lcw578/STM32-project/README.md

# STM32 Boost 恒压恒流电源（课程设计）

> **一句话**：STM32F103 数字控制的 Boost 升压电源——5V 输入、12V/0.5A 输出、100kHz 开关、PI 闭环，带过压/过流/断线三重保护。
>
> 工程名 `boost-cccv-psu`（嘉立创 EDA 专业版）｜ 当前版本 **v3 重建版（2026-11-05 发板）** ｜ 状态：**已提交嘉立创加工，待收板**

| 关键指标 | 要求 | v3 重建版仿真结果 |
|---|---|---|
| 输出电压 | 12V ±5% | **+0.075%** |
| 输出纹波 | ≤5% | **1.81%** |
| 恒流精度 | 0.5A ±5% | **−0.18%** |
| 软启动过冲 | 无过冲/不触 OVP | **49mV** |
| 保护 | OVP / OCP | OVP 13.2V 锁存 / OCP **0.6A**·5ms 锁存 |
| 输入跌落 | 5V±5% | 输出偏移 **20mV** |
| 效率 | 实测 ≥75% | 预算 ~87%，**待上板实测** |

---

## 一、目录导览（组员按这个顺序读）

| 顺序 | 文件/目录 | 是什么 |
|---|---|---|
| 0 | **本 README** | 项目全貌与协作方式 |
| 1 | `01_系统设计方案.md` | 指标、方案、选型、引脚分配（**v2 已修订对齐实装**） |
| 2 | `02_仿真验证计划.md` | 仿真的科目表（S1~S10）怎么设计的 |
| 3 | `03_仿真验证报告.md` | 全部仿真证据；**§11 是 v2 终版指标对齐表**（§5/§7 为 v1 历史） |
| 4 | `04_设计审计与整改清单.md` | 第二版之前发现的所有问题及处置（含闭环标注） |
| 5 | `05_第二版改版说明.md` | v2 改了什么、验证结果、遗留项 |
| 6 | `06_固件v2说明.md` | 固件架构、复跑数据、上板调试验证清单（v2.1 常数变更见其末节） |
| 7 | `07_3D干涉检查.md` | 3D 模型与装配约束 |
| 8 | **`08_第三版重建与发板说明.md`** | **v3 重建版：器件平替全表、位号对照、固件常数变更、仿真定稿** |
| — | `sim/` | Python 开关级仿真（ctrl/）+ ngspice 网表（ltspice/） |
| — | `firmware/` | STM32 固件源码（CubeIDE 工程的 Core 部分） |
| — | `sch_work/` | 全过程证据：网表快照、DRC 报告、BOM、3D 导出、布局图 |
| — | `嘉立创打样文件_v2.2.zip` | **发板用的 Gerber（v2.2，含泪滴+SW1修正）** |
| — | `easyeda-agent-connector-1.16.0.eext` | EasyEDA AI 协作连接器（组员装同款） |

`tools/`（ngspice 免装版二进制）与 `sim/ltspice/*.raw`（波形原始数据，可由 `.cir` 重跑再生）未入库。

---

## 二、组员如何用 AI 接手进度（核心）

> **工程链接**：[开源主页（oshwhub）](https://oshwhub.com/licw0615/project_fbaspzcp) · [编辑器直开](https://pro.lceda.cn/editor#id=35d238ebf1a643c5b3bafc39cbf5699f)

### 调试接口线序（J3/J4，接线必读）

| 口 | 用途 | pin1 | pin2 | pin3 | pin4 | 对接规则 |
|---|---|---|---|---|---|---|
| **J3** | SWD 烧录（ST-Link） | 3V3 | SWDIO | SWCLK | GND | 同名直连；杜邦线一根根接 |
| **J4** | 串口台（USB-TTL） | UART_TX | UART_RX | 3V3 | GND | **TX/RX 交叉**：板 TX → TTL 的 RX，板 RX → TTL 的 TX |

- 两个口的 GND 都在 pin4；J4 的 3V3 在 pin3（与 J3 不同），插错位置串口会不通，照上表接线即可。
- 板未上电时先接 J3 烧录，再上电；串口台随时可接。
- v3 的 J3/J4 为 2.54mm 排针**母座**（C54973823），杜邦公头直插。

### 1. 环境准备（每人）

1. **嘉立创 EDA 专业版**：官网下载；工程主人（lcw578）在 EDA 内把项目分享给你（见下方"工程分享"）。
2. **AI 连接器**：安装本仓库根目录的 `easyeda-agent-connector-1.16.0.eext`（EDA 内扩展 → 本地安装），或在你的 AI 助手里装同款 EasyEDA Agent skill。装好后 AI 能直接读写你打开的原理图/PCB。
3. **Python 3.11 + numpy + matplotlib**：跑仿真用。
4. **STM32CubeIDE**：编译固件用。

**工程分享（工程主人操作一次即可）**：

- **方式 A（推荐，实时协作）**：嘉立创 EDA Pro → 左侧「工程」面板 → 右键 `boost-cccv-psu` → **分享/协作** → 输入组员的立创账号（手机号/邮箱）→ 权限选"可编辑"。组员在自己 EDA 的"与我共享"里打开，AI 连接器即可直接操作。
- **方式 B（快照分发）**：`文件 → 导出` 嘉立创 EDA 专业版工程文件发给组员导入。缺点：之后两份副本各自演化、不能实时协作，合并要靠网表对账。
- 注意：GitHub 仓库里**只有 Gerber 和证据文件，没有可编辑的工程**——工程本体在嘉立创云端，必须走上面的分享。组员需注册立创账号（与邀请邮箱/手机号一致）。

### 2. 让 AI 对齐进度（把这段话发给你的 AI 即可）

```
请阅读仓库根目录的 README.md，然后按顺序读 01、04、05、06 四份文档，
重点看 05 的"验证结果"表和 06 的"上板验证清单"。
读完总结：当前设计状态、你负责的部分、以及接下来要做什么。
```

AI 读完后应能回答：当前版本号、关键指标、哪些已验证、遗留项在哪一节。

### 3. 协作铁律（谁改谁验证，改完必提交）

- **改文档**：改完随手 `git commit`，消息写清楚改了哪一节。
- **改原理图/PCB**：改完必须重跑对账——`sch read` 网表 29/29 一致、PCB DRC 0 违规，再把证据 JSON 存进 `sch_work/`。
- **改固件**：改完重跑 `sim/ctrl` 的对应场景（见下），数字变了必须同步更新 03 §11 / 05 / 06。
- **不要**在没有验证证据的情况下修改 03/05/06 里的任何数字。

---

## 三、仿真复跑（5 分钟上手）

```bash
cd sim/ctrl
python - <<'EOF'
import sys; sys.path.insert(0,'.')
import plant_boost; plant_boost.RC_TAU = 8.83e3*10e-9   # v2 实装采样常数
import scenarios; scenarios.P.dcr = 0.17                # v2 电感 DCR
s={}
scenarios.S4_load_step(s, kp_v=0.06, ki_v=50.0, tag='demo', plot=True)
print(s['S4_demo'])
EOF
```

- 全部场景见 `scenarios.py`（S1~S10）与 `s8_sweep.py`（稳定域网格）。
- 控制律在 `ctrl.py`，与固件 `firmware/Core/Src/control.c` **逐行对齐**——改固件先改这里验证。
- 存档约定：结果 JSON 存 `sim/ctrl/results/`，文件名带条件（如 `summary_v2_tau88.json` = τ=88.3µs 版）。

---

## 四、固件构建

1. CubeIDE 新建 STM32F103C8T6 工程（或直接导入 `firmware/` 内的 `.ioc`）；
2. 用仓库 `firmware/Core/Src|Inc` 的 5 个文件覆盖生成的同名文件（control.c/h、bsp_power.c、main.c、cli.c）；
3. **Project → Properties → C/C++ Build → Settings → MCU Settings** 勾选 *Use float with printf from newlib-nano*（否则串口打不出电压电流）；
4. 编译烧录；串口 115200，命令 `h` 看帮助。

---

## 五、发板三件套（v3 已下单）

| 用途 | 文件 |
|---|---|
| PCB 打样 | **已于 2026-11-05 深夜提交嘉立创**（v3 重建版，2 层板；Gerber 来源核验项见 08 §5） |
| SMT 贴片 | `sch_work/BOM_v3.csv`（29 行/46 器件，全部带立创 C 号，v3 位号） |
| 结构件 | 可选：板角已留 4×2mm 安装孔（非 M3），桌面演示可不固定 |

---

## 六、还需要做的事（按顺序）

| ⬜ | 事项 | 说明 |
|---|---|---|
| ⬜ | **收板验板** | 先目检走线完整性（重点：3V3 网络、MCU 信号网是否连通——发板 Gerber 来源核验项见 08 §5） |
| ⬜ | **建立 CubeIDE 工程** | 按 §四 导入 `firmware/`（v2.1 常数已并入）并编译通过 |
| ⬜ | **复核 L1 数据手册** | 打开立创 C41384377 详情页，对照 FSA1365 手册确认 **Isat 4A / DCR 170mΩ** |
| ⬜ | **首板联调** | 严格按 `06_固件v2说明.md` §5 顺序：不焊 Q1 → 3.3V → 栅极波形 → 功率级 → 保护；OCP 验证按 **0.6A**（08 §6） |
| ⬜ | **效率实测** | 额定点 12V/0.5A，电子负载 + 功率表；课程指标 ≥75%，预算 ~87% |
| ⬜ | **课程报告** | 素材：01~08 + `sch_work/` 证据 + 仿真 JSON |

---

## 七、风险与已知取舍（报告里要写的）

1. **L1 DCR 170mΩ > 原规格 ≤80mΩ**：换 SMD 电感消除 3D 干涉的主动取舍，效率预算 89%→87%。
2. **重载瞬态跌落 1090mV**（0→0.5A 硬阶跃、6.4ms 恢复）：课程只约束稳态 ±5%，瞬态无指标。
3. **OCP 整定 0.6A**（v2 为 0.8A）：Rs1 改 0.1Ω 后 INA 输出 5V/A，0.8A 超出 3.3V ADC 量程，0.6A=1.2 倍额定，保护功能不变。
4. **U2 换 XC6206**（200mA、最大输入 6V）：负载 <60mA 裕度充足，但 **3V3 只能由 5V 口馈电**，勿接其他电源。
5. **Y1 贴片晶振负载电容 22pF（等效≈14pF < 标称 20pF）**：晶振频率略偏高几十 ppm，UART 无影响；后续若用 USB/RTC 需改 ~33pF。
6. **LED 位号为 POWER/CV/CC**（非 LED1~3）：BOM 里以 C2286 归并，位号功能对照见 08 §2.4。
7. 原理图遗留视觉项（不影响电气）：24 根零长度导线、27 个未挂 NC 的悬空脚、9 个 `$1N*` 未命名网——下一版清理。
