lcw578/STM32-project/03_仿真验证报告.md

# 03_仿真验证报告 —— Boost 恒流恒压电源（固件控制环 + 功率级）

> 仿真验证智能体　|　版本 v1.0（2026-11-03）　|　输入：《01_系统设计方案.md》《02_仿真验证计划.md》、firmware/ 固件源码
> 原则：**不修改原理图、不修改固件**——所有"修复"均为仿真侧对照实现，对固件的修改以"建议清单"（§8）交付
> 结论速览：**发现固件级缺陷 4 项（含 2 项"上电即失败"级）、硬件安全隐患 1 项；全部有仿真证据与已验证的修复方案**

---

## 1. 工具链与产物位置

| 项 | 实际配置 | 说明 |
|---|---|---|
| 控制环仿真 | Python 3.11 + numpy/matplotlib（`sim/ctrl/`） | control.c 逐行移植 + 双档被控对象模型 |
| 功率级仿真 | **ngspice-44 免装版，`D:\Spice64\bin\ngspice_con.exe`**（批处理） | 网表 LTspice 兼容语法（`sim/ltspice/*.cir`），日后可直接用 LTspice GUI 打开 |
| 计划偏差 | 计划用 LTspice，实际用 ngspice | LTspice 64 位 MSI 在本机静默安装 4 次全部挂起（Windows Installer 卡死）；ngspice 引擎同为 SPICE 3F5 系，验证内容不变 |
| 运行器 | `sim/ctrl/run_all.sh` 见 §7；单项脚本均可独立重跑 | 结果 CSV/JSON/PNG 归档在 `sim/ctrl/results/`、`sim/ltspice/` |

## 2. 仿真模型可信度（先证模型，再谈结论）

### 2.1 Python 开关模型 ↔ SPICE 交叉验证（判据：偏差 <10%）

同一工况（D=0.6194 / 446 counts、Vin=5V、24Ω 满载、稳态窗口）对比：

| 指标 | ngspice (T1) | Python 开关模型 | 偏差 | 判定 |
|---|---|---|---|---|
| Vout 平均 | 12.582 V | 12.318 V | 2.1% | ✓（偏差来自二极管常数：ngspice B340A 模型 Vf≈0.38V，Python 用手册固定值 0.45V） |
| 输出纹波 pp | 108.6 mV | 105.9 mV | 2.5% | ✓ |
| 电感电流峰值 | 1.544 A | 1.497 A | 3.0% | ✓ |
| 电感纹波 ΔIL | 0.306 A | 0.29~0.31 A | ~2% | ✓ |

逐周期波形叠加图见 `sim/ctrl/results/T_cross_validation.png`——**IL 波形两条几乎完全重合**。模型可信，闭环结论有资格外推到实物。

### 2.2 开环工作点 vs 解析解（S1）

| 占空比 | 仿真 Vout | 计损耗解析解 | 偏差 | 理想 5/(1−D) |
|---|---|---|---|---|
| 0.583 (420) | 11.435 V | 11.411 V | **0.22%** | 12.0 V |
| 0.619 (446) | 12.318 V | 12.512 V | 1.55% | 13.14 V |

### 2.3 T2 占空比扫描：Vout(D) 曲线（ngspice）

| D | 0.40 | 0.45 | 0.50 | 0.55 | 0.583 | 0.619 | 0.65 |
|---|---|---|---|---|---|---|---|
| Vout (V) | 7.91 | 8.65 | 9.55 | 10.62 | 11.47 | 12.58 | （泵升区） |
| 与解析解偏差 | <1% | <1% | <1% | <1% | 0.5% | 0.55% | — |

Boost 关系曲线形状与损耗修正全部符合预期。

---

## 3. 发现的固件缺陷（仿真证据链）

> 以下缺陷均由"固件原样移植 + 真实功率级模型"复现，不是推测。

### F1【致命】软启动方式错误：每次上电必然触发 OVP 锁存，无法启动

- **证据 S2_firmware_asis**：固件原样（duty_ramp + track），24Ω 满载，**38.2ms 处 Vout 越过 13.2V → OVP 立即锁存**，占空比归零，启动失败。图：`S2_firmware_asis.png`
- **机理**：软启动只对占空比做 0→612 斜坡限幅，PI 积分器不受约束——误差约 2000 counts 时积分器以 30 counts/拍增长，**1.7ms 内饱和到 612**；此后 PI 输出恒大于斜坡限幅，占空比被斜坡推着走，Vout 跟随 D 上升，在 D≈0.63（对应 13.2V）处必然越线。数值完全对上（理论预测 37.6ms，仿真 38.2ms）。
- **交叉证据 T3（ngspice 开环）**：纯占空比斜坡 0→0.85/50ms，若无 OVP 拦截，Vout 泵升至 **30.96V**、电感 **13.9A**——越过所有器件规格。斜坡限幅软启动对本拓扑（Boost + 13.2V OVP）在原理上不可用。

### F2【严重】"双环取小 + 反算跟踪"结构在 CC/CV 临界点形成 2 拍极限环，占空比被钉死

- **证据 S3_firmware_track_knee**：24Ω = 12V/0.5A 恰为临界负载。稳态电压 **11.716V（误差 −2.318%）**，两个环误差恒为 +77/+37 counts 不收敛。
- **微观 trace（2 拍周期，无限重复）**：

  | 拍 | duty_v | duty_i | 输出 duty | 状态 | 结果 |
  |---|---|---|---|---|---|
  | A | 433.0 | 431.9 | 431 | CC | pi_v 被反算跟踪重写（本拍积分丢失）|
  | B | 431.9 | 432.2 | 431 | CV | pi_i 被反算跟踪重写（本拍积分丢失）|

  每个环的积分增长都在下一拍被 track 重写丢弃，占空比永远钉死在 431（低于两个目标）。机理与负载恰落在量化死区有关，但结构性的——任何"取小+反算"实现都有此模式。
- **伴生现象（S5_firmware_asis_deficit）**：欠额工况（CC 负载 0.55A > 0.5A 限流）下，输出塌落到二极管直通平台 ≈4.5V 且无法恢复，限流在 D≈0 时不可执行。

### F3【严重】默认 PI 参数下，负载卸载（0.5A→0）必然触发 OVP 锁存

- **证据 S4_default（修复架构 + 固件默认参数 kp_v=0.05/ki_v=150）**：卸载过冲 >1.2V → OVP 锁存。
- **根因不是增益，是能量+时延**：卸载瞬间电感仍持有 ~1.25A、占空比停在 ~430，原流向负载的功率全部转为对输出电容充电（~2V/ms），而 10kHz 控制环最早 2~3 拍后才能响应——6 拍内即越 OVP 线。
- **排除实验**：kp_v 从 0.06 加到 0.5（5 组），全部 >1.2V 触发；且 kp≥0.3 后 CV 稳态纹波恶化到 820~900mV（10kHz 采样下高 kp 极限环）。
- **已验证修复**：见 §5"卸载快斩"——过冲降到 **233mV**，无故障。

### F4【硬件安全隐患·最高优先级】硬短路时 OCP 关断 PWM 无法切断故障电流

- **证据 S6**：输出突接 0.05Ω 短路。OCP 在 **恰好 5.0ms** 时正确锁存（该部分保护逻辑工作正常），但锁存后占空比=0 **并不能切断电流**：Boost 的 L→D1 二极管路径始终把输入直通到输出，仿真显示 **短路电流 ~35A 永续存在**（解析下限 (5−0.45)/(DCR+Rs+R短) = 25.3A）。
- **后果**：电感 Isat 仅 2.7A（磁饱和后电流只受 DCR 限制）、50mΩ 采样电阻 1W 额定对应持续 4.5A——**硬短路 1 秒内即烧件**。
- **对策**：见 §8 建议 R1（保险丝从"可选"改"必装"并按 ≥30A 分断能力校核）。

### F5【文档】设计文档与固件的 4 处不一致（仿真按固件为准）

| 项 | 文档 §5.7/5.8 | 固件实际 | 仿真取值 |
|---|---|---|---|
| 控制环更新率 | 每开关周期采样（100kHz） | 10kHz（TIM2 节拍） | 10kHz |
| 硬 OCP 判决时间 | 10ms | 5ms（50 拍） | 5ms |
| 软过流阈值 | 0.6A | 0.7A 定义但未引用 | — |
| ADC 采样方式 | TIM1 触发、与开关同步 | 连续扫描+DMA，与开关相位异步 | 异步（S9 量化其影响） |

---

## 4. 修复方案（仿真侧对照实现，固件未动）

### 4.1 控制架构：CV 调节器 + 电流限幅器（limiter，替代"双 PI 取小"）

```
duty = min( CV 环 PI 输出 , 电流限幅器输出 )
  电流限幅器：纯积分器；iout > i_set 时全速下压，欠流时按 0.2×ki_i 慢速放松
  CV 环被限幅期间反算跟踪（防饱和、切换无扰）
```

单调节器结构机理上不存在双环互钳死锁（F2 消失）；CC 段为纯积分限流，无静差（S5 实测 −0.41%）。
非对称放松速率用于抑制临界点抖振（对称版在临界点纹波 1052mV，非对称后 244mV）。

### 4.2 软启动：斜坡电压基准（ref_ramp，替代斜坡占空比限幅）

v_ref = 12V × ss_cnt/500，PI 调节跟踪给定。斜坡限幅仅作后备。F1 消失（S2 过冲 67mV）。

### 4.3 卸载快斩（新增保护逻辑，1 拍级）

电流单拍突降 >400 counts（电子负载硬阶跃特征）→ 开启 10 拍授权窗口；窗口内一旦 Vout 越过目标（err_v<0），积分器逐拍 ×0.45 塌向 DCM。撤销泵入源后峰值仅 +233mV。F3 消失。
（附注：另实现了过压快泄 err_v<−0.2V 时 25 倍速退火；实现时注意符号——积分器应随负误差加速下降。）

### 4.4 PI 参数：S8 稳定域扫描（平均模型，卸载+恢复+稳态精度判据）

稳定域：**kp_v ≤ 0.08 且 ki_v ≤ 65**（kp_v=0.12 起出现持续振荡，kp_v=0.5 在 10kHz 采样下 ±0.45V 极限环）；推荐 **kp_v=0.06 / ki_v=50**（区域中心，四面有裕度；网格点实测：稳态误差 30mV、建立 4.7ms、±5% 带恢复 11.6ms）。kp_v=0.04~0.08 × ki_v=30~65 全部可用。ki_i（限流环）在 CV 场景不参与，CC 场景纯积分器稳态与增益无关，保持 80 即可。
热力图：`results/S8_sweep.png`。

---

## 5. 修复对照架构的完整验证结果（S1~S10，判据对照课程指标）

> ⚠ 本节为 **v1 版本**结果（原电感、v1 控制律、采样 τ=883µs）。v2 终版复跑与指标对齐见 **§11**。

| 场景 | 内容 | 关键结果 | 判定 |
|---|---|---|---|
| S1 | 开环工作点 | 与解析解偏差 0.22%/1.55% | ✓ 模型自检 |
| S2 | 软启动（24Ω 满载） | 过冲 **67mV**，浪涌 **1.69A** < Isat，无 OVP，建立 54.8ms | ✓ |
| S3 | CV 稳态（临界点 24Ω） | **12.0031V（+0.075%）**，纹波 **244mV=2.04%**（指标 ≤5%，目标 ≤3%），IL_pk 1.53A | ✓ |
| S4_tuned | 负载阶跃 0.5A→0→0.5A | 卸载过冲 **233mV 无故障**；重载跌落 5.9V（硬阶跃+10kHz 环路物理极限），±5% 带恢复 **19.4ms** | ✓（跌落幅度记录在案） |
| S5 | CC/CV 切换（30Ω→20Ω→30Ω） | CC 段 **0.4979A（−0.41%）**，V=9.958V（理论 10.0V），恢复 18.7ms | ✓ |
| S6 | 输出硬短路 | OCP **5.0ms 准点锁存**；锁存后持续电流 ~35A（→F4，保护缺口在硬件层） | ✓逻辑 / ⚠硬件 |
| S7 | OVP 注入（3600 counts×2 拍） | **2 拍内锁存**，锁存保持，占空比归零 | ✓ |
| S9 | 采样链混叠/量化 | 基线读数偏差 **−8mV / 0.01mA**；最坏瞬时相位 −52mV / 2.4mA（<0.5%）——20µs S/H 孔径+电压路 RC 足以抑制开关纹波混叠，无需改动采样链 | ✓ |
| S10 | 输入 5.0→4.75V | 最大偏差 **28.8mV**，占空比 0.613 < 0.85 限幅 | ✓ |

> 状态标志说明：临界点附近 CV/CC 状态标志存在 ~kHz 级抖动（LED 观感），占空比与输出电平平滑无影响，属显示层瑕疵（建议加 2 拍锁存去抖，见 §8 R6）。

## 6. 功率级 SPICE 验证（T 系列，ngspice）

| 运行 | 内容 | 结果 | 对照 |
|---|---|---|---|
| T1 | D=0.6194 稳态 | Vout 12.58V、纹波 108.6mV、IL_pk 1.54A、ΔIL 0.306A | 手算纹波 0.14V 量级 ✓、ΔIL 0.29A ✓ |
| T2 | D=0.40~0.65 扫描 | Vout(D) 与损耗解析解偏差 ≤1% | §2.3 表 |
| T3 | 开环占空比斜坡软启动 | D=0.85 终点 Vout 泵至 **30.96V**、IL **13.9A**；冷启动浪涌 **8.7A**（t=0 电容经 L-D 充电，首个上电周期，Isat 的 3.2 倍） | 证实 F1 机理；冷启动浪涌见 §8 R3 |
| T4 | 器件应力（T1 数据） | MOS Vds 峰值 **13.13V**（规格 30V，裕度 2.3 倍）；D1 反压 ≈Vout 12.6V（规格 40V）；D1 平均电流 0.5A（规格 3A） | ✓ 全部裕度充足 |

T5（RC 吸收）未做：T1 的 SW 节点无有害振铃（Vds 峰值即 Vout+0.5V），方案中"预留焊位不贴片"的决策得到支持。

---

## 7. 判据对照总表（课程指标 → 仿真验证状态）

> ⚠ 本节为 **v1 版本**（原直插电感 DCR≈80mΩ、v1 控制律）的对照。最终版对齐表见 **§11**（新电感 DCR=0.17Ω + v2 固件控制律复跑）。

| 课程指标 | 仿真结果 | 状态 |
|---|---|---|
| 输出 12V，稳态误差 ≤±5% | +0.075%（S3，修复架构） | ✓（固件原样在临界点 −2.3%，仍达标但劣化，见 F2） |
| 恒流 0.5A，误差 ≤±5% | −0.41%（S5） | ✓ |
| 纹波 ≤5%（目标 ≤3%） | 2.04%（S3） | ✓ |
| 软启动无过冲 | 过冲 67mV（S2） | ✓（须按 §8 R2 修改软启动方式） |
| 保护：OVP/OCP/D 限幅 | OVP 2 拍锁存、OCP 5ms 锁存、D≤0.85 | ✓ 逻辑层；硬短路缺口见 F4 |
| CC/CV 无扰切换 | 切换恢复 18.7ms，无输出振荡 | ✓（限流器架构） |
| 开关频率 100kHz | T1/T2 网表即 100kHz | ✓ |
| 效率 | 未仿真（需实测损耗模型），预算 82~86% 不变 | 待实测 |

## 8. 修改建议清单（v1 时点：供决策；**已于 v2 全部执行**——固件 R2~R5/F6~F8 见 06，硬件 R1 见 05，文档 R8/F5 见 01 v2 修订）

**固件（firmware/Core/Src/control.c）**
- R2 软启动改为斜坡电压基准（§4.2，1 行语义替换）——**不修则每次上电 OVP 锁存**
- R3 主循环结构改为"CV 调节器 + 电流限幅器"取小（§4.1，替换 pi_track 段）——消除临界点钉死与欠额塌落
- R4 新增卸载快斩（§4.3，约 5 行）——消除卸载 OVP 锁存
- R5 PI 参数 kp_v=0.06、ki_v=50（S8 稳定域中心；kp_v=0.05 可保留，ki_v 必须从 150 降档）
- R6 CV/CC 状态标志加 2 拍去抖（显示层）

**原理图/硬件（嘉立创EDA，本次未动图）**
- R1 **输入自恢复保险 F1 从"可选"改为"必装"**，并按硬短路直通电流 ≥30A 校核分断能力（F4 的唯一硬件屏障）；评估 D1 换同步 NMOS 的可行性（关断可控，根治直通路径）
- R7 冷启动浪涌（首上电 8.7A > Isat）：可接受（单次 ~0.3ms），或在 5V 输入端加 NTC/软启动电路；答辩可作讨论点

**文档（01_系统设计方案.md）**
- R8 修订 §5.7/5.8 与固件的 4 处不一致（F5 表）

## 9. 局限性声明

1. 仿真为"参数方向性验证 + 逻辑验证"，不承诺复现实物波形（布局寄生、VDDA 偏差、ADC 噪声未建模）；
2. MOS/二极管为手册参数等效模型（AO3400A：Vto=1.0V/Rd=15mΩ 级；B340A：IS=1e-7/N=1.05/RS=28mΩ），非厂商官方 SPICE 模型，绝对数值有 ±5% 级不确定度，趋势与裕度结论可靠；
3. 电感按线性 100µH+DCR 建模（Isat 2.7A > 工作峰值 1.53A，线性假设成立；硬短路工况下饱和后的真实电流需实测）；
4. 效率、EMI、热未在本次范围（对照 §7）。

## 10. 产物清单

```
sim/ctrl/            plant_boost.py  ctrl.py  scenarios.py  s8_sweep.py  s9_aliasing.py
sim/ctrl/results/    summary_main.json  summary_s8.json  summary_s9.json  summary_s4_tuned.json
                     S2_firmware_asis.png  S2_S3_fixed.png  S3_track_knee.png  S4_default/tuned.png
                     S5_fixed.png  S5_asis_deficit.png  S6_short.png  S7_ovp.png
                     S8_sweep.png  S10_vin_sag.png  T_cross_validation.png
sim/ltspice/         T1_boost_steady.cir  T1b_fine_window.cir(+T1b_wave.csv)  T2_duty_sweep.cir
                     T3_softstart.cir   （LTspice 兼容语法，可用 LTspice GUI 打开复跑）
D:\Spice64\          ngspice-44 免装版（批处理：bin\ngspice_con.exe -b xxx.cir）
```

---

## 11. v2 终版复跑：课程指标对齐表（2026-11-03）

> 条件：电感 **FSA1365-101MT（DCR=0.17Ω）** 替代原 80mΩ 规格、真实采样 τ=**88.3µs**（分压阻抗 8.83kΩ × C10 10nF，v2 实装值）、
> **v2 固件控制律**（斜坡电压基准 + CV 调节器/电流限幅器 + 卸载快斩 + 负载跃升前馈 0.26，kp_v=0.06 / ki_v=50）。
> 全部场景为开关模型，逐场景复跑，与 §7 的 v1 结果不混用。

| 课程指标 | 要求 | 仿真结果（场景） | 状态 |
|---|---|---|---|
| 输入电压 | 5V ±5%（4.75~5.25V） | 4.75V 跌落工况：输出偏移 **18.8mV**，占空比 0.622 未触 0.85 限（S10） | ✓ |
| 输出电压 | 12V，稳态误差 ≤±5% | **12.0031V（+0.074%）**（S3） | ✓ |
| 恒流值 | 0.5A，稳态误差 ≤±5% | **0.4983A（−0.33%）**，V=9.966V（S5） | ✓ |
| 输出纹波 | ≤5%（≤0.6V） | **156mV（1.3%）**（S3） | ✓ |
| 软启动 | 无过冲、不误触 OVP | 过冲 **38mV**、浪涌 1.692A、无 OVP（S2） | ✓ |
| CC/CV 切换 | 无振荡、无静差 | 恒流段标志 **0 抖动**，回到 ±1% 用 159ms（S5） | ✓ |
| 保护：OVP | >13.2V 锁存 | 注入后 **0.2ms 锁存**、保持、占空比归零（S7） | ✓ |
| 保护：OCP/硬短路 | 0.8A 延时锁存 | 电容 dump 峰值 27.7A，**5.0ms 锁存 FAULT_OCP**（S6）——固件层缓解；硬短路根治仍靠 F1 保险（§8 R1） | ✓* |
| 负载阶跃（瞬态，课程无指标） | — | 卸载 0.5A→0 过冲 306mV；重载 0→0.5A 跌落 **1187mV**、6.5ms 恢复（S4，v1 为 5907mV） | 备注① |
| 开关频率 | 100kHz | TIM1 72M/720，占空比分辨率 1/720 | ✓ |
| 稳定裕度 | 数字 PI 全工况稳定 | S8 网格：**kp≤0.08 且 ki≤65 全通过**（含推荐组合 0.06/50，膝点误差 27mV）；ki=80 失稳（固件用 50，不受影响） | ✓ |
| 效率 | **实测**，额定点 ≥75% | 不在仿真范围；预算 **~87%**（较原 80mΩ 规格降约 2%，仍 ≥75%） | **待实测** |

**备注①**：S4 的内部判据“卸载后 50ms 回到 ±1%”未达（实测 157ms）——空载时输出仅经 46k 分压 + 10k 泄放放电，
回到 ±1% 自然就慢；最大偏差 306mV（2.5%）仍小于 ±5% 指标。重载跌落 1969mV 为 0→0.5A 硬阶跃瞬态，
课程无瞬态指标，稳态恢复后达标。

**对 01 设计书的偏离（须在报告中声明）**：电感 DCR 170mΩ > 规格书 ≤80mΩ——为消除 L1/C5 高度冲突
换 SMD 一体成型电感，代价约 2% 效率（89%→87%），收益是 13.5×12.6mm 全屏蔽、可自动化贴装、无 3D 干涉。

**复跑存档**：`results/summary_v2_tau88.json`（**S1–S7、S10 全场景**，τ=88.3µs）+ `summary_s8_tau88.json`（S8）。
**固件对应实现**：`firmware/Core/Src/control.c`（v2），逐行与 `sim/ctrl/ctrl.py` 对齐。

---

## 12. v3 重建版复跑（2026-11-05，当前原理图定稿口径）

> 原理图全板重建 + 器件平替后，按**实装值**复跑全场景（Rs1=0.1Ω 固件已配套、
> Cout=C10 220µF/50V 电解(ESR 0.3Ω 代表值，0.15/0.5 边界) + 2×22µF 陶瓷(偏压后≈22µF)、
> 分压 3k+33k/10k=10/46、τ=88.3µs、INA 增益 5V/A）。位号重排不影响拓扑（逐网 diff 无损）。

| 场景 | 结果 | 指标 | 判定 |
|---|---|---|---|
| S2 软启动 | 过冲 49mV，浪涌 1.6A，无 OVP | 无过冲 | ✅ |
| S3 稳态 24Ω | 12.0032V（+0.075%），纹波 218mV（1.81%） | ±5% / ≤5% | ✅ |
| S4 负载阶跃 | 卸载过冲 296mV（无故障）；加载跌落 1090mV / 6.4ms | 稳态 ±5%（瞬态无指标） | ✅ |
| S5 恒流 | −0.18%，无振荡 | ±5% | ✅ |
| S6 短路 | OCP 5ms 锁存（0.6A 整定） | 有保护 | ✅ |
| S7 OVP | 立即锁存保持 | 有保护 | ✅ |
| S10 输入 4.75V | 偏差 20mV | ±1% | ✅ |
| S8 网格（重建参数） | kp_v≤0.08 / ki_v≤65 稳定，推荐点 kp_v=0.06 / ki_v=50 四周有裕度 | — | ✅ |

**与 v2 数字差异说明**：纹波 1.3%→1.81%（输出陶瓷 10µF→22µF 偏压后、电解 ESR 口径不同）、
恒流 −0.33%→−0.18%（Rs1 0.1Ω 信噪比更好）、软启动 38mV→49mV——均在指标内且同数量级。
LOAD_FF 0.26→0.13 为 counts 口径换算（物理前馈等价），0.26 在新口径下会把环路打进限幅（8V 跌落），已修正。

**复跑存档**：`results/summary_rebuild_current_sch.json`（S1–S10 + ESR 边界）+ `summary_ff_rescale.json`（LOAD_FF 口径验证）
+ `summary_c250_cap.json`（电容方案边界）。**模型镜像**：`sim/ctrl/plant_boost.py`/`ctrl.py`/`scenarios.py` 默认值已同步重建版口径。
