lcw578/STM32-project/06_固件v2说明.md

# 06_固件 v2 说明

> 日期：2026-11-03　|　依据：《04_设计审计与整改清单》R2~R5 / F6~F8、《05_第二版改版说明》
> 结果：**control.c / control.h / bsp_power.c / main.c / cli.c 已按 v2 控制结构重写；仿真复跑 S2/S3/S4/S5/S8 全部通过。**

---

## 1. 改了哪些文件

| 文件 | 改动 |
|---|---|
| `Core/Src/control.c` | 重写：斜坡电压基准软启动、CV 调节器 + 电流限幅器、卸载快斩、负载跃升前馈、反馈断线保护、CC/CV 标志去抖 |
| `Core/Inc/control.h` | 新增 `ST_FAULT_FB`；`g_state/g_duty/g_vout/g_iout` 改为 `volatile`；`control_start()` 返回 int |
| `Core/Src/bsp_power.c` | TIM2 改为更新中断（NVIC 优先级 1），新增 `TIM2_IRQHandler()` 调 `control_10k()`；保留旧轮询函数 |
| `Core/Src/main.c` | 主循环只跑 `cli_poll()`，控制环不再在主循环 |
| `Core/Src/cli.c` | `on` 处理拒绝返回值；`sv` 上限收到 12.8V；新增 `ovp` 测试命令；参数写入加临界区；`d` 先启动再置开环 |
| `README_固件导入.md` | 命令表、OVP 测试方法、浮点 printf 设置、v2 偏差说明 |

---

## 2. 控制结构（与 `sim/ctrl/ctrl.py` 逐行对应）

```
软启动（50ms）: v_ref = v_set × ss_cnt/500
                duty = min( PI(v_ref − Vout), 电流限幅器, 占空比后备斜坡 )

运行:  lim = 电流限幅器(过流全速下压 / 深度欠流全速放松 / 临界点 0.2×)
       duty = min( kp_v·err_v + integ_v , lim )
       CV 被限幅时反算跟踪 integ_v = lim − kp_v·err_v（防饱和、切换无扰）
       卸载快斩：Δi < −400 开 10 拍窗口，窗口内 err_v<0 → integ ×0.45
       负载前馈：Δi > +100 且 iout ≤ i_set+100 → integ += 0.26·Δi
       反馈断线：duty>0.69 且 Vout<8V 连续 5ms → FAULT_FB 锁存
```

关键常数（与仿真一致）：
- `kp_v=0.06 / ki_v=50`（S8 稳定域中心）
- `ki_i=80`（限幅器速率），`LIM_RELAX=0.2`，深度欠流阈值 `0.8×i_set`
- `LOAD_FF=0.26`，阈值 100 counts
- 快斩：`0.45`，窗口 10 拍，突降阈值 400 counts
- 快泄：`err_v < −54 counts` 时 `25×ki_v` 速率退火
- 反馈断线：`duty>500` 且 `Vout<2160` 连续 50 拍
- 启动联锁：`Vout<800`（≈3V）拒绝开 PWM

---

## 3. 复跑结果

条件：`DCR=0.17Ω`（新电感 FSA1365-101MT）、采样 τ=**88.3µs**（v2 实装值：分压阻抗 8.83kΩ × C10 10nF）、`load_ff=0.26`。

| 场景 | v1 原报告 | **v2 固件** | 判定 |
|---|---|---|---|
| S2 软启动（24Ω） | 过冲 67mV，浪涌 1.69A | **过冲 38mV，浪涌 1.692A，无 OVP** | ✓ |
| S3 CV 稳态（24Ω） | 12.0031V(+0.075%)，纹波 2.04% | **12.0029V(+0.024%)，纹波 156mV=1.3%**，IL_pk 1.57A | ✓ |
| S4 卸载 0.5A→0 | 过冲 233mV，重载跌落 5907mV | **过冲 306mV，重载跌落 1187mV，恢复 6.5ms，无故障** | 跌落改善 5 倍 |
| S5 CC/CV（30→20→30Ω） | CC −0.41%，标志抖 1022 次 | **CC 0.4983A(−0.33%)，V=9.966V，标志抖动 0 次** | ✓ |
| S8 稳定域 | kp≤0.08（DCR=0.08Ω） | **kp≤0.08 且 ki≤65 通过（ki=80 失稳；固件用 50）** | ✓ |

> S4 的 `pass_step` 仍为 false，原因是判据要求“卸载后 50ms 内回到 ±1%”，而空载时输出只经
> 46k 分压+10k 泄放放电，回到 ±1% 需要上百毫秒；输出最大偏差只有 306mV（2.5%），
> 这是测量判据问题，不是控制问题。重载跌落已从 5907mV 降到 1187mV（τ=88.3µs 实装值复跑）。

**S5 的恢复时间**（20→30Ω 后回到 ±1%）为 159ms，比原报告的 18.7ms 慢；原因是新 limiter
在临界点用 0.2× 慢放松 + CV 积分较慢。稳态精度和抖动都更好，若答辩需要更快的恢复，
可把 `ki_v` 提到 65~80（S8 显示仍稳定），但 159ms 已满足“无振荡、稳态达标”。

---

## 4. 已知限制

1. **未上板验证**：以上全部是仿真；实物首板必须按 §5 的顺序逐级验证。
2. **未在本机编译**：本机没有 ARM 工具链（未找到 arm-none-eabi-gcc），只做了括号/语法静态检查。
   请在 STM32CubeIDE 里从 `.ioc` 生成工程、拷入 `Core/Src` 的 5 个文件后编译。
3. **浮点 printf**：必须在 CubeIDE 勾选 “Use float with printf from newlib-nano”，否则 `st` 打不出电压电流。
4. **TIM2 中断重复定义**：如果以后在 .ioc 里也启用 TIM2，CubeMX 会在 `stm32f1xx_it.c` 生成
   `TIM2_IRQHandler`，与 `bsp_power.c` 里的定义冲突——二选一。
5. **`ovp` 测试后**：`v_set` 仍是 13.3V，必须先 `sv 12.0` 再 `clear`，否则下一次 `on` 立即再锁存。
6. **S4 跌落 1.19V**：这是 10kHz 环路 + 0→0.5A 硬阶跃的折中（τ=88.3µs 实装值复跑）；
   前馈 0.28~0.30 可压到 1.2V 附近，但 0.34 以上失稳，故取 0.26 留裕度。

---

## 5. 上板验证清单（首板）

- [ ] 不焊 Q1，5V 上电，量 3.3V / 5V；`st` 看 raw[0] ≈1215（4.5V 直通）
- [ ] 示波器看 PA8→栅极：应为 0.7/2.6V 方波，沿 <100ns（验证 Q3 修复）
- [ ] `d 100/200/300` 开环，万用表看输出按 Boost 关系上升
- [ ] `o` → `on`，看软启动 50ms、无 OVP、稳定 12V
- [ ] 电子负载 0.1→0.5A，看 CV 稳压与 CC 切换；`st` 看模式标志不抖
- [ ] `ovp` 触发锁存 → `sv 12.0` → `clear`
- [ ] 短路测试（串保险丝！）：OCP 5ms 锁存；**断电后**再查保险丝
- [ ] 满载 30min，红外/手摸 Q1、D1、L1 温升

---

## 6. 文件清单

```
firmware/Core/Src/control.c      v2 控制主体
firmware/Core/Inc/control.h      ST_FAULT_FB / volatile / int control_start
firmware/Core/Src/bsp_power.c    TIM2 中断 + 10kHz 控制
firmware/Core/Src/main.c          主循环只跑 CLI
firmware/Core/Src/cli.c           on/sv/ovp/d 命令更新
firmware/README_固件导入.md        v2 说明与浮点 printf 设置
sim/ctrl/ctrl.py                 同步 v2：负载前馈、深度欠流放松、状态去抖
sim/ctrl/scenarios.py            fixed_cfg 加 load_ff=0.26
sim/ctrl/results/summary_v2_tau88.json   S1–S7、S10 复跑（τ=88.3µs 实装值）
sim/ctrl/results/summary_s8_tau88.json   S8 稳定域（τ=88.3µs）
sim/ctrl/results/summary_v2_all.json     τ=883µs 保守版对照（结论一致）
```

---

## 7. v2.1 常数变更（v3 重建版配套，2026-11-05 已并入 `firmware/`）

> 重建版 Rs1 采样电阻从 0.05Ω 改 **0.1Ω**（C25334），电流链 counts 口径全部 ×2；
> 电压链（分压 3k+33k/10k = 10/46、τ=88.3µs）不变。改动只涉及常数，控制结构未动。

| 常数 | 文件 | v2 | v2.1（0.1Ω 口径） |
|---|---|---|---|
| ADC_IOUT_GAIN | bsp_power.h | 0.00032234f | **0.00016117f** |
| ADC_IOUT_DIV | bsp_power.h | 3102.3f | **6204.5f** |
| ISET_DEFAULT_COUNTS | bsp_power.h | 1551u | **3102u**（0.5A） |
| OCP_HARD_COUNTS | bsp_power.h | 2482u（0.8A） | **3723u（0.6A）**——0.1Ω 下 0.8A→4.0V 超 3.3V ADC 量程 |
| OCP_SOFT_COUNTS | bsp_power.h | 2172u | **3412u**（0.55A，存档） |
| UNLOAD_DROP_COUNTS | control.c | 400 | **800** |
| LOAD_FF | control.c | 0.26f | **0.13f**（counts 口径减半，物理前馈不变） |
| LOAD_FF_THRESHOLD | control.c | 100（+100） | **200（+200）** |

配套复跑：`sim/ctrl/results/summary_rebuild_current_sch.json`（S1–S10 全过，详见 03 §12 与 08 §4）。
**上板 OCP 验证按 0.6A**（加载至 0.6A 应 5ms 锁存；0.8A 不会触发——量程所限）。
