lcw578/STM32-project/08_第三版重建与发板说明.md

# 08_第三版重建与发板说明（v3）

> 日期：2026-11-05 ｜ 性质：**原理图全板重建 + 器件平替 + 固件配套修订 + 仿真复跑定稿**
> 基线：v2（05 号文档）｜ 校验工具：easyeda-agent v1.16.0 现场只读对账 + `sim/ctrl` 全场景复跑
> 结论：**原理图电气拓扑与 v2 完全一致（29 网逐网 diff 无损），器件平替后全指标仿真达标，固件常数已配套修订。**

---

## 1. 为什么要重建

- v2 原理图经过多轮补丁，旗子堆叠、视觉状态差；组员在嘉立创 EDA 里**重新绘制**了整张原理图（分区更清晰、带中文注释、无旗子堆叠）。
- v2 部分 BOM 用了**SMT 扩展库料**（较贵），本次换为基础库/低价平替。
- 换型过程中发现并修复了两处 **v2 遗留硬伤**：Rs1 采样电阻标定不一致、输出电容方案与仿真口径脱节（详见 §3/§4）。

## 2. 器件变更总表（v2 → v3，全部经现场回读核对）

### 2.1 主控与外围（不变）

| 位号(v3) | 型号 | C 号 | 说明 |
|---|---|---|---|
| U1 | STM32F103C8T6 | C8734 | 不变 |
| U3 | INA180A2IDBVR（G=50） | C192764 | 不变 |
| L1 | FSA1365-101MT 100µH/4A 饱和/DCR 170mΩ | C41384377 | 不变 |
| D1 | SS34（SMA） | C8678 | 与 v2 B340A 同级 |
| J1/J2 | KF301-5.0-2P 端子 | C474881 | 不变 |

### 2.2 平替换型（v2 料 → v3 料）

| 位号(v3) | v3 型号/C号 | v2 原料 | 换型理由/影响 |
|---|---|---|---|
| Q1 | AO3400A / C20917 | C700953 | **恢复仿真/固件假设的管子**（30V/5.7A/48mΩ@2.5V），栅极驱动 0~4.3V 兼容 |
| Q2/Q3 | SS8050 / C2150，SS8550 / C8542 | C2931719/C2931720 | 同族替代，图腾柱功能不变 |
| U2 | **XC6206P332MR-G / C5446**（3.3V 200mA，SOT-23-3） | AMS1117 族 5 脚 | ⚠️ 最大输入 6V——本板 3V3 只准由 5V 口馈电（5.25V 最大 < 6V ✓）；负载 <60mA << 200mA ✓ |
| Y1 | X50328MSB2GI 8MHz 贴片（CL=20pF）/ C115962 | C271661 直插 | 改贴片；C11/C12=22pF → 等效 CL≈14pF，晶振跑快几十 ppm，UART 无影响（不用 USB/RTC） |
| SW1 | TS-1187A-B-A-B / C318884 | C9900004221 | 立贴 5.1×5.1，功能等价 |
| J3/J4 | **LAIL-PM2.54-4P-L 2.54mm 4P 母座 / C54973823** | C54620387 | 线序不变（J3=3V3/SWDIO/SWCLK/GND，J4=TX/RX/3V3/GND），额定 3A |
| 全部 R/C | 厚声/风华/三星基础库料 | 各扩展料 | 阻容值逐一核对与 v2 等值（见 §2.4 对照表） |

### 2.3 关键整改件（v2 没做对，v3 修正）

| 项 | v2 状态 | v3 状态 | 说明 |
|---|---|---|---|
| **F1 输入保险丝** | 0Ω 跳线（C17888，无保护作用） | **C41342 = Littelfuse 0468003.NRHF，1206 一次性 3A/32V** | 恢复 04 审计 A5 要求的输入唯一屏障；工作电流 ~1.4A，3A 整定合理。基础库无保险丝（官方类目 59550 件全扩展库），此料 ¥0.56 |
| **Rs1 采样电阻** | 0.05Ω | **0.1Ω（1206W4F100LT5E / C25334）** | ADC 信噪比更好（0.5A→2.5V）；**固件 6 个常数已同步改**（见 §3），OCP 整定 0.8A→0.6A |
| **输出电容** | 220µF 电解 + 10µF 陶瓷（仿真口径） | **C10 = 220µF/50V 直插电解（C49256813，8×12mm）+ C8/C9 = 2×22µF X5R 1206** | 混合方案；按 ESR 0.15~0.5Ω 两档边界仿真全部达标（§4） |
| **输入电容** | 5×22µF 陶瓷 | **C7 = 220µF/50V 电解（C49256813）+ C5/C6 = 2×22µF 陶瓷** | 实验室 5V 电源下充足 |
| 分压链 | R13(3k)+R1(33k)/R2(10k) | **R7(3k)+R6(33k)/R5(10k)**（仅位号变） | 戴维南 8.83kΩ×10nF=τ88.3µs、分压比 10/46，与固件精确一致 |

### 2.4 位号重排对照表（v2 → v3，答辩查数用）

> 全板位号按位置重新标注。**网络拓扑逐网 diff 100% 无损**，只是编号变了。

| v3 位号 | 功能 | v2 位号 | C 号/值 |
|---|---|---|---|
| C1 | 3V3 10µF | C4 | C13585 |
| C2/C3/C4 | 3V3 100nF 去耦 | C7/C8/C9 | C14663 |
| C5 | VIN_5V 22µF 陶瓷 | C5 | C12891 |
| C6 | VIN_5V 22µF 陶瓷 | C14~C17 之一 | C12891 |
| **C7** | **VIN_5V 220µF/50V 电解** | （v2 无） | C49256813 |
| C8/C9 | VOUT 22µF 陶瓷 | C6/C18（C19~C21 删） | C12891 |
| **C10** | **VOUT 220µF/50V 电解** | （v2 无，曾暂放 C22） | C49256813 |
| C11/C12 | 晶振负载 22pF | C12/C13 | C1653 |
| C13 | VSENSE 滤波 10nF | C10 | C57112 |
| C14 | ISENSE 滤波 1nF | C11 | C1588 |
| R1 | PWM 基极电阻 1k | R8 | C21190 |
| R2 | MID 走廊电阻 10Ω | R6 | C22859 |
| R3 | GATE 下拉 100k | R7 | C25803 |
| R4 | VSENSE 串联 1k | R11 | C21190 |
| R5 | 分压下臂 10k | R2 | C25804 |
| R6 | 分压上臂 33k | R1 | C4216 |
| **R7** | **分压上臂 3k（新增）** | （v2 无） | C4211 |
| R8 | VOUT 泄放 10k | R12 | C25804 |
| R9 | POWER 灯限流 1k | R5 | C21190 |
| R10 | NRST 上拉 10k | R9 | C25804 |
| R11/R12 | CV/CC 灯限流 1k | R3/R4 | C21190 |
| R13 | BOOT0 下拉 100k | R10 | C14675 |
| Rs1 | 采样电阻 100mΩ | Rs1 | C25334 |
| POWER/CV/CC | 电源/恒压/恒流指示灯（红 0402） | LED1/LED2/LED3 | C2286 |

网络改名：CV_LED→CV、CC_LED→CC、PWR_LED→POWER；另有 9 个网（GATE/MID/PWM_B/NRST/BOOT0/OSC_IN/OSC_OUT/分压中点/R13-R1 节点）为直连走线未挂命名旗，网名 `$1N*`（不影响电气与 PCB 同步，仅影响文档对账可读性）。

## 3. 固件常数变更（v2.1，已改入 `firmware/`）

电流采样链硬件从 0.05Ω 改 0.1Ω，counts 口径全部 ×2；电压链不变。

| 常数 | 文件 | v2 | v3 | 说明 |
|---|---|---|---|---|
| ADC_IOUT_GAIN | bsp_power.h | 0.00032234f | **0.00016117f** | ÷2 |
| ADC_IOUT_DIV | bsp_power.h | 3102.3f | **6204.5f** | ×2 |
| ISET_DEFAULT_COUNTS | bsp_power.h | 1551u | **3102u** | 0.5A |
| **OCP_HARD_COUNTS** | bsp_power.h | 2482u（0.8A） | **3723u（0.6A）** | ⚠️ 0.1Ω 下 INA 输出 5V/A，0.8A→4.0V 超 3.3V ADC 量程；0.6A=1.2 倍额定 |
| OCP_SOFT_COUNTS | bsp_power.h | 2172u | **3412u**（0.55A，存档未引用） | |
| UNLOAD_DROP_COUNTS | control.c | 400 | **800** | 卸载判定 0.129A/拍 |
| LOAD_FF | control.c | 0.26f | **0.13f** | counts 口径减半，物理前馈不变 |
| LOAD_FF_THRESHOLD | control.c | 100（+100） | **200（+200）** | ≈0.032A 不变 |

**不修固件的后果（仿真实测）**：正常 12V/0.5A 工作点，控制器把 0.1Ω 采样读成 2 倍电流→限幅器压占空比→**输出塌到 4.91V**。

## 4. 仿真复跑（定稿基线：`sim/ctrl/results/summary_rebuild_current_sch.json`）

模型口径 = 当前原理图实装值（L 100µH/DCR 0.17Ω，Q1 rds 30mΩ，D1 Vf 0.45V，Cout=220µF 电解(ESR 0.3Ω 代表值，0.15/0.5 边界)+2×22µF 陶瓷(偏压后≈22µF)，τ=88.3µs，INA 增益 5V/A）。

| 场景 | 结果 | 课程指标 | 判定 |
|---|---|---|---|
| S1 开环工作点 | 模型自检一致（≤3%） | — | ✅ |
| S2 软启动 | 过冲 **49mV**，浪涌 1.6A，无 OVP | 无过冲/不触 OVP | ✅ |
| S3 稳态 24Ω 满载 | **12.0032V（+0.075%）**，纹波 **218mV（1.81%）** | 12V±5%，纹波 ≤5% | ✅ |
| S4 负载阶跃 0.5A→0→0.5A | 卸载过冲 **296mV** 无故障；加载跌落 **1090mV / 6.4ms** | 稳态 ±5%（瞬态无指标） | ✅ |
| S5 恒流 CC | **−0.18%**，CV/CC 无振荡 | 0.5A±5% | ✅ |
| S6 输出短路 | OCP **5ms 锁存**（0.6A 整定） | 有过流保护 | ✅ |
| S7 OVP 注入 | 立即锁存保持 | 有过压保护 | ✅ |
| S10 输入 4.75V | 偏差 **20mV** | 12V±1% | ✅ |
| 电解 ESR 边界 | 0.15Ω / 0.5Ω 两档：纹波 203~214mV、阶跃 1078~1167mV | — | 风险封闭 ✅ |

效率预算不变 ~87%（L1 DCR 0.17Ω），**待上板实测**。

## 5. PCB 状态与发板记录

- 2026-11-05：原理图定稿（v3 口径）→ 团队完成 PCB 器件同步、功率主干走线（VIN_RAW/VIN_5V/SW/VOUT/VLOAD 主干 70/60mil ✓）、底层 GND 铺铜、4 角安装孔（2mm）。
- 2026-11-05 深夜：**已提交嘉立创加工**。
- **归档（2026-11-06）**：`sch_work/archive_v3/` —— 下单时点云端主工程快照（`pcb_dump_archived.json`）、DFM 检查（`check_as_ordered.txt`，77 项 WARN/0 ERROR）、DRC（`drc_as_ordered.json`，0 违规）、原理图定稿网表（`sch_read_final.json`）、器件属性（`sch_list_v3.json`）、`BOM_v3.csv`。
- ⚠️ **布线版工程归档待补（重要）**：经三轮现场对账（2026-11-05 23:10/23:31、2026-11-06 10:05 从云端强制重载、11:41 队友保存后复读），云端主工程 `boost-cccv-psu` 的 PCB1 文档模型**始终为 37 段走线（功率主干）/26 个信号网未连**——布线完成的 PCB（组内截图所示版本）**不在云端主工程里**，只存在于组员端编辑器会话或其个人工程副本中。已发加工的 Gerber 若出自该布线版本则功能完整；**待组员导出两样东西补入本仓库**：① 布线版嘉立创工程文件（文件→导出→工程）；② 下单用 Gerber zip。导出后存入 `sch_work/archive_v3/` 并删除本节警告。
- 遗留视觉项（不影响功能，下一版清理）：24 根零长度导线、27 个未挂 NC 的悬空脚（U1 未用 GPIO + SW1.2/4）、9 个 `$1N*` 未命名网。

## 6. 首板调试顺序（沿用 06 §5，注意 OCP 已改 0.6A）

1. **不焊 Q1**：上电量 3.3V（XC6206）→ 5V 分配 → ISENSE/VSENSE 静态点
2. 量栅极波形：0.7/2.6V 方波，沿 <100ns
3. 焊 Q1，开环 D=0.1 起步 → 闭环（kp_v=0.06 / ki_v=50 / load_ff=0.13）
4. 恒流点验证：CC 给定 0.5A 实测（固件读数应与万用表一致——0.1Ω 口径）
5. OCP 验证：加载至 0.6A 应 5ms 锁存（0.8A 不会触发——量程所限）
6. 效率实测：12V/0.5A 额定点，预算 ~87%，课程 ≥75%

## 7. 文件清单

```
原理图/PCB：嘉立创 EDA 工程 boost-cccv-psu（重建版，位号 C1-C14/R1-R13）
BOM：       sch_work/BOM_v3.csv（29 行/46 器件，全部带立创 C 号）
仿真基线：  sim/ctrl/results/summary_rebuild_current_sch.json（S1-S10 全过）
固件：      firmware/（v2.1 常数已并入 bsp_power.h / control.c）
证据：      sch_work/rebuild_review_20261105/（历次只读对账快照与报告）
```
