lcw578/STM32-project/01_系统设计方案.md

# 系统设计方案 —— MCU 控制的 Boost 恒流恒压电源

> 模块一：系统总体设计智能体　|　权重 30%　|　版本 v1.0（2026-11-02）
> 工程名：boost-cccv-psu　|　控制器：STM32F103C8T6　|　开关频率：100 kHz
>
> **v2 修订（2026-11-03，依据 04 审计 / 05 改版 / 06 固件）**：L1 定 **FSA1365-101MT（C41384377）**；F1 定**必装** 0466003.NR 3A 保险管（C99555）；Cin 对齐 220µF/25V；D1 定 B340A；§5.7 采样架构改 **ADC 连续扫描 + DMA + TIM2 更新中断**；§5.8 新增**反馈断线保护**、OCP 时序 5ms；§5.9 PB5 按键未实现（恢复走串口 clear）。

---

## 1. 智能体工作流定义（输入 → 处理 → 输出）

| 环节 | 内容 |
|---|---|
| **输入** | 课程技术指标表：5V 输入 / 12V 输出 / 恒流 0.5A / 6W / 100kHz / 纹波≤5% / 数字 PI / 保护 / 效率实测 |
| **处理流程** | ① 需求解析 → ② 拓扑选择论证 → ③ 工作模式定义 → ④ 关键参数计算 → ⑤ 器件选型 → ⑥ 系统框图与引脚分配 → ⑦ 控制与保护策略 → ⑧ 效率预算与风险分析 |
| **输出** | 本设计文档 → 作为原理图智能体（模块二）与程序智能体（模块四）的唯一设计输入 |

---

## 2. 需求解析

| 指标 | 要求 | 设计目标（留裕度） |
|---|---|---|
| 输入电压 | 5V 直流，±5% 波动（4.75~5.25V） | 按 4.75V 最恶劣工况校核电感与电流 |
| 输出电压 | 12V，稳态误差 ≤±5% | 闭环整定到 ±1%（±0.12V） |
| 恒流值 | 0.5A，稳态误差 ≤±5% | 采样链精度预算 ±2% |
| 额定功率 | 约 6W（12V×0.5A） | 连续运行，关键器件结温余量 >40℃ |
| 开关频率 | 50~100kHz | **100kHz**（教师建议值，纹波与体积最优） |
| 输出纹波 | ≤5%（≤0.6V） | 按 ≤3%（≤0.36V）设计 |
| 控制方式 | 数字 PI，CC/CV | 双环取小结构，无扰切换 |
| 保护 | 过压、过流、占空比限幅 | +软启动、故障锁存与恢复 |
| 效率 | 实测，额定点尽量 ≥75% | 预算 ≥82% |
| PCB | 两层板 | 功率/控制分区，星形接地 |

---

## 3. 拓扑选择与论证

**选定：Boost 升压变换器（低侧 NMOS + 肖特基整流）+ MCU 数字闭环。**

- 升压场景（5V→12V）唯一经典选择：单管、单电感、成本低、控制简单（一个占空比自由度），教学匹配度最高；
- 整流用肖特基 SS34 而非同步整流：省掉自举驱动与防倒灌复杂度，0.5A 输出下二极管损耗仅 0.23W，效率预算仍轻松超过 75% 指标——复杂度换来的 2~3% 效率对本课题不划算；
- 数字控制（MCU 采样 + PI + PWM）而非 UC3843 类模拟芯片：这是课程核心训练点（ADC/PWM/闭环），且保护逻辑可软件实现；
- 工作模式：电流连续模式（CCM）。额定点电感电流纹波设计为输入平均电流的 ~21%，轻载自然进入 DCM 由同一套 PI 覆盖（闭环对模式切换不敏感）。

## 4. 工作模式定义（CC/CV 状态机）

Boost 固有特性：未开 PWM 时输出电压 ≈ 输入电压（经电感和二极管直通，约 4.5V），无需输出预充电电路。

```
              Vout < 12V 且 Iout < 0.5A
   ┌──────────┐                          ┌──────────┐
   │ 待机/软启动 │ ──软启动斜坡 50ms──▶      │  CV 恒压  │ 12V 稳压，负载电流由负载决定
   └──────────┘                          └────┬─────┘
        ▲                                     │ Iout 达到 0.5A（恒流环电压低于恒压环）
        │ 故障恢复(按键/串口)                    ▼
   ┌────┴─────┐                          ┌──────────┐
   │ 故障锁存  │ ◀──OVP>13.2V / 短路>0.8A──│  CC 恒流  │ 0.5A 稳流，电压随负载回落
   └──────────┘                          └──────────┘
```

双环取小（标准电源架构）：电压环、电流环两个 PI 并联运算，各自输出占空比指令，**取最小者**作用于 PWM。任一时刻只有一个环起作用，切换天然无扰；未选中的环用输出值回写积分器（anti-windup 跟踪），防止积分饱和。

## 5. 关键参数计算书

### 5.1 占空比

理想 Boost 关系 Vout = Vin/(1−D)：

- 额定点：D = 1 − 5/12 = **0.583**
- 最恶劣（Vin=4.75V）：D = 1 − 4.75/12 = **0.604**
- 计及二极管压降与导通损耗，实际工作点约 D≈0.62~0.65，由闭环自动修正
- **占空比限幅 D_max = 0.85**（失控保护裕度），软启动期间从 0 斜坡上升

### 5.2 电感（CCM，纹波电流取 30%）

输入平均电流：Iin = Pout/(η·Vin) = 6/(0.85×5) = **1.41 A**

- 目标纹波 ΔIL = 0.3×1.41 = 0.42A：
  L = Vin·D/(fs·ΔIL) = 5×0.583/(100k×0.42) = **69 µH**
- **取标准值 100 µH**（更深 CCM，纹波降至 0.29A = 21%）：
  ΔIL = 5×0.583/(100k×100µ) = **0.29 A**
- 峰值电流：IL_pk = Iin + ΔIL/2 = 1.41 + 0.15 = **1.56 A**
- 有效值：IL_rms ≈ 1.42 A
- **规格要求：100 µH，饱和电流 ≥ 2.5 A（1.6 倍裕度），DCR ≤ 80 mΩ，屏蔽式功率电感**

### 5.3 电容

**输入电容**（电感在输入侧，电流连续，纹波需求小，主要防源阻抗振荡）：
100 µF/16V 低 ESR 电解 + 10 µF/25V X7R 陶瓷并联

**输出电容**（Boost 输出为脉动电流，纹波 = 电容分量 + ESR 分量）：
- 电容分量：ΔV_cap = Iout·D/(fs·Cout) = 0.5×0.583/(100k×220µ) ≈ **13 mV**
- ESR 分量：ΔV_ESR = IL_pk × ESR ≈ 1.56 × 0.08 ≈ **125 mV**
- 合计 ≈ 0.14V = 1.2% << 3% 目标 ✓
- **规格：220 µF/25V 低 ESR 电解（ESR ≤ 80 mΩ）+ 10 µF/25V X7R 陶瓷**

### 5.4 开关管（低侧 NMOS）

- 电压应力：Vds = Vout + 漏感尖峰 ≈ 12 + 4 ≈ 16V（PCB 布局控制回路面积 + 预留 RC 吸收焊位）→ **30V 规格裕度 1.9 倍**（v2 注：RC 焊位实际未布，EMC 实测后再定）
- 电流：导通期有效值 I_rms = IL_rms·√D = 1.42×0.764 = **1.08 A**，峰值 1.56A
- 导通损耗：P = 1.08² × 0.040 = **0.047 W**（3.3V 驱动时 Rds(on) 按 40 mΩ 计）
- 开关损耗（硬开关）：P ≈ 0.5·Vds·Iin·(tr+tf)·fs ≈ 0.5×12×1.41×200n×100k = **0.17 W**
- **选型：AO3400A（30V/5.7A，SOT-23）或 IRLML6344（30V，逻辑电平更优）**
- **栅极驱动：S8050+S8550 图腾柱**（满足课程"驱动电路"要求，开关沿 <50ns），栅极串 10Ω，栅源下拉 100k（防上电漂浮误导通）

### 5.5 整流二极管

- 平均电流 = Iout = 0.5A；反向应力 = Vout = 12V
- **选型：SS34（40V/3A 肖特基，SMA），Vf≈0.45V@0.5A → 导通损耗 0.23W**（全板最大单点损耗，加宽铜箔散热）

### 5.6 采样电路

**输出电压采样**（36k/10k 精密分压，1%）：
- 12V → 12×10/46 = **2.609 V**（4095 码中占 3239，分辨率 3.7mV/LSB）
- 满量程对应 15.2V，OVP 阈值 13.2V → 2.87V，不触顶 ✓
- 后级 RC 滤波（1kΩ + 100nF，fc=1.6kHz）进 ADC

**输出电流采样**（高端检测，不影响负载地）：
- Rs = **50 mΩ / 1% / 1206**（0.5A 时压降 25mV，损耗 12.5mW）
- **INA180A2**（增益 50V/V，共模 −0.2~26V）：0.5A → 25mV×50 = **1.25 V**（1548 码，分辨率 0.32mA/LSB）
- 精度预算：Rs ±1% + 增益 ±1% + 失调（150µV×50=7.5mV→0.3%）+ ADC → **合计 <±2%** ✓（指标 ±5%）
- 0.8A 短路阈值 → 2.0V，量程内 ✓

### 5.7 PWM 与 ADC 时序（STM32F103C8T6 @72MHz）

- TIM1：PSC=0，ARR=719 → **PWM = 72M/720 = 100 kHz，占空比分辨率 1/720 = 0.139%**（够细：闭环稳态抖动 ±1 LSB = ±12mV 输出）
- ADC1 **连续扫描双通道（Vout、Isense）+ DMA 循环**，控制律在 **TIM2 更新中断（10kHz）** 内执行（v2：原"注入组+JEOC"方案未采用，串口打印不阻塞控制拍）
- 控制律每周期执行（10kHz 更新率），PI 输出限幅 [0, 612]（=0.85×720）

### 5.8 保护阈值汇总

| 保护 | 阈值 | 动作 | 恢复 |
|---|---|---|---|
| OVP 过压 | Vout > 13.2V（+10%） | PWM 立即刹车（MOE=0），锁存 | 串口命令/重新上电 |
| 软过流 | Iout > 0.6A | CC 环自然限流（正常工作形态） | 自动 |
| 硬 OCP 短路 | Iout > 0.8A 持续 **5ms（50 拍）** | 关断锁存 | 串口命令/重新上电 |
| 占空比限幅 | D ≤ 0.85 | PI 输出钳位 | — |
| 软启动 | 50ms **斜坡电压基准**（v2，非占空比斜坡） | — | — |
| **反馈断线（v2 新增）** | duty > 0.69 且 Vout < 8V 持续 5ms | 关断锁存 FAULT_FB | 串口命令 |
| 输入欠压（扩展） | 采样 Vin < 4.4V 时告警降额 | 降额运行 | 自动 |

### 5.9 STM32 引脚分配

| 引脚 | 功能 | 说明 |
|---|---|---|
| PA8 | TIM1_CH1 → PWM | 栅极驱动输入（图腾柱） |
| PA5 | ADC1_IN5 | **电压采样 VSENSE**（36k/10k 分压 + R11 1k + C10 10nF，v2 核对） |
| PA6 | ADC1_IN6 | **电流采样 ISENSE**（INA180A2 输出 + C11 1nF，v2 核对） |
| PA9/PA10 | USART1 TX/RX | 调试串口（115200） |
| PA13/PA14 | SWDIO/SWCLK | 下载调试口 |
| PB0 | GPIO 输出 | CV 指示 LED |
| PB1 | GPIO 输出 | CC 指示 LED |
| PC13 | GPIO 输出 | 电源/故障 LED（闪烁编码） |
| PB5 | — | **未使用**（v2：故障恢复走串口 `clear` 命令，板上无按键） |
| BOOT0 | 跳线 | GND=正常启动 |

辅助电源：5V → ME6211C33（3.3V/500mA LDO）→ MCU + INA180。上电即工作，PWM 复位默认安全态（无输出），满足"控制先于功率"上电顺序。

---

## 6. 系统框图

```
                         ┌────────────────────────────────────────────┐
                         │                STM32F103C8T6               │
 5V INPUT ──┬──[保险丝]──┤  PA4◄── Vout分压36k/10k ──┐   PA8 ──PWM──┐ │
 +          │            │                           │             ▼ │
        [100µF+10µF]     │  PA5◄── INA180A2(G=50) ──┐│      [图腾柱驱动]
            │            │         ▲                ││             │ │
            ▼            │         │                ││        [10Ω+100k]
      ┌───┴────┐        │         │                ││             ▼ │
      │ 100µH  │        │  ADC1注入│  PI(电压环) ──┐││        ┌────┴───┐
      │  L1    │        │  TIM1触发│  PI(电流环) ──┤┤┤取小──▶│ NMOS   │
      └───┬────┘        │         │      ▲        │││       │ Q1     │
          ├─────────────┼─────────┘      └────────┤││       └────┬───┘
          ▼             │                         └┘│            ▼
      [SS34 D1]─────────┤                 USART1调试 │        [GND功率区]
          │             │                            │            │
      [220µF+10µF]      └────────────────────────────┘            │
          │                                                       │
  12V OUTPUT ──[50mΩ Rs]──▶ INA180A2 ──▶ PA5                    GND ▼
```

功率路径：**5V → Cin → L1 → 节点(SW) → D1 → Cout → 12V 输出**；Q1 将 SW 节点斩波到地。
PCB 分区：左＝功率区（Cin/L/Q1/D1/Cout/Rs/INA180 短粗回路），右＝控制区（LDO/MCU/接口），中间隔离，星形单点接地。

## 7. 器件选型表

> C 号（立创商城编码）在阶段二绘制原理图时从嘉立创EDA元件库直接选取（带封装与 3D），表内为规格约束。每个器件要求阶段二匹配 1 个首选 + 1 个替代。

| 序号 | 器件 | 关键规格 | 封装 | 数量 | 用途 |
|---|---|---|---|---|---|
| U1 | STM32F103C8T6 | 72MHz/64KB Flash/12bit-ADC | LQFP-48 | 1 | 主控 |
| U2 | ME6211C33 | LDO 3.3V/500mA，低噪声 | SOT-23-5 | 1 | 数字电源 |
| U3 | INA180A2 | 增益50，共模26V，带宽350kHz | SOT-23-5 | 1 | 电流检测放大 |
| Q1 | AO3400A（备选IRLML6344） | 30V，Vgs(th)≈1V，逻辑电平 | SOT-23 | 1 | 开关管 |
| D1 | B340A（C64982） | 40V/3A 肖特基 | SMA | 1 | 整流 |
| L1 | **FSA1365-101MT（C41384377）** 100µH | 3.5A/Isat 4A，DCR 170mΩ，屏蔽 SMD | 13.5×12.6 | 1 | 储能（v2） |

> **选型定稿说明（2026-11-02）**：屏蔽式 SMD 电感在立创库内无 Isat≥2.5A 现货，L1 定为 **IHA203BA（C1335911）直插工字电感：100µH ±10%，额定电流 2.7A**（峰值 1.56A，裕量 73%）。非屏蔽但频率仅 100kHz，PCB 布局时开关节点远离采样线即可；直插封装便于学生焊接。全部 24 种器件（42 个位号）的库身份已解析并存档于 `sch_work/devices_selected.json`。
>
> **v2 再定稿（2026-11-03）**：直插工字电感与 C5 在 PCB 上高度冲突（3D 干涉，见 07），L1 改 **FSA1365-101MT（C41384377）SMD 一体成型屏蔽**：100µH ±20%、3.5A/Isat 4A、DCR 170mΩ、13.5×12.6×6mm。代价：DCR 超出原 ≤80mΩ 规格，效率预算 89%→87%（仍 ≥75%）；收益：消除干涉、可贴装、屏蔽更好。效率为实测项，首板需验证。
| Rs | 50mΩ ±1% | 1% 合金采样 | 1206 | 1 | 电流采样 |
| Q2/Q3 | S8050/S8550 | 图腾柱对管 | SOT-23 | 1+1 | 栅极驱动 |
| Cin | **220µF/25V 低ESR（C5，底面）** + 10µF/25V X7R（C1） | ESR≤80mΩ | 电解+1206 | 各1 | 输入滤波（v2 对齐） |
| Cout | 220µF/25V 低ESR + 10µF/25V X7R | ESR≤80mΩ | 电解+0805 | 各1 | 输出滤波 |
| C组 | 0.1µF×6、22µF/10V×1、100nF×2 | 去耦/滤波 | 0603/0805 | — | 去耦 |
| R组 | 36k/10k/1k(1%)、10Ω、100k、1k LED | 精密分压用1% | 0603 | — | — |
| X1 | 8MHz 无源晶振 + 22pF×2 | ±20ppm | HC-49S/3225 | 1 | MCU 时钟 |
| J1/J2 | 5.08mm 2P 端子 | 6A | KB301 | 2 | 输入/输出 |
| J3 | SWD 4P 排针 2.54mm | — | — | 1 | 下载 |
| J4 | 串口 4P 排针 | TX/RX/3V3/GND | — | 1 | 调试 |
| F1 | **保险丝 3A/32V 1206**（原选 C99555 0466003.NR 仅国际站在售；**v2.1 改选国内现货同规格 C41342 = Littelfuse 0468003.NRHF**，快断，2.4 万库存） | 一次性，贴装 1206 | 1206 | 1 | 输入保护（**v2 必装**，串在 VIN_RAW/VIN_5V 之间；**调试会炸，多备 5~10 颗**） |
| LED | ×3 + 限流电阻 | 红/绿/黄 | 0603 | 3 | 电源/CV/CC 指示 |
| SW1 | 轻触按键 | 复位 | — | 1 | MCU 复位 |

## 8. 效率预算

| 损耗项 | 估算 |
|---|---|
| D1 导通 | 0.23 W |
| Q1 导通+开关 | 0.05 + 0.17 = 0.22 W |
| L1 铜损（DCR 80mΩ） | 1.42²×0.08 = 0.16 W |
| L1 磁芯损耗 | ~0.05 W |
| Rs + Cout ESR | ~0.03 W |
| LDO/控制/采样 | ~0.05 W |
| **合计** | **≈ 0.74 W → η = 6/(6+0.74) ≈ 89%** |

保守计入杂散与计算偏差，**预算 82~86%，远超 75% 指标**。实测时按输入/输出端子电压电流计算。

## 9. 风险与对策

| 风险 | 影响 | 对策 |
|---|---|---|
| 数字 PI 参数不当 → 输出振荡 | 联调受阻 | 保守初值（Kp 小 Ki 慢）+ 串口在线整定；最差降 50kHz 重整定 |
| 开关节点振铃 → EMI/误解调 | 纹波超标 | 布局最小回路 + 预留 RC 吸收焊位（R=10Ω/C=1nF 先不贴） |
| INA180 距离 Rs 远拾取噪声 | 电流读数抖 | Rs/INA180 紧贴布局，差分走线，软件滑动平均 |
| 3.3V 直驱栅压不足 → Rds 偏大 | 效率降 | 图腾柱把 5V 完整摆到栅极（Vgs≈5V，Rds≈28mΩ）|
| 电感采购饱和电流虚标 | 磁饱和失控 | 选 Isat≥2.5A 且留 60% 裕度；OCP 保护兜底 |

## 10. 输出物与下游接口

- **本文档** → 模块二（原理图）：第 5/6/7 节 = 绘图输入
- **第 5.7/5.9 节** → 模块四（程序）：CubeMX 配置依据
- **第 7 节** → 采购 BOM 基线
- **第 8/9 节** → 中期报告素材
