lcw578/STM32-project/02_仿真验证计划.md

# 仿真验证计划 —— LTspice（功率级）+ Python（数字控制环）

> 仿真验证智能体　|　版本 v1.0（2026-11-03）　|　依据《01_系统设计方案.md》《嵌入式系统实践课程设计要求.docx》制定
> 定位：**不改原理图、不改固件**，在实物打样前对"已定参数"做行为级验证；产物直接服务期中报告"结果验证"与答辩。

---

## 0. 结论速览

| 问题 | 结论 |
|---|---|
| 是否必须做 | 课程要求"仿真**或**实物测试"二选一，不强制；但当前有 4 项纸面参数从未验证（见 §1），且期中汇报（第 13 周）前实物未必到手 |
| 会不会动原理图 | **不会**。两个仿真都从设计参数另建模型；唯一与原理图的交互是只读导出网表做拓扑对账 |
| 工具 | Python 3（已装，补 numpy/matplotlib）+ LTspice（免费，需安装） |
| 工作量 | 约 1.5~2 个工作日（Python 1 天 + LTspice 0.5 天 + 报告整理 0.5 天） |
| 先做哪个 | **先 Python 控制环**（验证价值最高：PI 参数/CC-CV 切换/保护阈值全在里面），后 LTspice 功率级 |

---

## 1. 为什么要仿真：当前未验证清单（按风险排序）

| # | 未验证项 | 现状 | 风险 |
|---|---|---|---|
| 1 | **数字 PI 参数** kp_v=0.05 / ki_v=150 / kp_i=0.02 / ki_i=80 | 固件写死，保守拍定 | Boost 带右半平面零点，相位裕度天然紧张；振荡只能等板子到手才知道 |
| 2 | CC/CV 双环取小切换 + `pi_track` 反算跟踪 | 代码已实现，未运行过 | 切换瞬间振荡或积分器跳变 |
| 3 | 保护阈值换算（OVP 3562 counts、OCP 2482 counts） | 纸面换算 | 换算错→保护失效或误动作 |
| 4 | 功率级纹波/峰值电流（ΔIL=0.29A、纹波≈0.14V、IL_pk=1.56A） | 手算（方案 §5.2/5.3） | 无波形证据；软启动浪涌未估 |

### 1.1 顺带发现的"文档↔固件"不一致（仿真按固件为准，结果出来后统一修订文档）

| 项 | 设计文档 §5.7/5.8 | 固件实际（代码为准） | 仿真取值 |
|---|---|---|---|
| 控制环更新率 | 每开关周期采样（100kHz），TIM1 触发注入组 | **10kHz**（TIM2 节拍轮询，main.c:69-70） | 10kHz，Ts=100µs |
| 硬 OCP 判决时间 | 0.8A 持续 10ms | **5ms**（oc_cnt≥50，control.c:106） | 5ms |
| 软过流阈值 | 0.6A（CC 环自然限流） | 定义了 OCP_SOFT_COUNTS=0.7A 但**未被引用** | 0.6A（CC 环限流行为本身会覆盖） |
| ADC 采样方式 | TIM1 触发、与开关周期同步 | **连续扫描 + DMA 循环**，控制环取最新值，与开关相位完全异步 | 异步采样（含混叠压力场景 S9） |

---

## 2. 权威常数表（仿真输入，全部有出处）

### 2.1 控制侧（出处：firmware/Core/Inc/bsp_power.h、control.c）

| 常数 | 值 | 说明 |
|---|---|---|
| 开关频率 fs | 100 kHz | TIM1，ARR=719 |
| 占空比分辨率 | 1/720 | duty 输出取整到 CCR 计数（uint16 截断） |
| 占空比限幅 | 0.85（612 counts） | PWM_DUTY_MAX |
| 控制周期 Ts | 100 µs（10 kHz） | CTRL_TS |
| Vout 换算 | 0.0037042 V/count | 12bit ADC，36k/10k 分压 |
| Iout 换算 | 0.00032234 A/count | 50mΩ × INA180A2(×50) |
| v_set | 3238 counts（12.0V） | ISET/VSET 默认 |
| i_set | 1551 counts（0.5A） | |
| OVP | 3562 counts（13.2V），立即锁存 | |
| OCP 硬 | 2482 counts（0.8A）持续 50 拍（5ms）锁存 | |
| 软启动 | 占空比限幅 0→612 线性斜坡 500 拍（50ms） | SS_STEPS=500 |

### 2.2 功率侧（出处：01_系统设计方案.md §5、sch_work/devices_selected.json 实际选型）

| 器件 | 参数 | LTspice 建模方式 |
|---|---|---|
| Vin | 5V ±5%（4.75~5.25V） | 理想源 + 可选源阻抗 |
| L1 | **IHA203BA** 100µH ±10%，额定 2.7A，DCR 用数据手册值 | L + 串联 DCR（Isat 2.7A > 峰值 1.56A，线性模型够用；饱和做敏感性附加项） |
| Q1 | **AO3400A**（30V N-MOS） | AOS 官网 SPICE 模型（备选：LTspice 内置逻辑电平 NMOS 调参） |
| D1 | **B340A**（40V/3A 肖特基；⚠️ 实际选型已从 SS34 改为 B340A） | Diodes Inc 官网 SPICE 模型（备选：内置肖特基改参数） |
| Cin | 100µF/16V 电解（ESR 按 100mΩ）+ 10µF/25V X7R | C+ESR；陶瓷做直流偏压降容敏感性 |
| Cout | 220µF/25V 电解（ESR ≤80mΩ，按手册值）+ 10µF X7R | C+ESR |
| Rs | 50mΩ/1%（采样） | 电阻 |
| 负载 | 电子负载 CC/CR 等效 | 恒流源 / 电阻 / 阶跃源 |
| 栅驱 | 图腾柱（5V 摆幅，<50ns） | 理想 0→5V PWM 源 + 10Ω + 100k 下拉 |

### 2.3 与原理图的对账方式（只读）

阶段二网表导出实际失败过（`netlist_kicad.net` 存的是 AMBIGUOUS_WINDOW 报错）。开工前用
`easyeda sch netlist --type kicad --project boost-cccv-psu`（带 --project 消歧）**只读重导**，
作为 LTspice 建模的拓扑参照（功率链 VIN→Cin→L→SW→D→Cout→VLOAD、栅驱、采样三块）。
不打开编辑器改任何图元。

---

## 3. 仿真 A：Python 数字闭环（主力，先做）

### 3.1 技术路线

```
┌──────────────────────────────────────────────────────────┐
│  plant.py   Boost 被控对象，两档模型                        │
│   ├─ 平均模型（CCM/DCM 判别）：步长 100µs，跑长时场景/参数扫描 │
│   └─ 开关模型（100kHz 硬开关，步长 100ns）：跑短时场景/纹波    │
├──────────────────────────────────────────────────────────┤
│  ctrl.py    control.c 的逐行移植（唯一权威 = C 代码）        │
│   pi_step（条件积分抗饱和）/ pi_track（反算跟踪）/            │
│   状态机 / 软启动 / OVP 立即锁存 / OCP 5ms 滤波 /             │
│   PWM 占空比量化（×720 取整）/ ADC 量化（12bit + 3.3V 满量程）│
├──────────────────────────────────────────────────────────┤
│  run_*.py   场景脚本（S1~S10）→ 结果 CSV + 图 PNG            │
└──────────────────────────────────────────────────────────┘
```

移植纪律：ctrl.py 不"重新设计"控制器，逻辑分支、取整方向（uint16 截断）、锁存行为与 control.c 一一对应；
差异仅在于用 float 模拟 counts 运算（C 里 uint16 运算行为在移植说明里逐条注明）。

### 3.2 场景清单（S1~S10）与判据

判据全部对照课程指标与方案设计目标，**每条都会产出一图一表**。

| 编号 | 场景 | 内容 | 通过判据 |
|---|---|---|---|
| S1 | 开环工作点核对 | 固定 D=0.583/0.62，稳态 Vout vs 理论 5/(1−D) | 与理论偏差 <5%（模型自检） |
| S2 | 软启动 | 12V 目标，空载→满载 0.5A | 无 OVP 误触发；Vout 过冲 <0.5V；浪涌电流 < Isat 2.7A |
| S3 | CV 稳态+纹波 | 满载 0.5A 长时运行 | 12V±1%；纹波 ≤0.36V（3%） |
| S4 | CV 负载阶跃 | 0→0.5A→0（100ms 间隔） | 超调/跌落 <5%，恢复 <50ms，不振荡 |
| S5 | CC/CV 切换 | 负载电阻 30Ω→20Ω→30Ω 扫过临界 24Ω | 电流钳在 0.5A±5%；切换无振荡、状态机无抖动 |
| S6 | 短路保护 | 输出直接短路 | 5ms 内锁存，锁存后电流归零 |
| S7 | OVP 注入 | 人为抬高反馈（等效 13.2V） | 立即锁存，PWM 归零 |
| S8 | **PI 参数敏感性** | kp_v∈[0.02,0.2]、ki_v∈[50,500] 网格 + 输入/负载阶跃 | 给出稳定域等高图与推荐终值（当前值落在域内则确认，否则给修正） |
| S9 | 采样混叠压力测试 | 开关模型 + 异步相位采样（Isense 无滤波，开关纹波直入 10kHz 采样） | 读数抖动对 PI 输出的扰动可接受；必要时论证软件滑动平均（方案 §9 对策） |
| S10 | 输入波动 | Vin 5V↔4.75V 缓变 | 闭环维持 12V±1% |

### 3.3 输出

- `sim/ctrl/`：plant.py、ctrl.py、run_S1~S10.py、结果 CSV、PNG 波形图
- `03_仿真验证报告.md`：每场景"设置→波形→判据对照→结论"
- 报告直接可引用的图：软启动波形、负载阶跃响应、CC/CV 切换、参数稳定域热力图

---

## 4. 仿真 B：LTspice 功率级开关仿真（开环，后做）

### 4.1 前置

- 安装 LTspice（ADI 官网免费，Windows 原生；本机当前未装）
- 器件模型来源按 §2.2；找不到官方模型时用内置通用模型 + 手册参数替换，并在报告注明
- 运行方式双轨：**批处理**（`LTspice.exe -b -ascii xxx.asc`，Python 解析 .raw 出图，可全自动化）
  + **交互式**（.asc 文件给用户随时打开看波形）

### 4.2 运行清单（T1~T5，全部开环——闭环只属于仿真 A）

| 编号 | 运行 | 内容 | 对照 |
|---|---|---|---|
| T1 | 稳态纹波 | D=0.583 与 0.62 各跑 5ms | 手算：ΔIL=0.29A、输出纹波≈0.14V（§5.3） |
| T2 | 占空比扫描 | `.step` D=0.40~0.70 → Vout(D) 曲线 | 理想 Boost 曲线 5/(1−D) + 损耗压降 |
| T3 | 软启动浪涌 | PWL 栅极斜坡 50ms | 浪涌电流 < Isat 2.7A（与 S2 交叉印证） |
| T4 | 器件应力 | Vds 峰值、D1 反向电压 | 30V/40V 规格裕度验证（§5.4/5.5） |
| T5 | （可选）RC 吸收 | SW 节点振铃观察 | 方案 §9 预留焊位的取舍依据 |

### 4.3 与仿真 A 的交叉验证（模型可信度闭环）

取同一固定占空比（D=0.62），对比 LTspice 开关波形与 Python 开关模型的
ΔIL、IL_pk、Vout 纹波：偏差 <10% → 证明 Python 被控对象模型可信，
其闭环结论（S1~S10）才有资格外推到实物。**这一步是整个仿真体系的证据链枢纽，写进报告。**

---

## 5. 执行顺序与工作量

| 步骤 | 内容 | 产出 | 估时 |
|---|---|---|---|
| 0 | 环境：pip 装 numpy/matplotlib；安装 LTspice；只读重导网表 | 可用环境 + 网表 | 0.5h |
| 1 | plant.py 平均模型 + S1 工作点自检 | 模型可信 | 2h |
| 2 | ctrl.py 移植 + S2/S3 | 闭环跑通 | 3h |
| 3 | S4~S7、S10 场景批跑 | 6 组波形+判据表 | 2h |
| 4 | S8 参数扫描 + S9 混叠测试 | 稳定域图 + 终值建议 | 2h |
| 5 | LTspice 电路搭建（.asc + 模型） | T1/T2 跑通 | 2h |
| 6 | T3~T5 + 交叉验证 §4.3 | 一致性数据 | 1.5h |
| 7 | 《03_仿真验证报告.md》+ 文档修订建议 | 报告 | 1.5h |

> 步骤 1~4（Python 侧）不依赖 LTspice 安装，可先行；LTspice 安装可并行进行。

## 6. 风险与对策

| 风险 | 对策 |
|---|---|
| AO3400A/B340A 官方 SPICE 模型下载不便 | 备选内置模型 + 数据手册参数（Vth/Rds/Vf/Cj）替代，报告注明建模近似度 |
| 仿真与实物存在差距（杂散、布局寄生、ADC 噪声） | 仿真定位是"参数方向性验证 + 逻辑验证"，不承诺复现实物波形；报告明确声明 |
| 平均模型在 DCM/模式切换边界失真 | 开关模型兜底核对边界工况（S5、S9 已覆盖） |
| pip 拉包慢/超时 | 走清华镜像 `-i https://pypi.tuna.tsinghua.edu.cn/simple` |

## 7. 明确不做的事

- ❌ 不修改嘉立创EDA原理图（网表只读导出，不改任何图元）
- ❌ 不修改固件代码（仿真若证明参数必须改，输出的是"建议清单"，改不改由后续决策）
- ❌ 不做 MCU 代码级联合仿真（Proteus 类）、EMI/热仿真、PCB 寄生提取——超出本课题必要验证范围
