lcw578/STM32-project/05_第二版改版说明.md

# 05_第二版改版说明（v2）

> 日期：2026-11-03　|　依据：《04_设计审计与整改清单》　|　路线：路线 2（功率带重排）
> 结果：**原理图 6 项改动、PCB 9 项改动，DRC 0 违规，Gerber/BOM/坐标已导出。**

---

## 1. 原理图改了什么

| 位号 | 改动 | 料号 | 说明 |
|---|---|---|---|
| **Q3** | 旋转 180° + 重连 | S8550（不变） | 原 `E=GND、C=MID` 是反的；现在 `E=MID、C=GND`，恢复标准射极跟随器 |
| **L1** | 换型 | **C41384377** FSA1365-101MT | 100µH / 3.5A 额定 / 4A 饱和 / DCR 170mΩ / 13.5×12.6mm 一体成型屏蔽，替代 27.4mm 直插 |
| **F1** | 新增 | **C99555** 0466003.NR | 3A / 32V / 分断 50A，串在 `VIN_RAW` 与 `VIN_5V` 之间 |
| **R12** | 新增 | **C2904526** 10k 0603 | 输出泄放，τ≈2.3s，14mW |
| **C10** | 100nF → **10nF** | C718540 | 采样滤波 fc 从 180Hz 提到 1.8kHz，与仿真假设对齐 |
| **C11** | 100nF → **1nF** | C141067 | 消除 INA180 的容性负载振荡风险 |

新增网络 **`VIN_RAW`**（J1.1 + F1.1）；`VIN_5V` 现在只挂 8 个负载脚（F1.2、C1.1、C3.1、C5.1、L1.1、Q2.3、U2.1、U2.3）。

**网表复核**（`sch read`）：
- `Q3: E→MID, C→GND, B→PWM_B`
- `MID` 三脚：Q2.2 / Q3.2 / R6.1
- `VOUT` 七脚（含 R12.1）
- 非 NC 悬空脚 **0**

---

## 2. PCB 改了什么

| 项 | 改动 |
|---|---|
| **L1** | 封装更新为 13.5×12.6 SMD，原位放置；不再与 C5/C1 有高度冲突 |
| **C5** | 翻到**底面**（layer 2），孔位不变；顶面彻底腾空 |
| **J1** | 移到 (250,1480)，让出左上 M3 孔；输入端子仍在左边缘 |
| **F1** | 放在 J1 与 C5 之间 (580,1500) |
| **C1** | 移到 (770,1250)，离开 J1 插拔走廊与电感投影 |
| **R7** | 移到 (1250,1200)，离开电感正下方，靠近 Q1 栅极 |
| **R1 / C11** | 移出 J2 的 250mil 插拔走廊（R1→2100,700；C11→1900,600） |
| **U3** | 移到分流电阻旁 (1900,1480)，IN+/IN− 从 20mm 缩到约 6mm |
| **D1** | 旋转 180° 并左移到 (1680,1600)，阳极贴近 L1 的 SW 焊盘 |
| **安装孔** | 四角 M3 全部到位（tl/bl 新打，tr/br 原有） |
| **丝印** | 10 条：5V IN、12V OUT、PWR、CV、CC、SWD、UART、BOOST-CCCV V2、C6“+”、C5 底面“+” |
| **功率走线** | 建 `POWER` 网络类并绑定 40/30/20mil 规则，重布 VIN/SW/VOUT/VLOAD |

**最终 Gerber 线宽实测**（顶层）：

| 线宽 | 段数 | 用途 |
|---|---|---|
| 1.016mm (40mil) | 12 | VIN 主干 |
| 0.762mm (30mil) | 1 | SW |
| 0.585mm (23mil) | 10 | SW/VOUT 支线 |
| 0.508mm (20mil) | 3 | 功率支线 |
| 0.440mm (17.3mil) | 14 | 功率短支线 |
| 0.254 / 0.248 / 0.203mm | 230 / 122 / 1061 | 信号 |

对比改版前“全板只有 0.203/0.254/0.248 三种宽度”，主干电流密度降到原来的 1/5。

---

## 3. 验证结果（最终复核：2026-11-03 14:50）

| 项 | 结果 |
|---|---|
| 原理图 DRC（SDK） | **0 fatal / 0 error / 15 warn**；15 warn 全是 `ONENETNAME`（同一网络挂多个同名旗，风格项） |
| 原理图 `sch check` | **0 电气问题**（0 悬空/0 网名不符/0 多网线）；剩 14 旗重叠、5 反向旗、1 合法交叉、1 分区框缺失（视觉项） |
| PCB DRC | **passed = true，0 violation**（保存+重载后复跑） |
| 网表对账 | **28/28 网络与原理图完全一致，0 mismatch** |
| 飞线 | **0 未连接；28 个网络全部有铜，0 零长度网络** |
| 越界 / 重叠 | 0 器件越界；5 处 courtyard 接触（LED/R、R3/U2、SW1/U2、U1/Y1），本体不碰，最紧 U1/Y1 约 0.6mm |
| 安装孔 | **4/4 M3**（tl/bl 新打，tr/br 原有） |
| 3D | **44/44 模型**；顶面 0 干涉；底面 C5 凸出 12.64mm |
| DFM（`pcb check`） | **0 error**；剩 2 根 GND 残桩、3 处 45° 锐角、无 Mark 点、J3/J4 插头包络 12.70<12.91 |
| Gerber | `嘉立创打样文件_v2_final.zip`（14 个文件，96KB） |
| BOM | `sch_work/BOM_v2.csv`，28 行，全部带立创 C 号 |
| 坐标 | `sch_work/placement_v2_final.csv`（18KB） |
| 结构件 | `sch_work/BOM_结构件.csv`（M3 15mm 铜柱 ×4 等） |
| 仿真矩阵 | **S1–S8、S10 全部用新电感参数（DCR=0.17Ω）+ 实装采样 τ=88.3µs 复跑通过**；存档 `results/summary_v2_tau88.json`（S1–S7/S10）+ `summary_s8_tau88.json`（S8） |

### 3.1 本轮修掉的告警（对应 UI DRC 面板）

| 现象 | 原因 | 处理 |
|---|---|---|
| **错误 ×2** | 两个网络旗落在图框外（x=10，可用区从 12 开始）：J1 的 `VIN_RAW`、C5 的 `VIN_5V` | `disconnect` 后用 offset=20 重连到 x=30；**out-of-sheet → 0** |
| **警告 ×2** | 同一条 GND 线树上重复 + 冗余的 netflag（修补残留） | 删除重复旗 `b6e9e5fd6712caa9`；**duplicate/redundant → 0** |
| 图签空白 | Name / Drawed / Description / Part Number 未填 | 填入四项；附加属性文字默认落在纸外，已隐藏（图签格子仍显示值）；**missing-titleblock 清除** |
| 15× `ONENETNAME` | 每个引脚都挂了同名电源旗（VIN_5V 有 6 个等） | **未改**：属画图风格；清掉需把旗改成拉线，重画风险大于收益，且不影响网表 |
| 14 处旗重叠、3 个反向旗 | 历史堆叠；A 轮 destagger 不收敛（14→24→25）已停止 | **维持现状**：纯视觉；彻底清需在 GUI 里手拖旗，或 v3 重画 |

**A 轮结果（2026-11-03）**：out-of-sheet **2→0**、duplicate/redundant **2→0**、reversed **5→3**；
C3.1 上堆叠的 4 个旗已清（保留 1 个）。自动 destagger 在这张密页上不收敛，已停止。
复核：**28/28 网络与 PCB 一致，0 非 NC 悬空**——美化没有动到任何网络。
| 1 处 wire-crossing | 合法正交交叉（两端无引脚/接点） | 保留，判为 INFO |

> 改动后重新对账：原理图与 PCB 仍 **28/28 一致**，删除/重连没有动到任何网络。

**PI 参数复算**（新电感 DCR=0.17Ω、真实采样 τ=88.3µs 重跑 S8）：

| kp_v \ ki_v | 30 | 40 | 50 | 65 | 80 |
|---|---|---|---|---|---|
| 0.04 | ✓ | ✓ | ✓ | ✓ | ✗ |
| 0.05 | ✓ | ✓ | ✓ | ✓ | ✗ |
| 0.06 | ✓ | ✓ | ✓ | ✓ | ✗ |
| 0.08 | ✓ | ✓ | ✓ | ✓ | ✗ |

τ 修正（88.3µs 实装值）后：ki≤65 全通过，ki=80 失稳——固件用 ki=50，不受影响。**推荐值 kp_v=0.06 / ki_v=50 四面有裕度（膝点误差 27mV）。** 存档：`sim/ctrl/results/summary_s8_tau88.json`。

> 重载跌落已在固件 v2 修复：快斩清零积分器 → 加负载跃升前馈，5907mV → **1187mV**（τ=88.3µs 实装值复跑，详见 06）。

---

## 4. 还剩什么（不阻塞打样）

| 项 | 状态 | 处理 |
|---|---|---|
| 2 根 GND 悬空短桩 @(2107,539)/(2278,600) | DFM WARN | U3/C11 移动后的残桩，接在 GND 上，无电气影响；下一版清 |
| 3 处 45° 锐角 | DFM WARN | 酸角，嘉立创可做；下一版改 45° 圆弧 |
| 无 Mark 点 | INFO | 嘉立创拼板自带，单板贴片影响小 |
| J3/J4 插头包络 12.7 < 12.91mm | WARN | 两个杜邦头不能同时插；调试时分开用 |
| 6 个去耦电容偏远（C4/C7/C8/C9） | WARN | C2/C6 是误报；C4 距 LDO 10mm、C9 距 U3 6mm，下一版拉近 |
| 3D 模型 | **已完成** | 44/44 已绑定（补绑 J3/J4）；导出 OBJ 做干涉检查：顶面无冲突，C5 底面凸出 12.6mm，需 ≥15mm 铜柱 |
| 固件 | **已完成 v2** | 见《06_固件v2说明.md》：R2~R5 + F6（TIM2 中断）+ F7（负载前馈）+ F8（断线保护）；S2/S3/S4/S5/S8 复跑通过 |
| 效率 | 预算下调 | L1 DCR 0.17Ω 比原假设 0.08Ω 多 0.18W，效率从 ~89% 降到 **~87%**，仍高于 75% 指标 |

---

## 5. 下一步

1. ~~**固件补丁**（约 2 小时）~~ **已完成**：见《06_固件v2说明.md》，S2/S3/S4/S5/S8 复跑通过。
2. ~~补 3D 模型~~ **已完成**：见《07_3D干涉检查.md》；下单时注意 C5 底面凸出，选 ≥15mm 铜柱。
3. **下单**：Gerber 用 `嘉立创打样文件_v2_final.zip`，BOM 用 `BOM_v2.csv`，坐标用 `placement_v2_final.csv`；2 层 70×50，5 片。
   结构件另购（不进 SMT BOM）：`sch_work/BOM_结构件.csv`——M3 母-母 15mm 铜柱 ×4、M3×6 螺丝 ×8、平垫圈 ×8、橡胶脚垫 ×4。
4. **首板调试顺序**：先不焊 Q1，量 3.3V/5V → 量栅极波形（应为 0.7/2.6V 方波，沿 <100ns）→ 焊 Q1，开环 D=0.1 起 → 闭环。
5. 报告补一节“仿真盲区与板级审查”，把 04 的 A1~A5 和这次的改版写成设计迭代证据。

---

## 6. 文件清单

```
原理图/PCB：嘉立创EDA 工程 boost-cccv-psu（已保存）
Gerber：    嘉立创打样文件_v2_final.zip
BOM：       sch_work/BOM_v2.csv（仅电子件，供 SMT）
结构件 BOM：sch_work/BOM_结构件.csv（铜柱/螺丝/脚垫，单独采购）
坐标：      sch_work/placement_v2_final.csv
布局图：    sch_work/review_placement_v2.png
DRC 证据：  sch_work/drc_final.json（passed:true, 0 violation）、sch_work/pcb_check_final.txt
网表快照：  sch_work/sch_read_v2.json
S8 复算：   sim/ctrl/results/summary_s8_v2.json
```
