lcw578/STM32-project/07_3D干涉检查.md

# 07_3D 干涉检查

> 日期：2026-11-03　|　对象：PCB v2（b31183190bec91b8）　|　方法：`pcb 3d models` + `pcb export-3d` + OBJ 顶点分析
> 结论：**顶面没有高度干涉；底面 C5 向下凸出 12.64mm，是唯一的结构约束。**

---

## 1. 3D 模型是干什么的（一句话）

PCB 的 DRC 是二维的：只查同一层铜皮的间距、焊盘、过孔，**看不见高度**。3D 模型是每个封装的三维包络，
把它们拼起来才能回答“这个电感会不会压到那个电解电容”“端子前面有没有空间插线”“螺丝会不会顶到元件”
——上一版 L1 压 C5 就是二维全过、三维必撞的典型。

它**不影响 Gerber、不影响铜皮、不影响电气**，也不改变 DRC；嘉立创做板不看 3D 模型。
它的价值只有两个：**装配前发现高度/包络冲突**，以及**报告/答辩的直观截图**。

---

## 2. 当前状态：44/44 全部有模型

| 项 | 结果 |
|---|---|
| 已绑定 | **44 / 44** |
| 立创库自带 | 42 个（0603/1206/SOT-23/LQFP/SMA/电感/端子等） |
| 本次补绑 | **J3、J4**（1×4 2.54 排针，原为 unbound），用 `HDR-TH_4P-P2.54-V-M_2` |
| 模型来源 | 立创/EasyEDA 库，封装派生近似体，不是厂商官方 STEP |

> 更正：04 清单里写的“3D 模型为 0”是误判——`pcb dump` 的 `model3d` 字段不反映绑定状态。
> 实际是 42/44 早就有模型，问题是**从没做过 3D 检查**。这条已在 04/05 中改正。

---

## 3. 检查方法与产物

1. `pcb 3d models` → `sch_work/models_3d.json`：逐器件绑定状态、模型名、变换。
2. `pcb export-3d --format obj` → `sch_work/board3d_v2/board.obj.zip`（1.6MB，44 个模型）。
3. 解析 OBJ 顶点（30,808 个），按 0.5mm 网格统计每个位置的最高/最低 Z：
   - `sch_work/board3d_v2/height_map.png`：顶面高度热力图 + 底面凸出热力图
   - `sch_work/board3d_v2/side_views.png`：XZ / YZ 侧视轮廓

---

## 4. 结果

### 4.1 顶面高度（板面 z=1.6mm 以上）

| 器件 | 高度（mm） | 说明 |
|---|---|---|
| J3 / J4 | **15.9** | 通用 2.54 排针模型，偏保守；实际 HMT-2.54-1×4PM 本体约 8.5mm |
| C6 | 11.0 | 220µF/25V 立式电解 |
| J1 / J2 | 9.9 | KF301 端子（含螺丝） |
| SW1 | 6.5 | 6×6 轻触按键 |
| L1 | **6.26** | FSA1365-101MT，13.5×12.6×6mm，与手册一致 |
| Y1 | 4.3 | HC-49S |
| U1 | 1.45 | LQFP-48 |
| 阻容/LED | 0.6~1.3 | 0603/1206 |

### 4.2 底面凸出（板底 z=0 以下）

| 器件 | 深度（mm） | 说明 |
|---|---|---|
| **C5** | **−12.64** | 220µF 电解翻到底面，本体+引脚向板下凸出 |
| J3 / J4 | −1.6 ~ −6 | 排针引脚穿过板后的尾巴 |
| J1 / J2 | −3.5 | 端子引脚尾巴 |
| 其余 | ≈0 | 全 SMD |

### 4.3 干涉判定

- **顶面**：所有高度 >4mm 的器件（L1、C6、J1、J2、J3/J4、SW1、Y1）两两 XY 包络均不重叠；
  L1 与 C1 在 x 方向有 0.2mm 交叠、但 y 方向不重叠（30.6~32.9 vs 34.2~47.1），不构成干涉；
  L1 与 C5 已完全分开（C5 在底面且 x 不重叠）。**顶面无高度冲突。**
- **底面**：只有 C5 一处深凸（x 13~20mm、y 41~48mm），其余是引脚尾巴。
- **板边/安装孔**：四角 M3 孔周围 118mil 禁布圈内无元件（2D 已验），3D 未见螺丝头干涉。

---

## 5. 对装配的影响

1. **铜柱高度 ≥15mm**：C5 向板下凸 12.64mm，若用常见的 10mm 铜柱，电容会顶到桌面。
   没有 15mm 铜柱时，可只在四角垫高（橡胶脚/尼龙柱），或把 C5 改成卧装。
   采购清单见 `sch_work/BOM_结构件.csv`：M3 母-母 15mm 铜柱 ×4、M3×6 盘头螺丝 ×8、M3 平垫圈 ×8、橡胶脚垫 ×4（备选）。
2. **C5 正下方不要放金属/导线**：底面这一块（x 13~20、y 41~48）是电容本体投影，避免短路。
3. **J3/J4 的 15.9mm 是模型保守值**：实际排针约 8.5mm；如果做外壳，按实际排针高度留 10mm 即可，
   不必按 15.9mm 留。
4. **顶面最高实际是 C6（11mm）**，其次 J1/J2（9.9mm）、L1（6.3mm）；外壳内腔高度建议 ≥13mm。

---

## 6. 局限

- 3D 模型是**封装派生的近似体**（长方体/圆柱），不是厂商 STEP；L1 的圆角、端子的螺丝细节都不精确，
  但包络尺寸与手册一致，用于干涉检查足够。
- 导出报告的 `modelCoverage` 是 `binding-only`——只证明“每个器件绑了模型”，不证明模型形状精确。
- 本次只做静态干涉；**没有做热仿真、没有做振动/跌落**。

---

## 7. 复现命令

```bash
easyeda pcb 3d models --window <id> --doc <pcb>
easyeda pcb export-3d --format obj --window <id> --doc <pcb> --out sch_work/board3d_v2
# 然后把 board.obj.zip 里的 .obj 顶点按 0.5mm 网格统计 Z 极值（脚本见 sch_work/board3d_v2）
```
