lcw578/STM32-project/大作业分析与路线图.md

# 嵌入式系统实践课程设计 —— 任务分析与执行路线图

> 依据《嵌入式系统实践课程设计要求.docx》整理，2026-11-02

---

## 一、这个作业到底要做什么（一句话版）

**设计并制作一个"用 STM32 单片机控制的升压恒流恒压电源"**：

- 把 **5V 直流输入**（类似 USB 电源）升高到 **12V 输出**
- 输出能力：**恒压模式 12V / 恒流模式 0.5A**，额定功率约 **6W**
- 自己用 **嘉立创EDA** 画原理图和 PCB（两层板）
- 自己写 **STM32 程序** 实现闭环控制和保护
- 最后联调测试（用实验室的电子负载验证）

它本质上就是实验室里常见的"可调直流电源"的迷你版，或者像手机充电器那样有恒压/恒流（CC/CV）两种工作模式的电源，只是由你自己从电路到程序完整做出来。

## 二、硬性技术指标（验收时老师会看这些）

| 项目 | 基本要求 | 建议目标 | 通俗解释 |
|---|---|---|---|
| 输入电压 | 5V 直流 | 允许 ±5% 波动 | USB/适配器供电 |
| 输出电压 | 12V | 稳态误差 ≤±5%（即 11.4~12.6V） | 恒压（CV）模式 |
| 恒流目标 | 0.5A | 稳态误差 ≤±5% | 恒流（CC）模式 |
| 额定功率 | 约 6W | 稳定连续运行 | 12V × 0.5A = 6W |
| 开关频率 | 50~100kHz | **统一用 100kHz** | MOS 管每秒开关 10 万次 |
| 输出纹波 | ≤5% | ≤3% | 输出电压的抖动幅度 |
| 控制器 | 32 位 MCU | **推荐 STM32** | 芯片选型 |
| 控制方式 | 数字 PI | CC/CV 自动切换 | 软件闭环控制 |
| 保护功能 | 过压、过流、占空比限幅 | 建议加软启动 | 防止烧板烧负载 |
| 效率 | 完成实测 | 额定点 ≥75% | 输出功率/输入功率 |
| 调试负载 | 电子负载 | 支持 CC/CR 模式 | 实验室仪器 |
| PCB | 两层板即可 | 功率级与控制级分开布局 | 嘉立创打样 |

## 三、四大任务模块与评分权重

| 模块 | 权重 | 要交的东西 | 主要负责人 |
|---|---|---|---|
| ① 系统总体设计 | **30%** | 设计报告：系统框图、拓扑选择、关键参数计算（电感/电容/MOS/采样电阻等）、器件选型依据 | 组员 A |
| ② 原理图设计 | **25%** | 嘉立创EDA 原理图源文件：Boost 功率级、驱动与采样电路、MCU 最小系统、调试接口（SWD/串口）、保护电路 | 组员 B |
| ③ PCB 设计 | **30%** | PCB 源文件 + 设计规则检查（DRC）结果：功率回路短粗、采样走线远离干扰、地回流清晰、预留电源/负载/下载/测试接口 | 组员 C |
| ④ 程序与联调 | **15%** | STM32 工程源码：ADC 采样、PWM 输出、数字 PI、CC/CV 切换、保护与软启动；调试/测试记录 | 组员 D |

**注意**：权重最大的不是程序（只占 15%），而是系统设计和 PCB（各 30%）。零基础团队最容易犯的错是把 90% 时间花在写程序上，结果硬件画错了返工。

**关于"智能体"的措辞**：文档把四个模块都称为"XX智能体"，并要求"各智能体应建立明确的输入、处理流程和输出结果"。最稳妥的应对是：每个环节都整理成"输入 → 处理流程 → 输出"的文档结构（例如：输入=技术指标表，处理=参数计算过程，输出=选型表）。无论老师是"换个说法指分工"还是"真的要求体现 AI 辅助流程"，这样写都能覆盖。**建议第一次课问清老师是否有额外要求（比如要求用 AI 工具辅助并记录过程）。**

## 四、时间节点

- **第 8 周（现在）开始**
- **第 13 周：期中汇报** —— 至少完成一半任务 + 提交中期报告
- **第 18 周：期末答辩/验收**
- 开放时间：周二晚（周二周三第 7、8 节也开放），地点 D1c218

## 五、零基础名词扫盲

| 术语 | 含义 |
|---|---|
| Boost（升压）变换器 | 用电感+开关管+二极管把低电压"泵"到高电压的经典电路 |
| MOS 管 | 功率开关，由 MCU 的 PWM 信号控制它高速通断 |
| PWM | 脉冲宽度调制：改变"开"的时间占比（占空比）来调节输出电压 |
| 占空比 | PWM 一个周期内高电平的比例，Boost 中越高输出电压越高（上限一般 <85%） |
| ADC | 模数转换：MCU 读取输出电压/电流的实际值 |
| 闭环控制 / 数字 PI | 读实际值 → 和目标值比较 → 按误差调 PWM → 输出稳定在目标值 |
| CC/CV | 恒流/恒压双模式：负载轻时恒压 12V；电流到 0.5A 时自动转恒流 |
| 纹波 | 输出直流上的交流抖动，用电容滤除 |
| 最小系统 | 让 STM32 能跑起来的最少电路：供电、晶振、复位、下载口 |
| SWD | STM32 的两线下载调试接口 |
| DRC | 设计规则检查，PCB 画完必须通过 |
| 电子负载 | 可编程"假负载"，用来测试电源性能（实验室有） |
| 嘉立创EDA | 国产免费 EDA 软件，画原理图+PCB，可直接下单打样 |
| STM32CubeMX / Keil | ST 官方配置工具 / 编程 IDE |

## 六、推荐工具链（全部免费）

1. **嘉立创EDA（专业版）** —— 原理图 + PCB，已装好 ✅
2. **STM32CubeMX** —— 图形化配置外设（ADC/PWM/定时器），自动生成初始化代码
3. **Keil MDK 或 STM32CubeIDE** —— 写/编译/下载程序
4. **ST-Link** —— 下载器（实验室一般有，或买 10 元左右的 ST-Link V2 克隆版）
5. 元器件直接在 **立创商城（szlcsc.com）** 买，嘉立创EDA 里可直接导入商城封装
6. PCB 打样走 **嘉立创下单助手**（两层板学生打样很便宜，几块钱 5 片）

## 七、执行路线图（按周）

### 第 8 周：系统方案设计（模块①，权重 30%）
- [ ] 搞清需求、确定拓扑：Boost + 低侧 NMOS + 肖特基二极管 + MCU 数字控制
- [ ] 完成参数计算：电感量、输入/输出电容、开关频率 100kHz、采样分压电阻、电流采样方案
- [ ] 关键选型：STM32 型号（推荐 STM32F103C8T6 或 G031，便宜且资料多）、MOS 管、二极管、运放
- [ ] 画系统框图（输入 → Boost → 采样 → MCU → PWM → Boost 闭环）
- [ ] 产出《系统设计方案》文档

### 第 9~10 周：原理图（模块②，权重 25%）
- [ ] 在嘉立创EDA 中新建工程，逐块画：功率级 → 采样调理 → MCU 最小系统 → 保护 → 接口
- [ ] 电流采样方案确定（低侧采样电阻 + 运放放大，或 INA199 类采样芯片）
- [ ] ERC 电气规则检查，自查常见错误（缺去耦电容、网络名接错、封装缺失）
- [ ] 产出原理图源文件 + 元器件清单（BOM）

### 第 11~12 周：PCB（模块③，权重 30%）
- [ ] 布局：功率回路面积最小，功率级与 MCU 控制级分区，采样电路远离电感/MOS
- [ ] 布线：功率线加宽（≥1mm 以上按电流），星形/单点接地，模拟地与功率地单点汇接
- [ ] 预留测试点、电源输入/输出端子、SWD 下载口、串口
- [ ] DRC 通过 → 产出 PCB 源文件 + DRC 报告 → **下单打样（要留出物流时间！）**
- [ ] 同时写中期报告，**第 13 周期中汇报**

### 第 13 周：期中汇报（至少完成一半：方案 + 原理图 + PCB 进行中/已投板）

### 第 14~15 周：程序（模块④，权重 15%）
- [ ] CubeMX 配置：ADC（输出电压/电流采样）、定时器 PWM 100kHz、串口调试
- [ ] 程序框架：采样滤波 → PI 控制器 → CC/CV 模式切换 → 软启动 → 过压过流保护
- [ ] 先在评估板/最小系统板上验证 ADC+PWM，再上自制板

### 第 16~17 周：联调与测试
- [ ] 上电前检查（目测短路、量电源对地阻抗）→ 逐级上电
- [ ] 电子负载测试：CV 模式负载调整率、CC 模式精度、纹波、效率
- [ ] 记录测试数据和问题，报告里写"上电检查和主要问题"

### 第 18 周：答辩
- 提交：设计报告（四模块各一节）、原理图/PCB 源文件、程序源码、测试记录

## 八、给零基础团队的三个关键提醒

1. **PCB 打样有 3~7 天物流周期**，第 12 周前必须下单，否则实物联调来不及。
2. **每个环节"输入→处理→输出"都留文档**：这既是评分点（工程规范），也直接对应四个"智能体"的表述要求。
3. **先让 STM32 最小系统板跑通"ADC 读数 + PWM 输出 + 串口打印"**，再碰自制板。硬件和软件第一次联调不要同时引入两个未知量。

## 九、当前待确认事项（问老师/组员）

- [ ] "智能体"是否要求用 AI 工具辅助设计并记录过程？有无模板？
- [ ] 是否要求做实物（打样+焊接），还是可以只交设计文件+仿真？
- [ ] 实验室可借用的仪器：电子负载、示波器、ST-Link、直流电源是否齐全？
- [ ] 组内 4 人分工确定
