lcw578/STM32-project/执行计划.md

# 大作业完整执行计划 —— MCU 控制的 Boost 恒流恒压电源

> 版本：v1.0（2026-11-02）　依据《嵌入式系统实践课程设计要求.docx》制定
> 技术路线：**ZCode（AI）+ easyeda-agent（开源嘉立创EDA自动化工具）+ 嘉立创EDA专业版**
> 目标：一步到位完成四大模块（系统设计 30% / 原理图 25% / PCB 30% / 程序联调 15%）

---

## 0. 总体思路：为什么这条路线能"一步到位"

课程要求四个环节各做成一个"智能体"，并要求每个智能体有明确的**输入 → 处理流程 → 输出**。我们的技术路线天然满足：

| 课程模块 | 权重 | 由谁完成 | 怎么完成 |
|---|---|---|---|
| ① 系统设计智能体 | 30% | **ZCode** | 解析需求 → 参数计算 → 器件选型 → 输出《系统设计方案》 |
| ② 原理图设计智能体 | 25% | **easyeda-agent**（由 ZCode 驱动） | 通过官方 `eda.*` API 在嘉立创EDA专业版中真实绘制、连线、检查、回读 |
| ③ PCB设计智能体 | 30% | **easyeda-agent**（由 ZCode 驱动） | 分区布局 → 布线 → 铺铜 → 丝印 → DRC → 导出制造文件 |
| ④ 程序设计智能体 | 15% | **ZCode** | CubeMX 配置 + STM32HAL 代码：ADC/PWM/PI/CC-CV/保护 |

每个阶段都保留：输入文档、AI 执行记录（截图/日志/回读证据）、输出文件 —— 这些直接就是报告素材和答辩证据。

**easyeda-agent 是什么（已调研确认）**：开源项目（MIT 协议），嘉立创EDA专业版的 AI 自动化层，由三部分组成：
1. `easyeda` CLI + 后台守护进程 daemon（Go 语言，监听 60832 端口）
2. **EDA Agent Connector**：装进嘉立创EDA专业版里的扩展插件（.eext），负责在编辑器里执行官方 `eda.*` API
3. **easyeda-agent Skill**：给 AI 客户端（Claude Code / Codex / ZCode 兼容）用的操作手册

它能做：从需求描述 → 选型 → 原理图 → 分区布局 → 布线 → 铺铜 → 丝印 → DRC → 制造检查的完整流程，每一步写入后都回读校验（引脚、网络、几何），并输出 BOM/网表/检查报告 —— 正好覆盖课程评分点"文件可检查""识别常见设计错误并给出修改建议"。

---

## 1. 阶段〇：环境搭建（预计 1~2 小时，今天就能完成）

### 1.1 确认嘉立创EDA专业版版本

- 打开嘉立创EDA专业版 → 菜单 **帮助 → 关于** → 确认版本号 **≥ V4.1.60**（项目推荐基线；低于 4.0 会直接不兼容）
- 如果是标准版/旧版专业版，去 https://pro.lceda.cn 或官网重新下载最新专业版
- 网页版和桌面客户端都可以，推荐**桌面客户端**（稳定、不依赖浏览器）

### 1.2 安装 easyeda-agent CLI（Windows）

仓库已克隆到 `E:\STM32_design\tools\easyeda-agent`（commit 4a74c56，52MB，含完整 Skill 与文档）。

> **网络说明（本机已验证）**：本机直连 GitHub 会超时，代理为 Clash 系、混合端口 `127.0.0.1:7890`。
> git 命令行不走 Windows"系统代理"开关，需要显式指定。让 git 对 GitHub 永久走代理（执行一次即可）：
>
> ```bash
> git config --global http.https://github.com.proxy http://127.0.0.1:7890
> ```
>
> 代理客户端更换端口时同步更新该配置。PowerShell 的 `Invoke-WebRequest` / `irm` 会自动走系统代理，无需额外设置。

安装 CLI + Skill（PowerShell 5.1 或 7，`irm` 自动走系统代理）：

```powershell
irm https://raw.githubusercontent.com/zhoushoujianwork/easyeda-agent/main/install.ps1 | iex
```

若安装脚本失败，改用镜像下载后执行：

```powershell
Invoke-WebRequest "https://gh-proxy.com/https://raw.githubusercontent.com/zhoushoujianwork/easyeda-agent/main/install.ps1" -OutFile "$env:TEMP\install.ps1"
powershell -ExecutionPolicy Bypass -File "$env:TEMP\install.ps1" -AddToPath
```

手动兜底方案（安装脚本也失败时）：到 [Releases](https://github.com/zhoushoujianwork/easyeda-agent/releases) 下载 `easyeda_windows_amd64.exe` → 改名 `easyeda.exe` 放到 `%USERPROFILE%\.local\bin` → 加入用户 PATH → 执行 `easyeda update --skill-only --create-missing` 安装 Skill。

**验证**：新开终端运行 `easyeda --version` 和 `easyeda sch compose --help`（这两个命令不需要 daemon，能跑通说明安装成功）。

### 1.3 安装 Connector 插件（国内最简单路径）

1. 打开嘉立创EDA专业版 → **高级 → 扩展管理器 → 扩展广场** → 搜索 **EDA Agent** → 找到 **「EDA Agent Connector」**（作者 **zhoushoujian**，描述为 "Bridges the local agent daemon to the official eda.* API"）→ 安装
   ⚠️ **不要装混**：列表里的「EDA API Agent」（JLCEDA 官方）、「JLCEDA AI Agent」（Codex）是别的工具
   （备用：从 GitHub Release 下载 `.eext` 侧载导入）
2. **关键一步**：扩展管理器 → **已安装** → 选中连接器 → **Config 页签 → 勾选"允许外部交互 / Allow interactive with external"**
   （不勾这个，连接器会报 "Daemon not found"——这是最常见的坑）

### 1.4 启动与联调验证

**【2026-11-02 进度】CLI v1.16.0 已装好（`%USERPROFILE%\.local\bin\easyeda.exe`，已加入 PATH）；
Skill 已装入 claude/codex/agents 三处；daemon 已启动（端口 60832）。
剩余：在嘉立创EDA中安装 Connector 插件并勾选"允许外部交互"，然后 `easyeda health` 应显示连接正常。**

验证清单：
- [x] `easyeda --version` 显示 v1.16.0，离线命令可用
- [x] `easyeda update --check` 显示 cli/skill/daemon 全部 current 1.16.0
- [ ] `easyeda health` 显示连接器已连接（等用户装好插件后）
- [ ] 嘉立创EDA中**新建云端工程**，命名 `boost-cccv-psu` 并打开工程内任意一张原理图页面

> ⚠️ 注意事项（来自项目文档）：CLI、daemon、Skill 三者必须**精确同版本**；连接器按 major.minor 对齐。升级顺序：`easyeda update` → 重启 daemon → 需要时才换连接器。全程不要在 Git Bash/WSL 和原生 Windows 之间混用二进制。

### 1.5 硬件/物料准备（与软件并行）

- [ ] STM32 最小系统板（Blue Pill，STM32F103C8T6）×1 —— 约 10 元，提前验证程序用
- [ ] ST-Link V2 下载器 ×1 —— 约 10 元
- [ ] 确认实验室仪器：5V 直流电源、电子负载（CC/CR 模式）、示波器、万用表
- [ ] 元器件在立创商城（szlcsc.com）选购，BOM 在第 2 阶段确定后一次购齐
- [ ] **推荐**：PCB 打样时直接用**嘉立创 SMT 贴片服务**（提交 BOM + 坐标文件，工厂把贴片元件焊好），零焊接经验团队只需手焊接插件

---

## 2. 阶段一：系统设计智能体（权重 30%，预计 1~2 天）

### 输入
老师技术指标表（见分析文档第二节）。

### 处理流程（ZCode 执行）

**2.1 需求解析**：明确 CC/CV 双模式定义 —— 输出电流 < 0.5A 时恒压 12V；达到 0.5A 时自动转恒流。

**2.2 关键参数计算**（全部写出计算过程，这是评分点"参数计算有依据"）：

| 计算项 | 预算结果（阶段一精确化） | 公式/依据 |
|---|---|---|
| 开关频率 | **100 kHz**（按老师建议） | 周期 10 µs |
| 额定占空比 | D ≈ 1 − 5/12 ≈ **0.583** | Boost 理想关系 Vout = Vin/(1−D) |
| 占空比限幅 | **D_max = 0.85**（软启动从 0 斜坡上升） | 防失控 |
| 输入电流 | Iin ≈ 6W/(0.85×5V) ≈ **1.41 A** | 效率假设 85% |
| 电感量 | L = Vin·D/(fs·ΔIL)，取 ΔIL=30%·Iin → **约 69 µH，选 68~100 µH 标准值** | 电感电流纹波 |
| 电感规格 | 饱和电流 **≥ 3 A**（峰值 ≈ 1.62 A） | 一体成型/功率电感 |
| 输出电容 | 220 µF 电解（低 ESR）+ 10 µF 陶瓷 | 纹波 ≤3% 目标 + 环路稳定 |
| 输入电容 | 100 µF 电解 + 10 µF 陶瓷 | 吸收输入纹波 |
| MOS 管 | 30 V 逻辑电平 NMOS（如 AO3400A，30V/5.7A/Rds≈28mΩ） | Vds 应力 ≈ Vout+尖峰 |
| 整流二极管 | 肖特基 SS34（40V/3A） | 导通损耗小 |
| 栅极驱动 | 3.3V PWM 直驱（或 NPN/PNP 图腾柱，阶段一定稿） | 课程要求"驱动电路" |
| 输出电压采样 | 30k/10k 精密分压 → 3.0V @12V | 12×10/40=3V，留 ADC 余量 |
| 输出电流采样 | 50 mΩ 采样电阻 + **INA180A2**（增益 50）高端检测 → 0.5A↦1.25V | 0.5A×50mΩ=25mV |
| MCU | **STM32F103C8T6**（72MHz，资料最全） | TIM1 PWM：72M/100k=**720 级**占空比分辨率；ADC 1Msps |
| 采样方式 | TIM1 触发 ADC 注入组，每开关周期采样一次 | 数字电源标准做法 |
| 控制律 | 电压环 PI + 电流环 PI，**取小值**输出占空比；抗积分饱和 | CC/CV 无扰切换 |
| 保护 | OVP：Vout>13.2V 关 PWM；OCP：I>0.6A 降额/关断；D 限幅 0.85；软启动 ~50ms | 建议目标全覆盖 |
| 效率预算 | SS34 损耗≈0.25W，MOS 导通≈0.06W+开关损耗 → 目标 **≥80%** | 满足 ≥75% 要求 |

**2.3 器件选型表**：每个器件给出 LCSC 编号（C号）、关键参数、选型理由、单价 —— 直接可用于后续下单。

**2.4 系统框图**：`5V输入 → 输入滤波 → Boost功率级(L/MOS/SS34) → 输出滤波 → 输出端子`；采样支路（V分压、I采样运放）→ STM32（ADC→PI→PWM→驱动）→ MOS 栅极；辅助电源（5V→3.3V LDO）。

### 输出
- 《系统设计方案》文档（Word）：需求解析 / 拓扑与工作模式 / 参数计算书 / 选型表 / 框图 / 风险分析
- 器件 BOM 初版（立创商城可购链接）

---

## 3. 阶段二：原理图设计智能体（权重 25%，预计 2~3 天）

### 输入
《系统设计方案》+ BOM 初版 + 立创商城器件数据手册。

### 处理流程（ZCode 驱动 easyeda-agent，全部在嘉立创EDA中真实执行）

按功能块分 6 块绘制，每块完成即运行 `sch check`（原理图连接与几何检查）：

1. **Boost 功率级**：输入端子 → 输入电容 → 电感 → NMOS（栅极接驱动网络）→ SS34 → 输出电容 → 输出端子
2. **栅极驱动**：MCU PWM 脚 → 图腾柱/直驱 → 栅极电阻（10Ω）+ 下拉电阻（100k）
3. **采样调理**：Vout 分压网络（含 RC 滤波）→ MCU ADC1；INA180A2 电流检测 → MCU ADC2；预留 ADC 输入保护电阻
4. **MCU 最小系统**：STM32F103C8T6 + 8MHz 晶振 + 复位电路 + BOOT0 跳线 + 0.1µF 去耦×N + 3.3V LDO（如 ME6211）
5. **调试接口**：SWD 4pin（SWDIO/SWCLK/3V3/GND）+ USART 串口排针（PA9/PA10）
6. **保护与指示**：电源 LED、状态 LED×2（CV/CC 指示）、保险丝/自恢复保险、预留 TVS

每一块用 easyeda-agent 完成：**放置器件（用立创商城标准器件+LCSC C号）→ 连线 → 网络标号 → 检查 → 回读对账**。

### 常见错误自查清单（评分点"识别常见设计错误并给出修改建议"）
- [ ] 每个芯片电源脚有去耦电容且就近
- [ ] 网络标号拼写一致（GND/3V3/12V_OUT/PWM_GATE…）
- [ ] 无悬空引脚（未用的 NC 明确处理）
- [ ] ADC 输入有分压/滤波，不超 3.3V 量程
- [ ] MOS 栅极有下拉（防上电漂浮误导通）
- [ ] 二极管/电解电容极性、封装方向正确
- [ ] ERC 电气规则检查 0 error

### 输出
- 原理图源文件（嘉立创EDA云端工程）
- 检查记录（sch check 结果 + 修复日志）
- 正式 BOM（含 C 号、数量、单价）
- 原理图 PDF/截图（报告用）

---

## 4. 阶段三：PCB设计智能体（权重 30%，预计 3~4 天含检查）

### 输入
定稿原理图 + 器件封装（立创商城器件自带封装）。

### 处理流程（ZCode 驱动 easyeda-agent）

**4.1 板框与叠层**：两层板，板框建议 **70 × 50 mm**（功率区+控制区+两端子空间），圆角矩形，四角 M3 固定孔。

**4.2 分区布局**（评分核心"功率级与控制级布局合理"）：

```
┌────────────────────────────────────────┐
│ [5V IN端子] [功率区: Cin-L-MOS-D-Cout]   │  ← 功率回路面积最小化
│              ↑采样电阻/INA180 在功率区内  │
│ [12V OUT端子]  ―――――――――                │
│ [控制区: LDO+MCU+晶振+SWD+串口+LED]      │  ← 远离电感/MOS
└────────────────────────────────────────┘
```

**4.3 布线规则**：
- 功率主干线（Cin→L→MOS→D→Cout）**短而粗 ≥ 2mm**，回流面积最小
- 大电流地（功率地）与小信号地**分区单点汇接**（星形接地，评分点"地回流清晰"）
- 采样走线远离电感/栅极开关节点，必要时包地
- 栅极走线短，驱动回路紧凑

**4.4 铺铜与丝印**：底层整片 GND 铺铜 + 顶层补充；过孔缝合；丝印标注接口名（5V IN / 12V OUT / SWD / TX RX）、LED 极性、板名版本号 —— easyeda-agent 可自动避让焊盘。

**4.5 检查与交付**：
- [ ] DRC 设计规则检查通过（`pcb drc` passed:true）
- [ ] DFM 可制造性检查
- [ ] 导出 Gerber + BOM + 坐标文件
- [ ] 3D 预览截图归档

**4.6 打样与贴片**：
- 嘉立创下单：2 层板 5 片（打样费几元）+ 可选 **SMT 贴片**（推荐：贴片元件由工厂焊好）
- **BOM 元件同时下单**（立创商城），手焊部分：端子、排针
- ⏰ **物流 3~7 天** —— 这是全项目时间关键路径，PCB 定稿后立即下单

### 输出
- PCB 源文件 + DRC 报告 + Gerber + 坐标文件
- 《布局考虑说明》（评分要求：说明关键布局考虑）
- 下单记录 + 打样照片

---

## 5. 阶段四：程序设计智能体（权重 15%，预计 3~5 天，与打样物流并行）

> **工具已确认：STM32CubeIDE**（用户已安装）。CubeIDE 内置 CubeMX 配置器（.ioc 文件双击即开），
> 配置、生成代码、编译、下载调试全部一个软件完成，无需另装 Keil 或独立 CubeMX。

### 输入
《系统设计方案》参数 + STM32F103C8T6 + Blue Pill 验证板（先在成品板上跑，板子到了直接移植）。

### 处理流程（ZCode 执行）

**5.1 CubeMX 配置**：
- 时钟 72MHz（HSE 8M ×9）
- TIM1 CH1：PWM 100kHz，中心/边沿对齐，占空比 CCR1（0~720）
- ADC1 双通道（IN0=Vout 分压，IN1=Isense），注入组由 TIM1 触发，每周期采样
- USART1 115200：调试打印
- GPIO：LED×2（CV/CC 指示）、OVP/OCP 快速比较用

**5.2 程序框架（模块化）**：
```
main.c
 ├── adc.c        采样 + 滑动平均滤波
 ├── control.c    电压环 PI / 电流环 PI / 取小切换 / 抗积分饱和 / 软启动斜坡
 ├── protect.c    OVP(>13.2V) / OCP(>0.6A) / D限幅(0.85) / 故障锁存与恢复
 ├── pwm.c        TIM1 封装 + 安全关闭（刹车输入）
 └── debug.c      串口命令行：设定 V/I 目标、读实测、开环测试占空比
```

**5.3 调试顺序（每步都有验证标准）**：
1. Blue Pill 上跑通 ADC 读数 + 串口打印（用万用表对照读数标定）
2. PWM 输出示波器确认 100kHz、占空比可调
3. **开环测试**：直接给固定占空比，万用表看输出电压是否符合 Boost 关系（验证功率级）
4. 闭环 CV：12V 目标，PI 从保守参数（Kp 小、Ki 小）整定
5. 闭环 CC：0.5A 目标 + CC/CV 自动切换
6. 全部保护逻辑注入测试（人为过载/短路看是否动作）

### 输出
- 完整 STM32CubeIDE 工程（.project + .ioc + 源码，导入即可编译）
- 串口调试记录 + 各阶段验证照片/截图
- 程序设计说明（ADC 通道表、PI 参数、保护阈值表）

---

## 6. 阶段五：实物联调与测试（预计 2~3 天，板子到手后）

### 上电检查流程（评分要求"记录上电检查和主要问题"）
1. 未上电：目测桥连/极性 → 万用表量 5V-GND、12V-GND 阻抗，排除短路
2. 只接 5V 不接负载：量 3.3V、量 Vout（应≈0，PWM 未开）
3. ST-Link 下载程序 → 串口确认 ADC 读数正常 → 开环小占空比（D=0.1）看 Vout 上升
4. 软启动闭环 → 空载 12V 稳定 → 上电子负载

### 正式测试项（电子负载 CC/CR 模式）
| 测试项 | 方法 | 判据 |
|---|---|---|
| CV 稳压精度 | 负载 0→0.5A 扫描，记录 Vout | 12V±5%（目标±2%） |
| CC 精度 | 负载降阻至电流限制，记录 Iout | 0.5A±5% |
| 纹波 | 示波器测 Vout AC 耦合，满载 | ≤5%（目标≤3%） |
| 效率 | 输入功率 vs 输出功率，额定点 | ≥75% |
| 软启动 | 示波器看 Vout 上升沿 | 无过冲 |
| 保护 | OVP/OCP 注入 | 动作且可恢复 |
| CC/CV 切换 | 负载扫描过临界点 | 无振荡 |

### 输出
《测试记录表》：每项的原始数据 + 波形截图 + 问题与改进记录。

---

## 7. 阶段六：文档、报告与答辩

- **第 13 周期中报告**：四模块进展（届时预计全部完成设计+打样，含实物照片）——远超"至少完成一半"
- **最终设计报告**：按四智能体结构组织，每章按"输入→处理流程→输出"写，附：系统框图、参数计算书、原理图、布局图、DRC/检查结果、程序流程图、测试数据
- **答辩 PPT**：10~15 页，突出 ①AI 智能体工作流（这是本课程特色，老师明确要求）②参数计算依据 ③实测数据 vs 指标对照表
- 交付文件包：设计报告、原理图/PCB 源文件、Gerber、BOM、程序源码、测试记录

---

## 8. 周计划总表

| 周次 | 任务 | 里程碑 |
|---|---|---|
| 第 8 周（本周） | 阶段〇环境搭建 + 阶段一系统设计 | 方案定稿、BOM 确定 |
| 第 9 周 | 阶段二原理图 + 阶段三开始 | 原理图完成、检查通过 |
| 第 10 周 | 阶段三 PCB 完成 → **下单打样+SMT** | 🚨 Gerber 交付 |
| 第 10~11 周 | 阶段四程序（Blue Pill 上验证） | 开环+CV 调通 |
| 第 11~12 周 | 板到手 → 阶段五联调 | CC/CV 闭环、保护 |
| 第 12 周 | 阶段五测试 + 阶段六文档 | 测试数据齐 |
| 第 13 周 | **期中汇报** | 中期报告提交 |
| 第 14~17 周 | 缓冲：指标优化（效率/纹波）、报告完善、预答辩 | — |
| 第 18 周 | **最终答辩验收** | 全部交付 |

> 一步到位策略：环境+设计+程序全部赶在打样物流期内完成，实物到手时软件已就绪，联调只留 2~3 天。

---

## 9. 风险与回退方案

| 风险 | 概率 | 回退方案 |
|---|---|---|
| easyeda-agent 连接/版本问题 | 中 | 项目文档有完整排障手册（environment-setup.md）；最终兜底：ZCode 逐步指导手动画图（嘉立创EDA是成熟软件，手动画 6 个功能块约 2~3 天） |
| GitHub 访问慢/失败 | 中 | 用 gh-proxy.com 镜像（已验证克隆路径）；CLI 安装器自带镜像回退 |
| 打样物流超期 | 低 | 第 10 周准时下单；如超期，用 Blue Pill + 洞洞板先做功率级验证 |
| 闭环振荡/纹波超标 | 中 | PI 参数保守起步；开关频率降到 50kHz；加大输出电容 |
| 采购器件缺货 | 低 | 选型时每类准备 2 个替代型号（阶段一处理） |
| 智能体要求理解偏差 | — | **本周问老师确认**：是否要求记录 AI 辅助过程/有无报告模板（我们实际全程用 AI，怎么答都不吃亏） |

---

## 10. 立即行动清单（今天）

1. [ ] 打开嘉立创EDA专业版 → 确认版本 ≥ V4.1.60 → 高级→扩展管理器→市场→安装 easyeda-agent 连接器 → Config 勾选"允许外部交互"
2. [ ] 告诉 ZCode"开始装 easyeda-agent CLI"，由 ZCode 执行安装与 `easyeda health` 验证
3. [ ] 新建云端工程 `boost-cccv-psu`
4. [ ] 下单 Blue Pill + ST-Link（顺手的事，明天就能到）
5. [ ] 问老师：智能体是否有模板要求；实验室电子负载/示波器借用方式
6. [ ] 说"开始阶段一" → ZCode 产出《系统设计方案》完整初稿
