lcw578/STM32-project/sch_work/board3d_v2/height_map.png

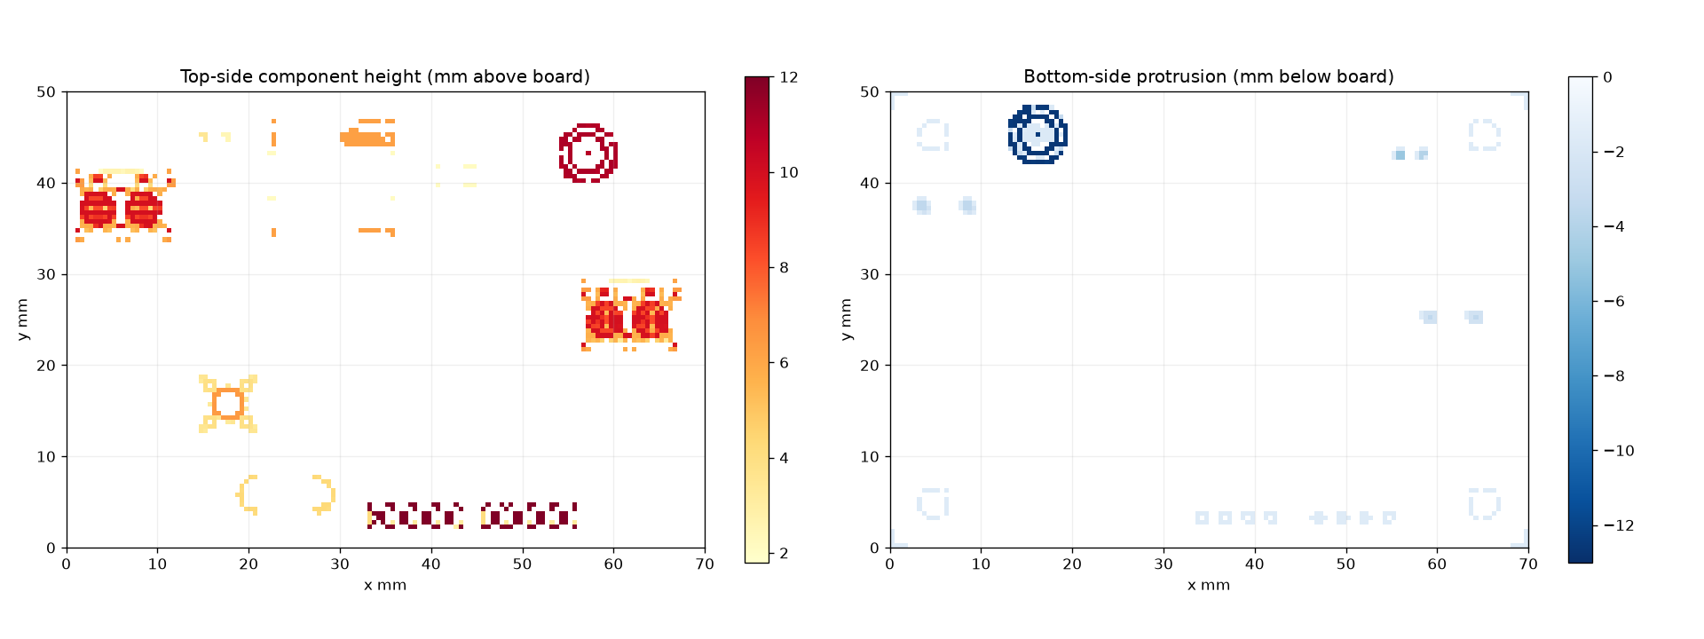
sch_work/board3d_v2/height_map.png
