lcw578/STM32-project/sch_work/board3d_v2/side_views.png

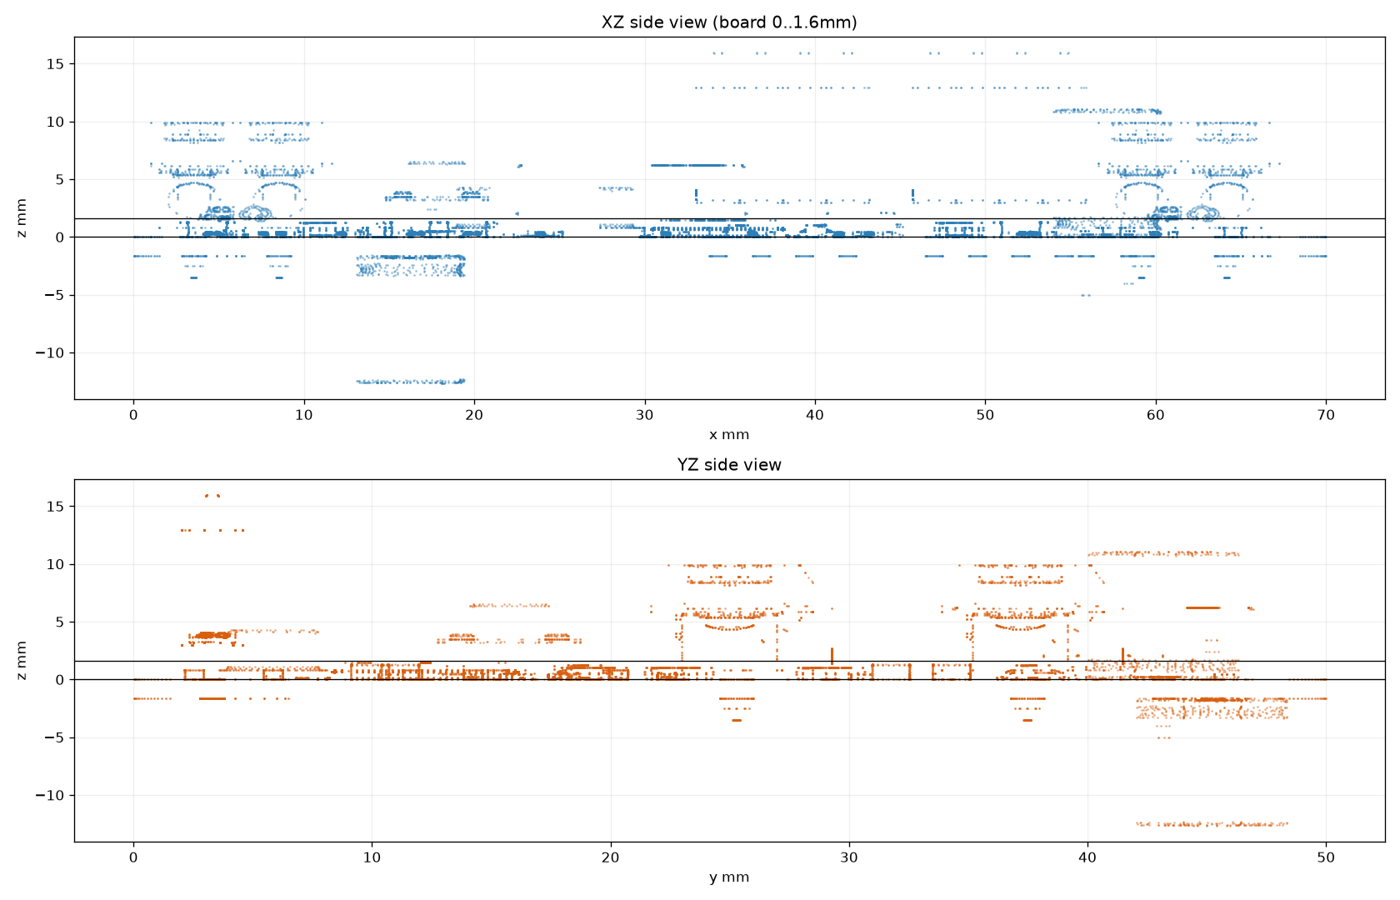
sch_work/board3d_v2/side_views.png
