lcw578/STM32-project/sch_work/review_placement.png

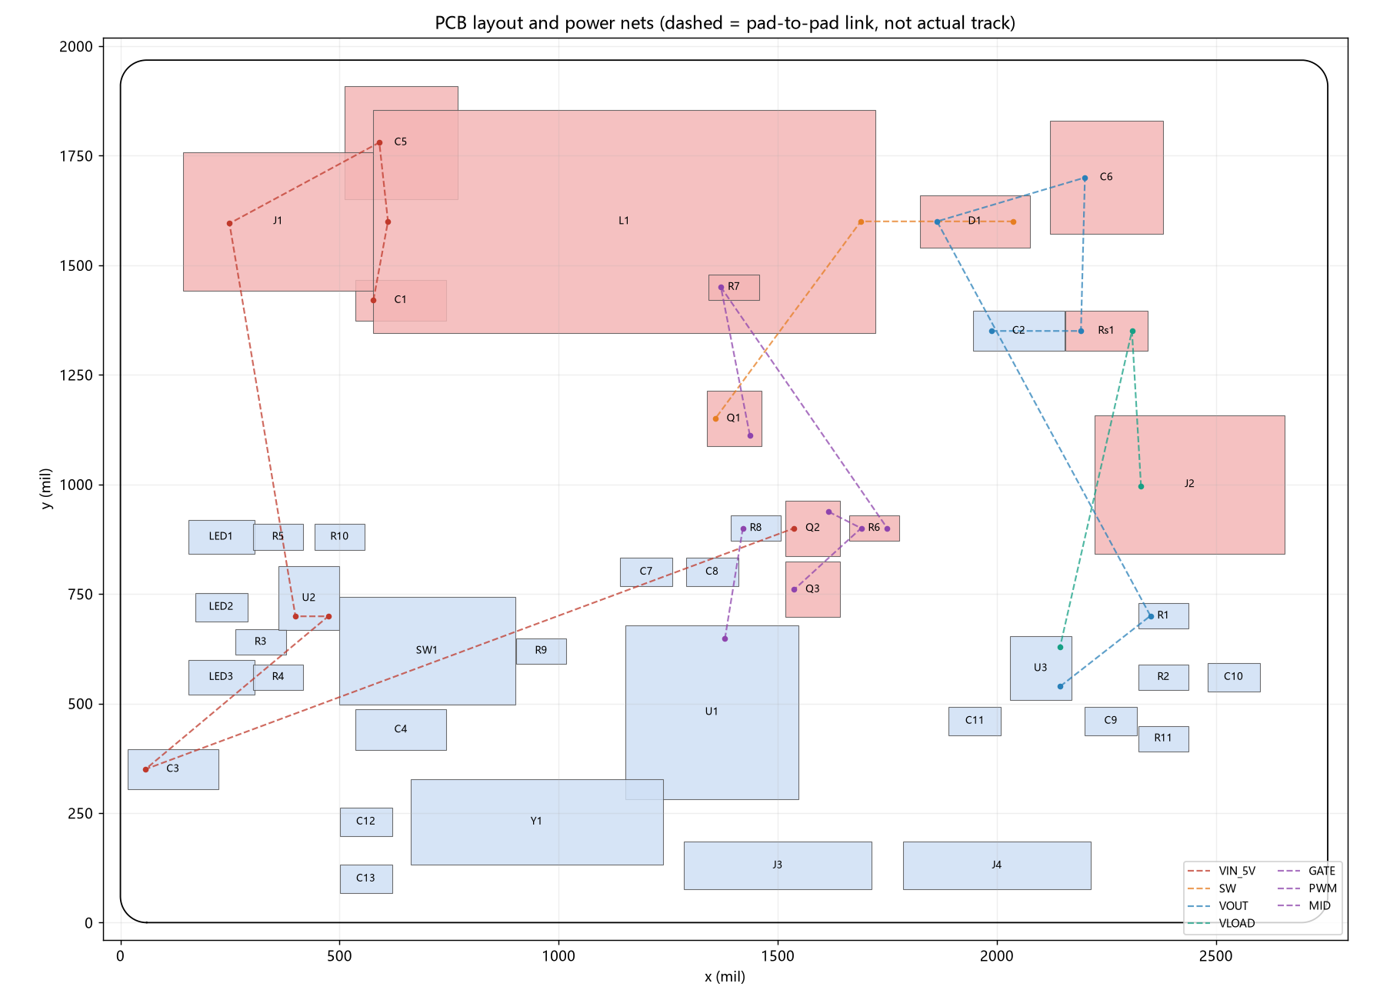
sch_work/review_placement.png
