lcw578/STM32-project/sch_work/review_placement_v2.png

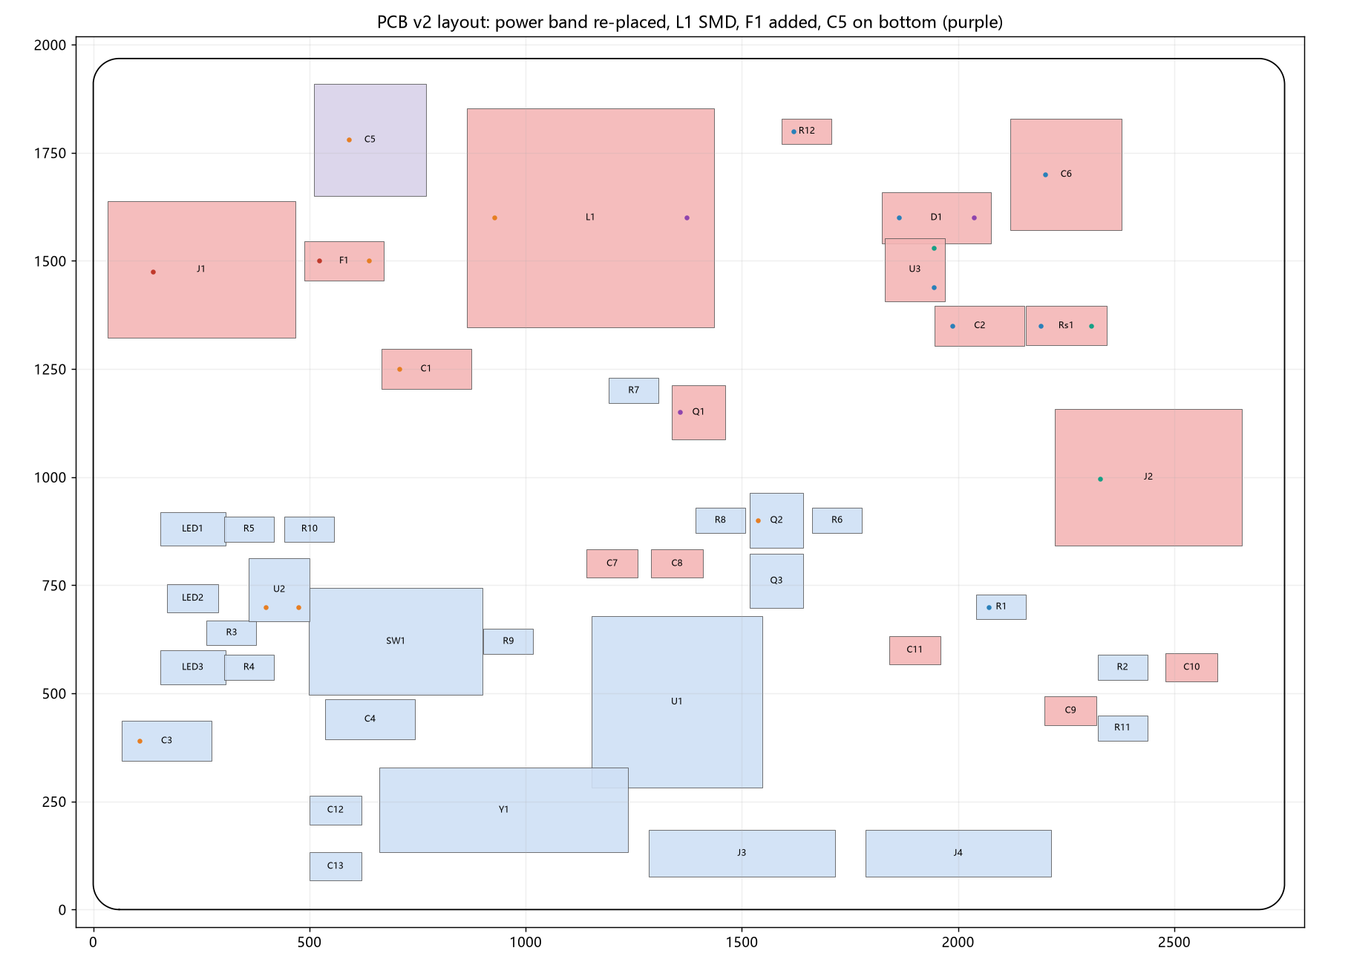
sch_work/review_placement_v2.png
