lcw578/STM32-project/sch_work/sch_before.png

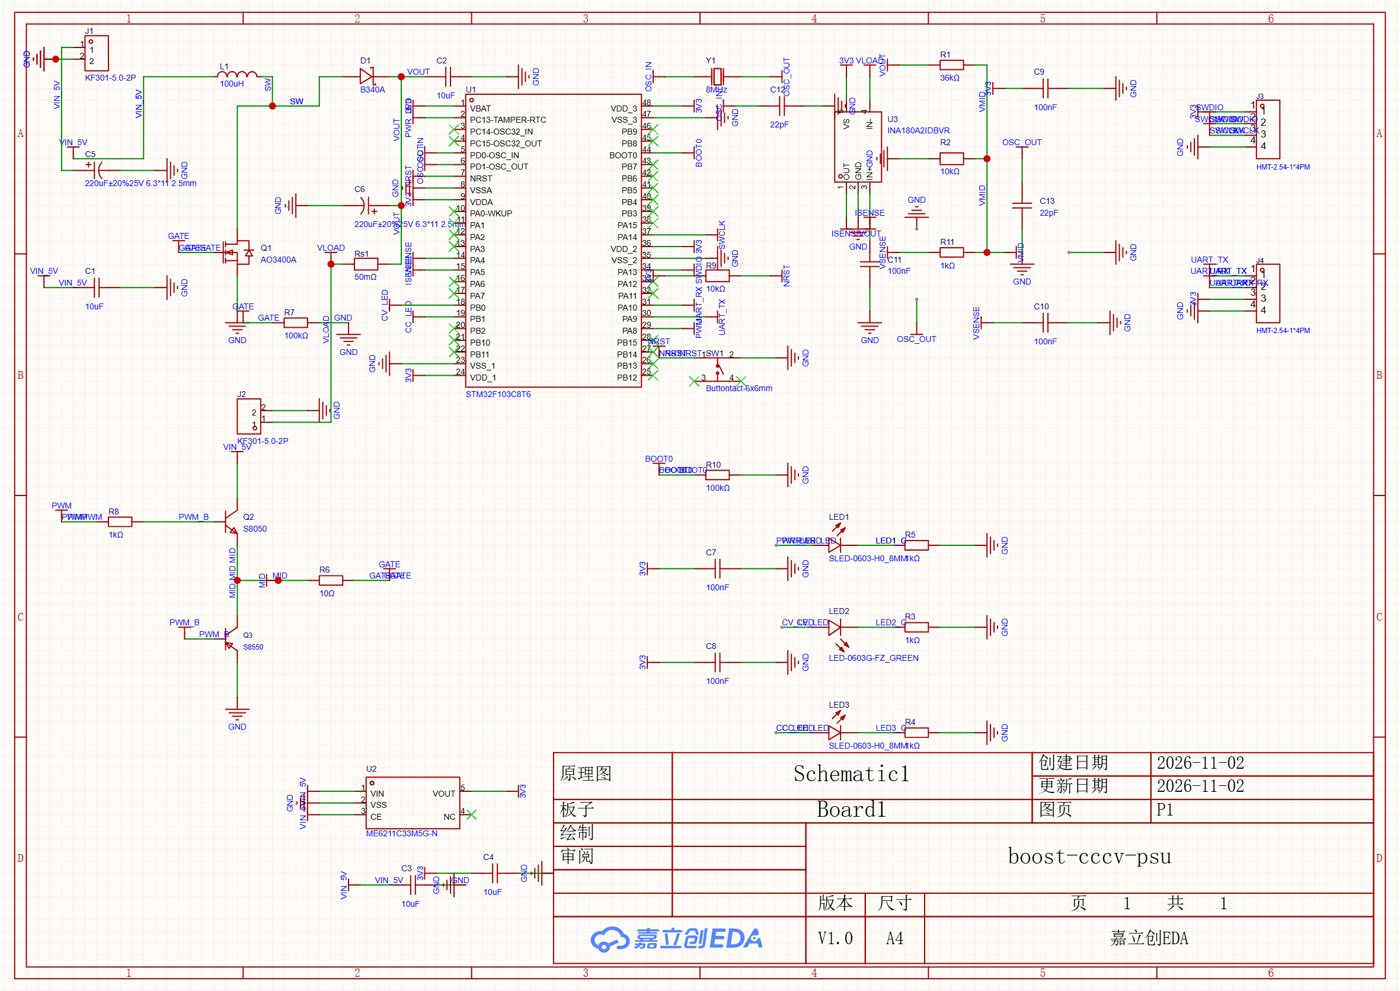
sch_work/sch_before.png
