lcw578/STM32-project/sch_work/sch_gatedrive_crop.png

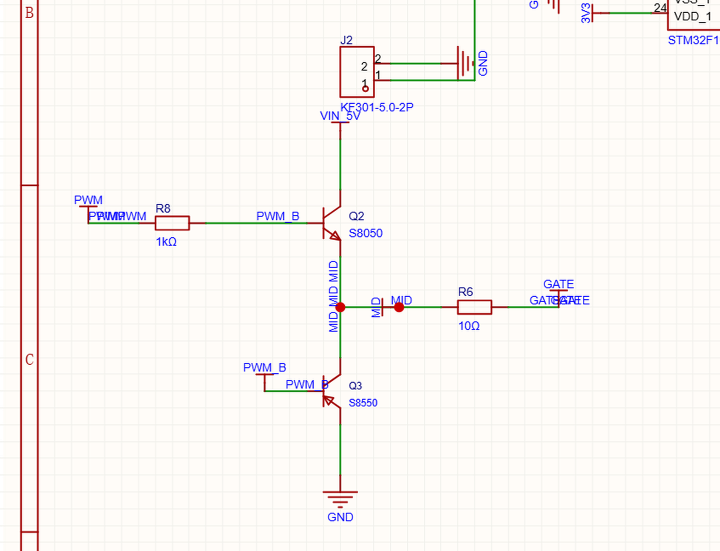
sch_work/sch_gatedrive_crop.png
