lcw578/STM32-project/04_设计审计与整改清单.md

# 04_设计审计与整改清单 v2（完整版）

> 审计日期：2026-11-03　|　审计范围：原理图网表、PCB 几何/Gerber/DFM、固件全部源码、仿真模型与结果、四份文档
> 方法：网表逐脚核对 → Gerber 光圈/钻孔解析 → EDA 只读 DFM 与安装孔预演 → 固件逐行 → 用真实采样时间常数重跑 S8
> **总结论：控制层仿真可信；板级有 5 项阻断、7 项严重问题，必须先改再打样。仿真有 5 个模型盲区，其中 2 个直接影响结论。**

---

## 0. 问题总表

### 阻断级（不改就不能用）

| # | 问题 | 证据 | 后果 |
|---|---|---|---|
| **A1** | 栅极驱动 Q3（PNP）E/C 接反 | 网表 `Q3.2(E)=GND`、`Q3.3(C)=MID` | 关断只经 B-C 结 + 1k 放电，沿 1~2µs；100kHz 下 Q1 放大区耗散约 1W，十几秒过热；且 OVP/OCP 锁存后栅极关不干净，**所有软件保护失效** |
| **A2** | L1 圆柱体压住 C5 | L1 是 Ø12.7×23.4 轴向件，轴线 y=1600；C5 是 6.3×11mm 立式电解，中心 (640,1780) | 几何上必然相交，装不进去；C1 只剩 0.4mm、R7 只剩 0.19mm 间隙，且 R7 在电感正下方拾取磁场 |
| **A3** | 输入/输出端子的接线通道被堵 | DFM：C1 在 J1 的 250mil 插拔走廊内；R1 在 J2 的走廊内 | 端子螺丝能拧，但导线插不进去——**板子接不上线** |
| **A4** | 四角 M3 只做出来 2 个 | `mount-holes --dry-run`：tl 被 J1 挡、bl 被 C3 挡，只有 tr/br 存在 | 板子只能单边固定，平放会翘；STATUS 里“四角 M3”不成立 |
| **A5** | 没有保险丝 | 42 器件无 F1，网表无保险丝，板外也没有 | 硬短路 35A 永续（报告 F4 已证），唯一屏障不存在；Rs1 在短路时耗散 61W，会比预期更早失效 |

### 严重级（能用，但会出问题/丢分）

| # | 问题 | 证据 | 后果 |
|---|---|---|---|
| **B1** | 全板走线 8/10mil，功率路径也是 | Gerber：只有 0.2032 / 0.254 / 0.2484mm 三种；DFM：GND 有 101 段低于 19.7mil | VIN 1.4A 温升约 40°C；VOUT 51.9mm×0.2mm≈128mΩ，负载调整率被吃掉约 0.75%；违反方案 §4.3“≥2mm”，评分点丢分 |
| **B2** | 采样滤波实际 180Hz，仿真按 1.6kHz | R_th=36k∥10k+1k=8.83k，C=100nF → τ=883µs | 用真实 τ 重跑 S8：**kp_v=0.08 从“通过”变成持续振荡**，稳定域上限从 0.08 降到 0.06；**v2 已把 C10 改 10nF（τ=88.3µs），稳定域恢复 kp≤0.08 且 ki≤65（见 03 §11）** |
| **B3** | C11 100nF 直挂 INA180 输出 | ISENSE 对地 100nF，中间无串阻 | 运放容性负载远超推荐（一般 ≤1nF），可能 MHz 振荡，CC 段读数失真 |
| **B4** | 电流/电压采样走线又长又并行 | ISENSE 27.1mm、VSENSE 27.7mm；DFM：两者并行 14mil×257mil | 25mV 的电流信号走 27mm，且与电压反馈并行 6.5mm，串扰/拾噪未建模；CC 精度可能明显差于仿真的 −0.41% |
| **B5** | SW 节点 24.8mm、栅极 21.8mm | `pcb report` 实测 | Q1 距 L1 焊盘 14mm，功率回路面积大；栅极电阻 R6 距 Q1 栅极 9.6mm，阻尼不在管脚处，振铃/EMI 风险 |
| **B6** | 丝印只有位号和型号，没有功能标注 | 129 条丝印全是 attribute，无 “5V IN/12V OUT/SWD/CV/CC”、无电解电容 “+”、无板名版本 | 又没有防反接，**输入接反就烧**；答辩时也看不出接口 |
| **B7** | 3D 检查从未做过（模型其实已有 42/44） | `pcb 3d models`：42 bound / 2 unbound（J3/J4） | A2/A4 这类高度/包络冲突看不到；本可提前发现，结果全部漏掉 |

### 中等/轻微

| # | 问题 | 证据 | 说明 |
|---|---|---|---|
| C1 | 去耦电容偏远 | DFM：C4 距 U2.5 10mm、C9 距 U3.5 6.0mm、C7/C8 4.2/4.4mm（判据 2.54mm） | C2/C6 是输出电容，属误报；C4/C9 应拉近 |
| C2 | 无 Mark 点 | DFM：127 个表贴焊盘、0 个 fiducial | 嘉立创拼板会加，单板贴片影响小 |
| C3 | J3/J4 插头会碰 | 中心距 12.70mm < 12.91mm 包络 | 两个杜邦头不能同时插 |
| C4 | SWD 排针没有 NRST | J3 = 3V3/SWDIO/SWCLK/GND | 不能用 “Under Reset” 模式；固件睡死时只能手动复位 |
| C5 | 输出无泄放电阻 | 关机后 220µF 只经 46k 分压放电，τ≈10.6s | 再次上电/测量时输出仍带电，易误判 |
| C6 | 无防反接 | J1 直接进 L1/Q1 | 反接时电流经 Q1 体二极管→L1 形成直通，薄走线可能瞬间烧断 |
| C7 | 6 处丝印压焊盘 | DFM | 嘉立创会裁掉，纯观感 |
| C8 | 1 处 45° 锐角 | DFM @(1242,354) 3V3 | 酸角，轻微 |
| C9 | 无 IWDG | 固件 | 主循环卡死时 PWM 保持最后占空比 |
| C10 | 无上电自检 | 固件 | ADC/DMA 没起来时 Vout 读 0，PI 会把占空比推到 0.85 → 输出泵到 30V（见 D3） |
| C11 | `sv` 上限 14V > OVP 13.2V | cli.c:73 | 手滑 `sv 13.5` 立即 OVP 锁存；README 反而把它当 OVP 测试法 |
| C12 | `cal` 命令只写在注释里 | bsp_power.h:19 | 实际没有校准命令，3.3V 基准 ±2% 无法修正 |

### 固件（在报告 R2~R5 之外）

| # | 问题 | 位置 | 后果 |
|---|---|---|---|
| D1 | 控制环在主循环，串口打印阻塞 8.3ms | main.c:69、cli.c:28 | 敲一条 `st` 就丢 83 个控制拍，瞬态正好撞上就是事故 |
| D2 | 卸载快斩把积分器打到 0 | ctrl.py 移植 | S4 重载跌落 5.9V；报告称“物理极限”不成立（见 §5） |
| D3 | 反馈断线无保护 | control.c | 分压开路 → 读数 0 → 占空比 0.85 → 输出 30.9V，OVP 也救不了（它看同一个坏读数） |
| D4 | `control_start` 不清 `open_loop` | control.c:67 | 上次 `d 300` 后 `off`/`on`，会以开环 300 直接启动 |
| D5 | 无负载前馈 | — | 0.5A 阶跃跌落大；1 行代码可改善一个数量级 |
| D6 | 浮点 printf 默认不链接 | cli.c | CubeIDE newlib-nano 默认不支持 `%f`，状态行会打不出电压电流；需勾 “Use float with printf” |
| D7 | 交付物不是可编译工程 | firmware/ | 没有 .project/.cproject/HAL/startup/it.c；README 的“路径 A 导入现有工程”走不通，只能从 .ioc 生成再拷源码 |
| D8 | .ioc 不完整 | boost_cccv_fw.ioc | 没有 TIM1/TIM2/PB0/PB1/ADC 扫描+DMA，CubeMX 视图里看不到 PWM；靠 bsp 强制初始化兜底 |

### 文档不一致（在报告 F5 的 4 条之外）

> **v2 状态（2026-11-03）**：E1~E5 与 F5 已全部写回《01_系统设计方案.md》（见其顶部 v2 修订记录），此项闭环。

| # | 文档写法 | 实际 |
|---|---|---|
| E1 | §7 BOM：F1 自恢复保险 2A（可选） | 板上没有 F1 |
| E2 | §7 BOM：Cin 100µF/16V | 实际 220µF/25V |
| E3 | §7 BOM：D1 SS34 | 实际 B340A（02 计划已注明，01 未改） |
| E4 | §5.9：PB5 故障恢复按键 | 板上无此按键，固件未使用 |
| E5 | §9：预留 RC 吸收焊位 | BOM/PCB 无对应焊盘 |
| E6 | §5.6：RC 滤波 fc=1.6kHz | 实际 180Hz（见 B2） |
| E7 | §5.4：图腾柱 5V 摆幅、Rds≈28mΩ | 3.3V 逻辑驱动射极跟随器，最高 2.6V，Rds≈45mΩ；且当前接法根本关不断 |
| E8 | §5.2：L1 DCR ≤80mΩ | 需核对 IHA203BA 实测 DCR，若是 0.15Ω 则效率掉约 4% |
| E9 | §5.3：Cout ESR ≤80mΩ | 所选 C9900018463 是通用 6.3×11mm 电解，100kHz 下 ESR 可能 0.15~0.3Ω；纹波会大于仿真的 2.04% |
| E10 | 03 报告 §5：S4 “✓（跌落记录在案）” | `pass_step=false`，跌落 5.9V；应写“稳态✓/阶跃✗” |

---

## 1. 审查覆盖与方法

| 对象 | 方法 | 结论 |
|---|---|---|
| 原理图 | 22 个网络、42 器件、逐脚核对 | 除 A1 外电气连接正确；D1 极性、LED 极性、U1 引脚映射全部正确 |
| PCB | Gerber 光圈表、钻孔表、板框轮廓、DFM（只读）、安装孔预演 | 5 项阻断 + 走线/布局问题 |
| 固件 | 6 个头文件 + 4 个源文件逐行 | 逻辑与报告一致；D1/D3/D4 是新增问题 |
| 仿真 | 读模型源码 + 用真实 τ 重跑 S8 | 控制结论可信，但 5 个模型盲区（§5） |
| 文档 | 四份文档交叉比对 | 10 处不一致 |

---

## 2. 阻断级详解

### A1 栅极驱动（最优先）

| 器件 | 引脚 | 实际 | 应为 |
|---|---|---|---|
| Q2 S8050 | 1 B / 2 E / 3 C | PWM_B / MID / VIN_5V | 正确 |
| Q3 S8550 | 1 B / 2 E / 3 C | PWM_B / **GND** / **MID** | B / MID / GND |

PNP 要导通必须 V_E > V_B；现在 E=0V、B=0~3.3V，永远不满足。PWM 拉低时栅极只能经 **Q3 的 B-C 结（反向当二极管）→ R8(1k) → MCU 引脚** 放电，τ≈1µs，10µs 关断窗口里只掉到 0.7V。按 Id 从 1.5A 衰减估算，单周期开关损耗 ≈10µJ，100kHz 下 ≈1W，SOT-23 十几秒越过 150°C。

**关键连带**：OVP/OCP 锁存时把 CCR 写 0 并不能关断 Q1——保护形同虚设。报告里“OCP 5.0ms 准点锁存”只在仿真成立。

**修法**：
- **A（推荐）**：交换 Q3 的 2/3 脚网络（pad2→MID，pad3→GND）。改完栅极 0.7V/2.6V，关断走 PNP 饱和（β·Ib≈260mA），沿 <100ns。
- **B（最省事）**：不贴 Q2/Q3/R8，飞线 R8.1(PWM)→R6.1(MID)。0~3.3V 直驱，非反相、无固件改动；代价是沿 ~150ns、损耗多 0.2W、驱动级只剩无源。
- 无论哪种，**“图腾柱 5V 摆幅”都要从文档里删掉**：3.3V 逻辑的射极跟随器最高只有 2.6V。

### A2 L1 与 C5/C1/R7 的 3D 冲突

- L1：`IND-TH_BD12.7-L23.4-P27.40-D0.9`，Ø12.7 圆柱、轴向卧装，轴线 y=1600，本体 x 690~1610。
- C5：6.3×11mm 立式电解，中心 (640,1780)，**11mm 高必然穿透 Ø12.7 圆柱**。
- C1（1206，0.6mm 高）：只剩约 0.4mm 间隙；R7（0603）：只剩约 0.19mm，且位于电感正下方。
- 根因：3D 模型大多已有（42/44，只有 J3/J4 未绑），但**从未做过 3D 干涉检查**；2D DRC 查不出高度冲突。

**修法**：
1. C5 改**底面装配**（直插孔位不变，零改板）——这是最快解法。
2. C1 移出 L1 端面投影 + J1 插拔走廊（见 A3），一并解决。
3. R7 移出电感正下方（同时解决磁场耦合）。
4. 补绑 J3/J4 的 3D 模型，导出 OBJ 做一次 3D 干涉检查（顶面高度 + 底面凸出 + 铜柱高度）。

### A3 端子接线通道被堵

DFM（只读）报告：
- `connector-mating-blocked`：**C1 在 J1 的 250mil 插拔走廊内**（@640,1420）
- `connector-mating-blocked`：**R1 在 J2 的走廊内**（@2380,700）

KF301 端子的导线入口朝向板内，C1/R1 正好挡在入口前约 1.6mm。螺丝能拧，线插不进去。

**修法**：把 J1/J2 旋转 180° 让开口朝板外（需重布 VIN/GND、VOUT/VLOAD 各两段），或把 C1/R1 各挪 3~5mm。推荐后者，改动小。

### A4 四角 M3 只有 2 个

`pcb mount-holes --dry-run` 权威结果：
- tr（右上）：exists
- br（右下）：exists
- **tl（左上）：skip-conflict，R118 禁布圆压到 J1**
- **bl（左下）：skip-conflict，R118 压到 C3**

**修法**：J1 右移/下移 3mm，C3 右移 3mm，再跑一次 `mount-holes`（不要用 `--clearance` 硬塞，M3 螺帽会压到元件）。

### A5 保险丝

板上没有 F1。报告 F4 说“保险丝是唯一屏障”，但屏障不存在。硬短路时 Rs1（1W 1206）要耗散 35²×0.05=61W，比电感更早失效。

**修法**：立即在 5V 输入线上串 3A 快断保险丝（插片式/5×20 管 + 座），零改板；下一版加 PTC 或保险丝座焊盘。**不要用 1206 自恢复保险丝当 35A 分断屏障**——它的分断能力远不够。

---

## 3. 严重级详解

### B1 走线宽度
- Gerber 实测：顶层 923 段 0.2032mm、260 段 0.254mm、118 段 0.2484mm；底层同理。**没有一段 ≥0.5mm**。
- 网络总长：VIN_5V 90.6mm、VOUT 51.9mm、SW 24.8mm、GND 356.9mm。
- 主功率路径约 24mm×0.2mm → 59mΩ，1.4A 时压降 83mV、损耗 116mW，温升约 40°C。
- DFM：`power-not-poured` 3V3/VOUT；`width-under-spec` GND 101 段。

**修法**：给 VIN_5V/SW/VOUT/VLOAD/GND 建 net-class，宽度 1.5~2mm，rip-up 重布；VOUT 建议直接铺铜条。

### B2 采样滤波（已用真实 τ 重跑）
真实 R_th = 36k∥10k + 1k = 8.83k，C=100nF → τ=883µs、fc=180Hz；仿真/文档用 100µs、1.6kHz，差 8.8 倍。
**v2 处置**：C10 改 10nF（τ=88.3µs、fc=1.8kHz），并按该真实值重跑全部场景（见 03 §11）。

用 τ=883µs 重跑 S8（平均模型、limiter 架构、同一网格）：

| kp_v \ ki_v | 30 | 40 | 50 | 65 | 80 |
|---|---|---|---|---|---|
| 0.04 | ✓ | ✓ | ✓ | ✓ | ✓ |
| 0.05 | ✓ | ✓ | ✓ | ✓ | ✓ |
| 0.06 | ✓ | ✓ | ✓ | ✓ | **✗** |
| 0.08 | **✗** | **✗** | **✗** | **✗** | **✗** |
| 0.12 | ✗ | ✗ | ✗ | ✗ | ✗ |

- 原报告“kp_v≤0.08”**不成立**；真实上限是 **kp_v≤0.06**。
- 推荐值 kp_v=0.06/ki_v=50 **仍然可用**，但已靠近边界（ki=80 就挂）。
- 临界点稳态误差从 30~46mV 变成约 84mV（仍 <1%）。
- 结果存档：`sim/ctrl/results/summary_s8_realRC.json`。

**修法**：C10 改 10nF（同封装，仅 BOM），fc≈1.8kHz，与仿真假设对齐；或保留 100nF 但把 kp_v 降到 0.05、ki_v 降到 40，留裕度。**推荐前者**。

### B3 C11 容性负载
100nF 直接挂在 INA180 输出，远超其推荐容性负载（一般 ≤1nF）。可能 MHz 振铃/自激。

**修法**：C11 改 1nF；若仍抖，串 100Ω。上电后用示波器看 ISENSE。

### B4 采样走线
- ISENSE 27.1mm（U3→PA5），VSENSE 27.7mm（R11→PA4）。
- DFM：两者并行 14mil × 257mil（6.5mm），3W 规则不满足。
- 25mV 满量程的电流信号走 27mm，且 C11 放在 U3 端而不是 MCU 端——滤波后的长走线是“裸”的。
- L1 是无屏蔽工字电感，就在采样走线北侧 10~15mm。

**修法**（不改板）：C11 改 1nF 并在 MCU 端再并 1nF；上电实测 CC 精度与 ISENSE 纹波，若偏差 >2% 再考虑割线加屏蔽。**改板时**：U3 贴近 Rs1（≤5mm），IN+/IN− 走紧耦合差分并包地，滤波电容放 ADC 引脚端。

### B5 功率回路与栅极回路
- SW 网络 24.8mm：L1 pad2→Q1 drain 14.2mm，→D1 8.8mm。
- GATE 21.8mm：R6 距 Q1 栅极 9.6mm，阻尼电阻不在管脚处。
- 结果：SW 振铃、EMI、栅极振铃都可能比仿真差；仿真里栅极是理想源，完全没建模。

**修法**：改板时 Q1 紧贴 L1，R6 移到 Q1 栅极 2~3mm 内；首板用示波器看 SW 与 GATE，必要时加 RC 吸收（现在没有预留焊位，见 E5）。

### B6 丝印
129 条丝印全是用属性（位号/型号/封装），**没有一条功能文字**：
- 无 5V IN / 12V OUT
- 无 CV / CC / PWR 灯含义
- 无电解电容 “+”
- 无板名/版本
- 无 SWD/UART 引脚定义

配合 C6（无防反接），输入接反就是事故。

**修法**：加丝印文字（`pcb silk-add`），至少 8 条：5V IN、12V OUT、+（C5/C6）、CV、CC、PWR、SWD、TX/RX、板名版本。

### B7 3D 检查从未做过（模型并非没有）
`pcb 3d models` 实测：44 个器件中 **42 个已绑定** 3D 模型（立创库自带），只有 J3/J4 两个排针未绑。问题是**从没打开过 3D 预览/导出**，所以 A2（L1 压 C5）、A4（J1/C3 挡安装孔）这类高度与包络冲突全部漏掉。

**修法**：补绑 J3/J4，导出 OBJ/STEP 做一次真正的 3D 干涉检查，并出一张侧视/等轴截图归档（执行计划里本来就要求）。

---

## 4. 固件整改

### 4.1 报告已列（照做）
R2 软启动改斜坡电压基准；R3 双环改 CV 调节器 + 电流限幅器；R4 卸载快斩；R5 kp_v=0.06/ki_v=50；R6 状态标志去抖。

### 4.2 新增
- **D1 控制环搬进 TIM2 中断**：现在主循环轮询 + `HAL_UART_Transmit` 20ms 超时阻塞，一条状态行 8.3ms=83 拍。中断里只做采样+PI+写 CCR，CLI 用环形缓冲/DMA。
- **D2 快斩加下限**：`integ = max(integ*0.45, 0.55*612)`，或卸载窗口结束恢复预卸载占空比；改完重跑 S4，目标跌落 <1V。
- **D3 反馈断线保护**：`duty>0.7 且 Vout<8V 连续 50 拍` → 锁存；再加启动联锁：`on` 前若 `Vout<3.5V`（应为 4.5V 直通平台）拒绝启动。
- **D4 `control_start` 复位 `open_loop=0`**（或明确保留并提示）。
- **D5 负载前馈**：`duty += 0.01*iout_counts`。
- **D6 CubeIDE 勾选 “Use float with printf from newlib-nano”**，否则 `%.2f` 打不出来。
- **D7 生成完整工程**：从 .ioc 生成 CubeIDE 工程（含 HAL/startup/it.c），把 bsp/control/cli 拷进去，编译通过后再交付；现在这棵源码树不能直接导入编译。
- **D8 补 .ioc**：把 TIM1 CH1、TIM2、PB0/PB1、ADC 扫描+DMA 配进 .ioc（即使 bsp 仍强制初始化），否则指导书/答辩时“CubeMX 配置”这一环对不上。

---

## 5. 仿真复核（哪些结论能外推）

| 结论 | 可信度 | 说明 |
|---|---|---|
| S1 开环工作点 vs 解析解 0.22%/1.55% | 高 | 模型自检通过 |
| S2 软启动过冲 67mV、浪涌 1.69A | 高 | 但栅极理想、无预充电过程 |
| S3 稳态 12.003V、纹波 2.04% | 中高 | 纹波依赖 Cout ESR；所选电容可能 >80mΩ，实测可能 2.5~3% |
| S4 卸载过冲 233mV | 高 | 快斩有效 |
| S4 重载跌落 5.9V“物理极限” | **不成立** | 图中卸载后占空比=0 持续 150ms；重载时积分器从 0 重建，属控制器行为。0.5A 阶跃物理上应只跌几十 mV |
| S5 CC −0.41% | 中 | 仿真用理想采样链；PCB 上 27mm 并行走线未建模 |
| S6 短路 35A、OCP 5ms | 高 | 但栅极关不断，实物保护失效 |
| S8 稳定域 kp≤0.08 | **不成立** | 真实 τ 下 kp=0.08 全部振荡；上限 0.06 |
| S9 无混叠 | 中高 | ADC 时序结论成立；PCB 串扰未建模，结论应改为“时序无混叠，布局需实测” |
| 效率 82~86% | 低 | 未仿真；栅极 2.6V、L1 DCR、Cout ESR 都可能比假设差 |

**五个模型盲区**：
1. 栅极按理想 0→5V 源（02 §2.2），驱动级被短路掉 → A1 不可能被发现。
2. 采样 RC 用 1k×100nF，忽略分压戴维南 7.83k → B2。
3. 功率走线宽度、封装尺寸、3D 装配不在模型里 → B1/A2/A4。
4. 闭环场景 `init_vout=4.55`，跳过上电预充电涌流（实测可能约 4A，接近 Isat）。
5. 负载是理想 CC/CR，没有电子负载的线缆电感与最小合规电压。

另外，报告 T3 的 8.7A 浪涌是**开环斜坡**的最坏情况；修复架构 S2 的浪涌是 1.69A。R7 那条“冷启动 8.7A”应改成“开环最坏 8.7A / 闭环 1.69A”。

---

## 6. 修复方案（两条路线，先选路线再动手）

### 路线 1：保留直插电感，局部重排（推荐，风险低）
1. Q3 两脚网络交换（A1）
2. C5 改底面（A2）；C1、R7 移出 L1 投影与 J1 走廊（A2/A3）；R1 移出 J2 走廊（A3）
3. J1/C3 微移，补齐 tl/bl 两个 M3 孔（A4）
4. 保险丝（A5，板外）
5. VIN/SW/VOUT/VLOAD/GND 加宽到 1.5~2mm，VOUT 铺铜（B1）
6. C10→10nF、C11→1nF（B2/B3）
7. 补丝印 8 条（B6）；补绑 J3/J4 并做 3D 干涉检查（B7）
8. DRC → Gerber + BOM + 坐标 → 下单
> 预计 3~4 小时（含重布与复检）

### 路线 2：换贴片屏蔽电感，重排功率带（更彻底）
把 L1 换成 12×12mm、100µH、Isat≥3A 的屏蔽 SMD 电感：
- 优点：A2 彻底消失，SW 回路可缩到 8mm 内，EMI 显著改善，板子空出一大片
- 风险：立创现货/价格需确认；封装与 BOM 变更；功率带要整体重排
> 预计 4~5 小时；如果买得到，长期质量更好

### 无论哪条路线，打样前必须做
- [ ] 3D 预览截图（确认 L1/C5/C1、J1/J2 插拔、M3 螺帽）
- [ ] `pcb mount-holes --dry-run` 四角全 exists
- [ ] `pcb check` 的 mating-blocked / decap-too-far / power-not-poured / width-under-spec 清零或逐条确认
- [ ] 网表回读 `Q3.2=MID, Q3.3=GND`
- [ ] Gerber + BOM + 坐标三件套齐全
- [ ] 丝印有 5V IN / 12V OUT / + / CV / CC

---

## 7. 结论一句话

**仿真证明的是“这套控制律在理想硬件上成立”；它没有、也不可能证明“这块板子能跑”。现在板级有 5 个阻断项，其中栅极驱动会让第一块板上电即过热、且让所有保护失效。先按路线 1 改完再下单，改完我逐项回读验证。**
