lcw578/STM32-project/sch_work/rebuild_review_20261105/check_as_ordered.txt

↻ easyeda daemon 已在后台启动（pid 10228，端口 60832，日志 C:\Users\33178\.easyeda-agent\daemon.log）
fetch PCB pads: --doc guard: no EasyEDA connector is available
