lcw578/STM32-project/sch_work/BOM_结构件.csv

类别 | 名称 | 规格 | 数量 | 备注
结构件 | M3 双通六角铜柱 | 黄铜镀镍 M3 母-母 15mm | 4 | C5 向板下凸 12.64mm；10mm 铜柱会顶到桌面，必须 ≥15mm
结构件 | M3 盘头十字螺丝 | M3×6mm 304 不锈钢 | 8 | 上下各 4（上：穿过 PCB 拧进铜柱；下：铜柱另一端）
结构件 | M3 平垫圈 | M3 304 不锈钢 | 8 | 可选；保护阻焊、分散螺丝压力
结构件 | 橡胶脚垫 | Ø8×2mm 背胶 | 4 | 备选：不用铜柱时四角垫高（需 ≥13mm 总高）
备选 | M3 尼龙柱 | 尼龙 M3 母-母 15mm | 4 | 绝缘替代；强度略低，适合桌面调试
