lcw578/STM32-project/sch_work/BOM_v3.csv

Comment | Designator | Footprint | LCSC | Quantity
CL31A106KBHNNNE | C1 | C1206 | C13585 | 1
CL10C220JB8NNNC | C11,C12 | C0603 | C1653 | 2
0603B103K500NT | C13 | C0603 | C57112 | 1
CL10B102KB8NNNC | C14 | C0603 | C1588 | 1
CC0603KRX7R9BB104 | C2,C3,C4 | C0603 | C14663 | 3
CL31A226KAHNNNE | C5,C6,C8,C9 | C1206 | C12891 | 4
ERA50V220M8X12 | C7,C10 | CAP-TH_BD8.0-P3.50-D0.8-FD | C49256813 | 2
SS34 | D1 | SMA_L4.3-W2.6-LS5.2-RD | C8678 | 1
0468003.NRHF | F1 | F1206 | C41342 | 1
KF301-5.0-2P | J1,J2 | CONN-TH_P5.00_KF301-5.0-2P | C474881 | 2
LAIL-PM2.54-4P-L | J3,J4 | HDR-TH_4P-P2.54-V-F | C54973823 | 2
FSA1365-101MT | L1 | IND-SMD_L13.5-W12.6_XR_XR1265 | C41384377 | 1
KT-0603R | CV,CC,POWER | LED-SMD_L1.6-W0.8-R-RD | C2286 | 3
AO3400A | Q1 | SOT-23-3_L2.9-W1.3-P1.90-LS2.4-BR | C20917 | 1
SS8050(RANGE:200-350) | Q2 | SOT-23-3_L2.9-W1.3-P1.90-LS2.4-BR | C2150 | 1
SS8550 Y2(RANGE:200-350) | Q3 | SOT-23-3_L2.9-W1.3-P1.90-LS2.4-BR | C8542 | 1
0603WAF1001T5E | R1,R4,R9,R11,R12 | R0603 | C21190 | 5
0603WAF1002T5E | R5,R8,R10 | R0603 | C25804 | 3
RC0603FR-07100KL | R13 | R0603 | C14675 | 1
0603WAF100JT5E | R2 | R0603 | C22859 | 1
0603WAF1003T5E | R3 | R0603 | C25803 | 1
0603WAF3302T5E | R6 | R0603 | C4216 | 1
0603WAF3001T5E | R7 | R0603 | C4211 | 1
1206W4F100LT5E | Rs1 | R1206 | C25334 | 1
TS-1187A-B-A-B | SW1 | SW-SMD_4P-L5.1-W5.1-P3.70-LS6.5-TL_H1.5 | C318884 | 1
STM32F103C8T6 | U1 | LQFP-48_L7.0-W7.0-P0.50-LS9.0-BL | C8734 | 1
XC6206P332MR-G | U2 | SOT-23-3_L2.9-W1.6-P1.90-LS2.8-BR | C5446 | 1
INA180A2IDBVR | U3 | SOT-23-5_L3.0-W1.7-P0.95-LS2.8-BL | C192764 | 1
X50328MSB2GI | Y1 | CRYSTAL-SMD_L5.0-W3.2 | C115962 | 1
