lcw578/STM32-project/sch_work/archive_v3/check_as_ordered.txt

PCB check (DFM): 37 track(s), 25 via(s), 151 pad(s) — 77 issue(s)
  LIMIT 14 pad(s) have captured source shapes unsupported by exact pad-contact inspection
  ERROR=0 WARN=76  |  dangling=0 acute=0 nonOrtho=0 overPad=1 clearance=0 silkFlipped=0 overlapVia=0 singleLayerVia=7 widthMismatch=0 dupSegment=0 coupling=1 antennaKeepout=0 netlessPour=0 viaCrossesPlane=0 floatingIsland=0 powerNotPoured=3 netlessViaInPad=0 widthUnderSpec=0 silkOverPad=0 silkOffBoard=56 decapTooFar=7 viaInPad=0 copperNearEdge=0 fiducialMissing=1 zoneViolation=0 zoneClaimsStale=0 internalOnEdge=0 plugClearance=1 matingBlocked=0 openingInward=0
  WARN  track-over-pad    track passes through same-net pad C6.1 instead of terminating on it [规范 §1 线宽与间距 — pcb-design-rules.md] @ (617, -722)  [VIN_5V]
  WARN  single-layer-via  signal via touches tracks on 0 layer(s) — no layer transition (pointless or dangling) [规范 §2 过孔设计 — pcb-design-rules.md] @ (1760, -755)  [VLOAD]
  WARN  single-layer-via  signal via touches tracks on 0 layer(s) — no layer transition (pointless or dangling) [规范 §2 过孔设计 — pcb-design-rules.md] @ (1364, -1274)  [$1N40]
  WARN  single-layer-via  signal via touches tracks on 0 layer(s) — no layer transition (pointless or dangling) [规范 §2 过孔设计 — pcb-design-rules.md] @ (1110, -885)  [$1N38]
  WARN  single-layer-via  signal via touches tracks on 0 layer(s) — no layer transition (pointless or dangling) [规范 §2 过孔设计 — pcb-design-rules.md] @ (1140, -910)  [$1N85]
  WARN  single-layer-via  signal via touches tracks on 0 layer(s) — no layer transition (pointless or dangling) [规范 §2 过孔设计 — pcb-design-rules.md] @ (2460, -790)  [$1N40]
  WARN  single-layer-via  signal via touches tracks on 0 layer(s) — no layer transition (pointless or dangling) [规范 §2 过孔设计 — pcb-design-rules.md] @ (2300, -860)  [$1N38]
  WARN  single-layer-via  signal via touches tracks on 0 layer(s) — no layer transition (pointless or dangling) [规范 §2 过孔设计 — pcb-design-rules.md] @ (2300, -990)  [$1N85]
  WARN  parallel-coupling parallel traces 74.8 mil apart over 113 mil (< 90.0 mil = 3×W) — crosstalk/3W risk [规范 §4.2 减少串扰 — pcb-design-rules.md]  [[$1N198 $1N3]]
  WARN  decap-too-far     decoupling cap C1 sits 528mil (13.4mm) from the nearest 3V3 pin U2.2 — a decap must hug its IC (≤100mil / 2.54mm) [规范 §3.1 去耦电容紧贴IC — pcb-design-rules.md] @ (119, -1088)  [3V3]
  WARN  decap-too-far     decoupling cap C10 sits 627mil (15.9mm) from the nearest VOUT pin U3.3 — a decap must hug its IC (≤100mil / 2.54mm) [规范 §3.1 去耦电容紧贴IC — pcb-design-rules.md] @ (2006, -320)  [VOUT]
  WARN  decap-too-far     decoupling cap C2 sits 399mil (10.1mm) from the nearest 3V3 pin U2.2 — a decap must hug its IC (≤100mil / 2.54mm) [规范 §3.1 去耦电容紧贴IC — pcb-design-rules.md] @ (248, -1054)  [3V3]
  WARN  decap-too-far     decoupling cap C3 sits 278mil (7.1mm) from the nearest 3V3 pin U2.2 — a decap must hug its IC (≤100mil / 2.54mm) [规范 §3.1 去耦电容紧贴IC — pcb-design-rules.md] @ (369, -1053)  [3V3]
  WARN  decap-too-far     decoupling cap C4 sits 159mil (4.0mm) from the nearest 3V3 pin U2.2 — a decap must hug its IC (≤100mil / 2.54mm) [规范 §3.1 去耦电容紧贴IC — pcb-design-rules.md] @ (489, -1053)  [3V3]
  WARN  decap-too-far     decoupling cap C8 sits 331mil (8.4mm) from the nearest VOUT pin U3.3 — a decap must hug its IC (≤100mil / 2.54mm) [规范 §3.1 去耦电容紧贴IC — pcb-design-rules.md] @ (2012, -685)  [VOUT]
  WARN  decap-too-far     decoupling cap C9 sits 417mil (10.6mm) from the nearest VOUT pin U3.3 — a decap must hug its IC (≤100mil / 2.54mm) [规范 §3.1 去耦电容紧贴IC — pcb-design-rules.md] @ (2012, -565)  [VOUT]
  INFO  fiducial-missing  board has 135 top-layer pads (SMT-scale) but only 0 fiducial(s) (FID*/MARK*) — SMT wants ≥3 non-collinear 1mm marks (JLC panel rails add their own; local marks needed for fine-pitch) [规范 §9 Mark点设计 — pcb-design-rules.md]  []
  WARN  connector-plug-clearance J3 ↔ J4 center distance 11.94mm (470mil) < 12.83mm required by their plug envelopes (J3 12.83mm[fallback], J4 12.83mm[fallback]) — the receptacle footprints may clear, but the plugs/overmolds will collide [plug-width=fallback — no envelope table entry, estimated from the rendered bbox] [规范 §3.5 插头护套包络 ≠ 母座本体宽 — pcb-design-rules.md] @ (475, -1455)  []
  WARN  silk-off-board    silkscreen text 'J1' extends outside the board outline (text 10..46 × -170..-125 mil, board 717..900 × -370..-275) — it will not be printed; move it with `pcb silk-set --ids 55aa1e5d2c9cbcb5e24 --x … --y …` @ (10, -170)  []
  WARN  silk-off-board    silkscreen text 'J2' extends outside the board outline (text 2465..2512 × -135..-90 mil, board 717..900 × -370..-275) — it will not be printed; move it with `pcb silk-set --ids 981c539012c3af63e24 --x … --y …` @ (2465, -135)  []
  WARN  silk-off-board    silkscreen text 'R13' extends outside the board outline (text 1475..1545 × -1405..-1360 mil, board 717..900 × -370..-275) — it will not be printed; move it with `pcb silk-set --ids 8f02bfad6a875b59e16 --x … --y …` @ (1475, -1405)  []
  WARN  silk-off-board    silkscreen text 'U1' extends outside the board outline (text 930..971 × -1060..-1015 mil, board 717..900 × -370..-275) — it will not be printed; move it with `pcb silk-set --ids 3e36bf0acad60d63e2 --x … --y …` @ (930, -1060)  []
  WARN  silk-off-board    silkscreen text 'U3' extends outside the board outline (text 1605..1657 × -815..-770 mil, board 717..900 × -370..-275) — it will not be printed; move it with `pcb silk-set --ids 7d37ff66f84b8856e24 --x … --y …` @ (1605, -815)  []
  WARN  silk-off-board    silkscreen text 'C1' extends outside the board outline (text 60..102 × -920..-875 mil, board 717..900 × -370..-275) — it will not be printed; move it with `pcb silk-set --ids c638d72002be384fe20 --x … --y …` @ (60, -920)  []
  WARN  silk-off-board    silkscreen text 'C5' extends outside the board outline (text 705..758 × -675..-630 mil, board 717..900 × -370..-275) — it will not be printed; move it with `pcb silk-set --ids aa6c6abe9403465be20 --x … --y …` @ (705, -675)  []
  WARN  silk-off-board    silkscreen text 'C8' extends outside the board outline (text 1905..1958 × -705..-660 mil, board 717..900 × -370..-275) — it will not be printed; move it with `pcb silk-set --ids 2e1b5cd66d12db13e20 --x … --y …` @ (1905, -705)  []
  WARN  silk-off-board    silkscreen text 'C2' extends outside the board outline (text 175..228 × -970..-925 mil, board 717..900 × -370..-275) — it will not be printed; move it with `pcb silk-set --ids 85ed584ce7cc2de7e18 --x … --y …` @ (175, -970)  []
  WARN  silk-off-board    silkscreen text 'C3' extends outside the board outline (text 285..338 × -980..-935 mil, board 717..900 × -370..-275) — it will not be printed; move it with `pcb silk-set --ids 33118bcaae250584e18 --x … --y …` @ (285, -980)  []
  WARN  silk-off-board    silkscreen text 'C4' extends outside the board outline (text 405..459 × -980..-935 mil, board 717..900 × -370..-275) — it will not be printed; move it with `pcb silk-set --ids 866023d2abacbec7e18 --x … --y …` @ (405, -980)  []
  WARN  silk-off-board    silkscreen text 'C13' extends outside the board outline (text 1465..1536 × -975..-930 mil, board 717..900 × -370..-275) — it will not be printed; move it with `pcb silk-set --ids d99d09b55e755060e18 --x … --y …` @ (1465, -975)  []
  WARN  silk-off-board    silkscreen text 'C14' extends outside the board outline (text 1465..1537 × -860..-815 mil, board 717..900 × -370..-275) — it will not be printed; move it with `pcb silk-set --ids 15bb345f1a4e77c8e18 --x … --y …` @ (1465, -860)  []
  WARN  silk-off-board    silkscreen text 'C11' extends outside the board outline (text 1705..1765 × -1420..-1375 mil, board 717..900 × -370..-275) — it will not be printed; move it with `pcb silk-set --ids 2149f79be541b334e18 --x … --y …` @ (1705, -1420)  []
  WARN  silk-off-board    silkscreen text 'C12' extends outside the board outline (text 1980..2051 × -1420..-1375 mil, board 717..900 × -370..-275) — it will not be printed; move it with `pcb silk-set --ids 1d7be6315c9bb5fce18 --x … --y …` @ (1980, -1420)  []
  WARN  silk-off-board    silkscreen text 'C6' extends outside the board outline (text 590..642 × -675..-630 mil, board 717..900 × -370..-275) — it will not be printed; move it with `pcb silk-set --ids 096b6c0e98e6ed25e20 --x … --y …` @ (590, -675)  []
  WARN  silk-off-board    silkscreen text 'C9' extends outside the board outline (text 1905..1957 × -590..-545 mil, board 717..900 × -370..-275) — it will not be printed; move it with `pcb silk-set --ids bfb87d356e9d59b6e20 --x … --y …` @ (1905, -590)  []
  WARN  silk-off-board    silkscreen text 'CC' extends outside the board outline (text 2370..2424 × -815..-770 mil, board 717..900 × -370..-275) — it will not be printed; move it with `pcb silk-set --ids fe7178d1d4da7fd8e3 --x … --y …` @ (2370, -815)  []
  WARN  silk-off-board    silkscreen text 'CV' extends outside the board outline (text 2370..2426 × -955..-910 mil, board 717..900 × -370..-275) — it will not be printed; move it with `pcb silk-set --ids 515e9414be6275a9e3 --x … --y …` @ (2370, -955)  []
  WARN  silk-off-board    silkscreen text 'D1' extends outside the board outline (text 1605..1646 × -205..-160 mil, board 717..900 × -370..-275) — it will not be printed; move it with `pcb silk-set --ids 8776b0c335792c00e18 --x … --y …` @ (1605, -205)  []
  WARN  silk-off-board    silkscreen text 'L1' extends outside the board outline (text 825..864 × -65..-20 mil, board 717..900 × -370..-275) — it will not be printed; move it with `pcb silk-set --ids 2178a7d0fdd70fffe14 --x … --y …` @ (825, -65)  []
  WARN  silk-off-board    silkscreen text 'POWER' extends outside the board outline (text 2325..2472 × -685..-640 mil, board 717..900 × -370..-275) — it will not be printed; move it with `pcb silk-set --ids b168503b6a5c6b68e3 --x … --y …` @ (2325, -685)  []
  WARN  silk-off-board    silkscreen text 'Q1' extends outside the board outline (text 1555..1598 × -435..-390 mil, board 717..900 × -370..-275) — it will not be printed; move it with `pcb silk-set --ids 8c09dd477234f0e0e19 --x … --y …` @ (1555, -435)  []
  WARN  silk-off-board    silkscreen text 'Q2' extends outside the board outline (text 935..989 × -650..-605 mil, board 717..900 × -370..-275) — it will not be printed; move it with `pcb silk-set --ids 78bcb06b819a330ee19 --x … --y …` @ (935, -650)  []
  WARN  silk-off-board    silkscreen text 'Q3' extends outside the board outline (text 1285..1339 × -650..-605 mil, board 717..900 × -370..-275) — it will not be printed; move it with `pcb silk-set --ids c95c9c5d077c7cd3e19 --x … --y …` @ (1285, -650)  []
  WARN  silk-off-board    silkscreen text 'R6' extends outside the board outline (text 1920..1971 × -860..-815 mil, board 717..900 × -370..-275) — it will not be printed; move it with `pcb silk-set --ids 6ee8a63bc5060f4de16 --x … --y …` @ (1920, -860)  []
  WARN  silk-off-board    silkscreen text 'R5' extends outside the board outline (text 2075..2127 × -975..-930 mil, board 717..900 × -370..-275) — it will not be printed; move it with `pcb silk-set --ids a16d60fa089591a5e16 --x … --y …` @ (2075, -975)  []
  WARN  silk-off-board    silkscreen text 'R11' extends outside the board outline (text 2562..2621 × -956..-911 mil, board 717..900 × -370..-275) — it will not be printed; move it with `pcb silk-set --ids 285201c9d0d2d1c4e16 --x … --y …` @ (2562, -956)  []
  WARN  silk-off-board    silkscreen text 'R12' extends outside the board outline (text 2562..2632 × -826..-781 mil, board 717..900 × -370..-275) — it will not be printed; move it with `pcb silk-set --ids fe734301499c7876e16 --x … --y …` @ (2562, -826)  []
  WARN  silk-off-board    silkscreen text 'R9' extends outside the board outline (text 2562..2613 × -691..-646 mil, board 717..900 × -370..-275) — it will not be printed; move it with `pcb silk-set --ids 77ab0b1dcf608ad0e16 --x … --y …` @ (2562, -691)  []
  WARN  silk-off-board    silkscreen text 'R2' extends outside the board outline (text 1462..1514 × -636..-591 mil, board 717..900 × -370..-275) — it will not be printed; move it with `pcb silk-set --ids 8fe24c7751e60513e16 --x … --y …` @ (1462, -636)  []
  WARN  silk-off-board    silkscreen text 'R3' extends outside the board outline (text 1632..1684 × -636..-591 mil, board 717..900 × -370..-275) — it will not be printed; move it with `pcb silk-set --ids 1022033c52e458eae16 --x … --y …` @ (1632, -636)  []
  WARN  silk-off-board    silkscreen text 'R1' extends outside the board outline (text 1465..1506 × -750..-705 mil, board 717..900 × -370..-275) — it will not be printed; move it with `pcb silk-set --ids 4f416b8ac406f17ce16 --x … --y …` @ (1465, -750)  []
  WARN  silk-off-board    silkscreen text 'R10' extends outside the board outline (text 2070..2140 × -1105..-1060 mil, board 717..900 × -370..-275) — it will not be printed; move it with `pcb silk-set --ids f35c66d75a217923e16 --x … --y …` @ (2070, -1105)  []
  WARN  silk-off-board    silkscreen text 'R4' extends outside the board outline (text 1920..1973 × -975..-930 mil, board 717..900 × -370..-275) — it will not be printed; move it with `pcb silk-set --ids 7ad7df115785fe8be16 --x … --y …` @ (1920, -975)  []
  WARN  silk-off-board    silkscreen text 'R8' extends outside the board outline (text 2072..2124 × -861..-816 mil, board 717..900 × -370..-275) — it will not be printed; move it with `pcb silk-set --ids b14f538b13c75b8ae16 --x … --y …` @ (2072, -861)  []
  WARN  silk-off-board    silkscreen text 'R7' extends outside the board outline (text 1919..1971 × -764..-719 mil, board 717..900 × -370..-275) — it will not be printed; move it with `pcb silk-set --ids 297a394a008a2ccbe16 --x … --y …` @ (1919, -764)  []
  WARN  silk-off-board    silkscreen text 'Rs1' extends outside the board outline (text 2175..2241 × -50..-5 mil, board 717..900 × -370..-275) — it will not be printed; move it with `pcb silk-set --ids 02a8abcf649c2bade16 --x … --y …` @ (2175, -50)  []
  WARN  silk-off-board    silkscreen text 'U2' extends outside the board outline (text 665..717 × -970..-925 mil, board 717..900 × -370..-275) — it will not be printed; move it with `pcb silk-set --ids 77555bf4104487ede2 --x … --y …` @ (665, -970)  []
  WARN  silk-off-board    silkscreen text 'Y1' extends outside the board outline (text 1710..1753 × -1200..-1155 mil, board 717..900 × -370..-275) — it will not be printed; move it with `pcb silk-set --ids d26a7f9c6594d750e24 --x … --y …` @ (1710, -1200)  []
  WARN  silk-off-board    silkscreen text 'F1' extends outside the board outline (text 428..467 × -224..-179 mil, board 717..900 × -370..-275) — it will not be printed; move it with `pcb silk-set --ids 7ac575842f1c3095e16 --x … --y …` @ (428, -224)  []
  WARN  silk-off-board    silkscreen text 'C7' extends outside the board outline (text 345..398 × -600..-555 mil, board 717..900 × -370..-275) — it will not be printed; move it with `pcb silk-set --ids 4002b506443ef0c3e15 --x … --y …` @ (345, -600)  []
  WARN  silk-off-board    silkscreen text 'C10' extends outside the board outline (text 1900..1971 × -175..-130 mil, board 717..900 × -370..-275) — it will not be printed; move it with `pcb silk-set --ids 61019e545a948b4ae15 --x … --y …` @ (1900, -175)  []
  WARN  silk-off-board    silkscreen text '5V' extends outside the board outline (text 70..208 × -160..-40 mil, board 717..900 × -370..-275) — it will not be printed; move it with `pcb silk-set --ids e8c76199a27a4b15 --x … --y …` @ (70, -160)  []
  WARN  silk-off-board    silkscreen text 'GND' extends outside the board outline (text 20..228 × -735..-615 mil, board 717..900 × -370..-275) — it will not be printed; move it with `pcb silk-set --ids 98f74cade0b2d4a0 --x … --y …` @ (20, -735)  []
  WARN  silk-off-board    silkscreen text 'GND' extends outside the board outline (text 2525..2733 × -133..-13 mil, board 717..900 × -370..-275) — it will not be printed; move it with `pcb silk-set --ids 53cb607b08ea9398 --x … --y …` @ (2525, -133)  []
  WARN  silk-off-board    silkscreen text '12V' extends outside the board outline (text 2555..2735 × -665..-545 mil, board 717..900 × -370..-275) — it will not be printed; move it with `pcb silk-set --ids 71b39a0563afcc29 --x … --y …` @ (2555, -665)  []
  WARN  silk-off-board    silkscreen text 'TX' extends outside the board outline (text 55..124 × -1395..-1335 mil, board 717..900 × -370..-275) — it will not be printed; move it with `pcb silk-set --ids 98eb3288fc5c2485 --x … --y …` @ (55, -1395)  []
  WARN  silk-off-board    silkscreen text 'RX' extends outside the board outline (text 160..229 × -1395..-1335 mil, board 717..900 × -370..-275) — it will not be printed; move it with `pcb silk-set --ids 8e5941732e640471 --x … --y …` @ (160, -1395)  []
  WARN  silk-off-board    silkscreen text '3V3' extends outside the board outline (text 240..351 × -1394..-1334 mil, board 717..900 × -370..-275) — it will not be printed; move it with `pcb silk-set --ids bc021e04e8056608 --x … --y …` @ (240, -1394)  []
  WARN  silk-off-board    silkscreen text '3V3' extends outside the board outline (text 503..615 × -1398..-1338 mil, board 717..900 × -370..-275) — it will not be printed; move it with `pcb silk-set --ids 5ba601041873c59c --x … --y …` @ (503, -1398)  []
  WARN  silk-off-board    silkscreen text 'GND' extends outside the board outline (text 365..475 × -1395..-1335 mil, board 717..900 × -370..-275) — it will not be printed; move it with `pcb silk-set --ids c2c2a1c8dc631c5d --x … --y …` @ (365, -1395)  []
  WARN  silk-off-board    silkscreen text 'GND' extends outside the board outline (text 845..955 × -1395..-1335 mil, board 717..900 × -370..-275) — it will not be printed; move it with `pcb silk-set --ids e38dcb10936a92c5 --x … --y …` @ (845, -1395)  []
  WARN  silk-off-board    silkscreen text 'DIO' extends outside the board outline (text 625..713 × -1395..-1335 mil, board 717..900 × -370..-275) — it will not be printed; move it with `pcb silk-set --ids 022402252013a735 --x … --y …` @ (625, -1395)  []
  WARN  silk-off-board    silkscreen text 'CLK' extends outside the board outline (text 730..836 × -1395..-1335 mil, board 717..900 × -370..-275) — it will not be printed; move it with `pcb silk-set --ids 46d3b3221414d7d5 --x … --y …` @ (730, -1395)  []
  WARN  silk-off-board    silkscreen text 'RESET' extends outside the board outline (text 2430..2612 × -1435..-1375 mil, board 717..900 × -370..-275) — it will not be printed; move it with `pcb silk-set --ids 78f76822ff699a4a --x … --y …` @ (2430, -1435)  []
  WARN  power-not-poured  power net 3V3 (14 pads) has no copper pour/plane — power should be poured, not carried by thin tracks: `pcb pour-fit --net 3V3` (2-layer) or `pcb power-planes` (4-layer) [规范 §5.2 铺铜策略 — pcb-design-rules.md]  [3V3]
  WARN  power-not-poured  power net GND (34 pads) has no copper pour/plane — power should be poured, not carried by thin tracks: `pcb pour-fit --net GND` (2-layer) or `pcb power-planes` (4-layer) [规范 §5.2 铺铜策略 — pcb-design-rules.md]  [GND]
  WARN  power-not-poured  power net VOUT (8 pads) has no copper pour/plane — power should be poured, not carried by thin tracks: `pcb pour-fit --net VOUT` (2-layer) or `pcb power-planes` (4-layer) [规范 §5.2 铺铜策略 — pcb-design-rules.md]  [VOUT]
