lcw578/STM32-project/sch_work/rebuild_review_20261105/仿真复核与定值结论.md

# F1/Rs1 定值结论 + 重建版仿真复核报告

> 日期：2026-11-05 ｜ 结论：**Rs1=0.1Ω 可用（固件 6 个常数已同步改）；F1=0Ω 不行（必须恢复保险丝）；输出必须补 1 颗 220µF 电解/固态**
> 仿真：`sim/ctrl/`（镜像常数已同步重建版口径，`results/summary_rebuild_final.json` 为正式基线）

---

## 一、直接回答

### Rs1 = 0.1Ω（C25334）—— ✅ 可以用，但有配套条件

0.1Ω 比 0.05Ω 的 ADC 信噪比**更好**（0.5A → 2.5V，用满量程 76%），功耗 25mW（250mW 额定）完全没问题。**但电流采样链是"硬件×固件"一套常数，换 0.1Ω 后固件必须同步**——已在本次一并改完：

| 常数 | 位置 | 旧值（0.05Ω 口径） | 新值（0.1Ω 口径） | 说明 |
|---|---|---|---|---|
| ADC_IOUT_GAIN | bsp_power.h | 0.00032234 | **0.00016117** | ÷2 |
| ADC_IOUT_DIV | bsp_power.h | 3102.3 | **6204.5** | ×2 |
| ISET_DEFAULT_COUNTS | bsp_power.h | 1551 | **3102** | 0.5A 给定 |
| OCP_HARD_COUNTS | bsp_power.h | 2482 (0.8A) | **3723 (0.6A)** | ⚠️ 见下 |
| OCP_SOFT_COUNTS | bsp_power.h | 2172 (0.7A) | **3412 (0.55A)** | 存档 |
| UNLOAD_DROP_COUNTS | control.c | 400 | **800** | 卸载检测阈值 |
| LOAD_FF | control.c | 0.26 | **0.13** | counts 口径减半，物理前馈不变 |
| LOAD_FF_THRESHOLD | control.c | 100（+100 门控） | **200（+200）** | ≈0.032A 不变 |

**⚠️ OCP 必须 0.8A→0.6A 的原因**：0.1Ω×G50=5V/A，0.8A 时 INA180 输出 4.0V **超过 3.3V ADC 满量程**（上限 0.66A）——0.8A 整定在 0.1Ω 下永远不会触发。0.6A=1.2 倍额定，仍是有效保护（S6 短路 5ms 锁存验证通过）。

**反证（不改固件的后果，仿真实测）**：正常 12V/0.5A 工作点，控制器把 0.1Ω 采样读成 2 倍电流（认为 1.0A>0.5A 限流），限幅器压占空比，**输出塌到 4.91V 无法工作**（`summary_rebuild_rs100_cer55.json` D 项）。

**备选**：0.05Ω 采样电阻同样是基础库白菜价（几分钱），若想固件零改动、OCP 保持 0.8A，换回 0.05Ω 也完全合理——两个方案都成立，**当前按"保持 0.1Ω + 改固件"落地**。

### F1 = 0Ω（C17888）—— ❌ 不行，必须恢复保险丝

0Ω 电阻是跳线，**没有任何过流保护能力**。04 审计 A5 的结论原样回归：硬短路时输入唯一屏障消失，Rs1 短路功耗 61W 起火风险。图上"短路保护作用"的注释名不副实，答辩时对不上 04 号文档。

平替思路没问题，但"平替"平的是品牌/封装，不能平掉功能。查证结果：**嘉立创 SMT 基础库里没有保险丝**（全部在扩展库），选项：

| 方案 | 器件 | 成本 | 说明 |
|---|---|---|---|
| **推荐：C41342** | Littelfuse 0468003.NRHF，1206 一次性 3A/32V | ¥0.56（1 件价） | v2 基线同款；手工焊扩展库无影响；走 SMT 只多一颗扩展料费 |
| 备选：1206 PPTC 3A | 如 1206L300 系列（6V 耐压足够 5V 输入） | ~¥0.3 | 可自恢复，但动作慢（秒级），一次性 3A 更快 |
| 底线：保留 0Ω | — | — | 仅当"实验室电源限流作为唯一保护"如实写进报告，注释改成"跳线/测试点"，答辩有被问风险 |

工作电流约 1.4A（6W/5V÷87%），3A 整定合理（≈2 倍裕度）。

### 输出电容（顺带的硬结论）—— 必须补 1 颗 220µF 电解/固态

全陶瓷 5×22µF（偏压后 ≈55µF）不行的原因见下表；**在 C6/C18~C21 基础上并 1 颗 220µF/25V 电解（ESR≤80mΩ，SMD 或直插均可，¥0.3~1）即可全部恢复 v2 性能**。

### 附：基础库平替查证结论（2026-11-05 六轮检索 + 官方类目页核对）

| 器件 | 基础库有无平替 | 证据 |
|---|---|---|
| 保险丝 | **无** | 嘉立创 SMT 官方类目"TVS/保险丝/板级保护"共 59550 件，库类型筛选面板**只有"扩展库"一个选项**，抽样（C70065/C3131/C3105/C269104/C46641026 等）全部标"扩展库" |
| 220µF 级电解 | **未发现基础库料** | C9900018463（吉光 220µF/25V 直插）= 扩展库；抽查松下 C542483、科尼盛 C4747958、丰宾 FZ 系列、KEMET/Honor 贴片电解均为扩展库；基础库电容以 MLCC 为主，铝电解基本不覆盖 |

**关键提醒：库别只影响"嘉立创代贴"的每料上料费。** 本项目 5 片板：
- F1（1206）如果自己焊——买散料按原价 ¥0.56/颗，扩展库不产生任何费用；
- C22 电解（直插 BD6.3）是插件件，本来就不上贴片机（自己焊或插件费另算），库别无关；
- 只有整板交嘉立创 SMT 一站式时，这两颗扩展料才各多几元上料费——为省这点钱用 0Ω 替保险丝、砍掉电解，损失的是输入保护和负载瞬态（仿真已证），不划算。
- 若坚持"零扩展料"：唯一出路是把 C22 换成陶瓷再并联加量（如 22µF×10），但低 ESR 高 Q 的阻尼问题需要重新仿真验证，且 F1 仍无解——不推荐。

---

## 二、仿真结果对照（switch 模型，负载 24Ω/0.5A 临界点）

| 场景 | v2 基线（220µF+10µF，0.05Ω） | 全陶瓷 55µF（固件已同步） | **混合 +1×220µF（最终方案）** | 课程指标 |
|---|---|---|---|---|
| S2 软启动过冲 | 38mV | 150mV（无 OVP） | **64mV，无 OVP ✓** | 无过冲 |
| S3 稳态误差 | +0.073% | -0.45% | **+0.076% ✓** | ±5% |
| S3 纹波 | 155mV（1.3%） | 379~488mV（3.2~4.1%） | **166mV（1.38%）✓** | ≤5% |
| S4 卸载过冲(0.5A→0) | 306mV | 830~1325mV，**C45 时触发 OVP 锁存** | **242mV，无故障 ✓** | — |
| S4 加载跌落(0→0.5A) | 1187mV / 6.5ms | **7984~8009mV / 200ms** | **1109mV / 6.7ms ✓** | 无指标 |
| S5 恒流精度 | -0.33% | -0.17% | **-0.18% ✓** | ±5% |
| S6 短路 OCP | 5ms 锁存 | 5ms 锁存（0.6A） | **5ms 锁存 ✓** | 有保护 |
| S7 OVP 锁存 | 通过 | 通过 | **通过 ✓** | 有保护 |
| S10 输入跌落 4.75V | 18.8mV | 33mV | **19.1mV ✓** | ±5% |
| S8 稳定域（平均模型网格） | kp≤0.06/ki≤65 全过 | kp≤0.06/ki≤40 全过 | **kp≤0.08/ki≤65 全过** | — |

全陶瓷失败的根因链（`summary_rebuild_rs100_cer55.json` / `summary_ff_rescale.json`）：
1. 输出储能 ÷4 → 卸载泵升/加载跌落全部放大；
2. Ceff≤66µF 时卸载过冲 1.33V 触发 OVP（13.2V）锁存——**需要重新上电的功能性失效**；
3. 另发现 **LOAD_FF 是 counts 口径系数**：电流链增益×2 后前馈注入跟着×2（807 counts），把环路打进限幅（跌落 8V 的主因之一）——固件已改 0.13。

最终基线：`results/summary_rebuild_final.json`（镜像常数同步后的干净复跑，全部场景通过）。

---

## 三、本次已改动的文件

| 文件 | 改动 |
|---|---|
| `firmware/Core/Inc/bsp_power.h` | 电流链 4 常数（GAIN/DIV/ISET/OCP_HARD/OCP_SOFT）按 0.1Ω 口径更新，注释写明 0.66A 量程上限 |
| `firmware/Core/Src/control.c` | UNLOAD_DROP 800、LOAD_FF 0.13、THRESHOLD 200（含门控 +200） |
| `sim/ctrl/plant_boost.py` | 镜像同步：INA_GAIN=5.0、RC_TAU=88.3µs 默认、DCR=0.17、cout_cer=55µF（混合口径） |
| `sim/ctrl/ctrl.py` | 镜像同步：ADC_IOUT_*、OCP、ISET、UNLOAD_DROP、load_ff_threshold=200、门控 +200 |
| `sim/ctrl/scenarios.py` | fixed_cfg load_ff 0.26→0.13 |
| `sim/ctrl/run_rebuild_check.py` 等三个脚本 | 复核脚本（含反证场景），结果 JSON 在 `results/` |

**未改动**：原理图/PCB（等你确认后自己动或让我动）；03/05/06 文档数字（待 PCB 定稿后一次性同步，避免反复改）。

## 四、留给你的动作清单

1. **F1 换 C41342**（或任选 1206 3A 保险丝），注释改回"输入过流保护"；
2. **输出并 1 颗 220µF/25V 电解或固态**（位置放 J2/VOUT 附近，PCB 上加位号 C22）；
3. Rs1 保持 C25334 不动（固件已配套）；
4. PCB 布线时注意 INA180→Rs1 开尔文接法（04 审计 B 类遗留）；
5. 固件重新编译烧录后，串口 `h` 自检——电压/电流读数应与万用表一致（0.1Ω 口径）；
6. 03/05/06 与 README 的数字（OCP 0.8A→0.6A、纹波 1.38%、过冲 64mV、恒流 -0.18% 等）等 PCB 定稿后一次性更新。
