lcw578/STM32-project/sch_work/rebuild_review_20261105/审查报告.md

# 重建版原理图 + PCB 审查报告（只读审查）

> 日期：2026-11-05 18:00~18:30 ｜ 对象：嘉立创 EDA 工程 `boost-cccv-psu`（重建版，图签 V1.0 / 2026-11-05）
> 工具：easyeda-agent v1.16.0（daemon + connector 现场只读）｜ 基线：v2 定稿（2026-11-03，05 号文档）
> **未做任何改动。** 全部证据存于本目录。

---

## 一、总评

**原理图：电气拓扑正确、画得比 v2 干净，但 F1 被换成了 0Ω 电阻、Rs1 与固件不符、6 个关键网络丢了名字、27 个脚悬空无 NC。**
**PCB：只完成了器件布局和约 5% 的布线——板框不存在、0 铺铜、飞线 429mm 未布通，离可打样状态还很远。**

| 维度 | 结论 |
|---|---|
| 原理图拓扑 | ✅ 29/29 网络与 PCB 完全一致，同步无丢网；官方 DRC 0 违规 |
| 关键器件参数 | ❌ 2 处硬伤（F1=0Ω、Rs1=0.1Ω vs 固件 0.05Ω） |
| 网表质量 | ⚠️ 27 悬空脚（无 NC）、23 根零长度线、6+ 网名丢失 |
| PCB 布局 | ✅ 50 器件无重叠/出界/短路 |
| PCB 布线 | ❌ 36 段线 + 25 过孔（7 个死过孔）、0 铺铜、飞线 16896mil |
| PCB 板框 | ❌ **不存在**（只有一个 4.7×2.4mm 的小闭合线，70×39"板子"是器件包围盒） |
| 可打样 | ❌ 不可（无板框、未布通、无安装孔） |

---

## 二、阻塞项（不修不能打样/上电）

### A1. PCB 板框不存在 ＋ 无安装孔 【最高优先级】
- `outline-get` 权威回读：板框对象 = 1 条 polyline、4 段、中心线包围盒 **183.8×95mil（4.7×2.4mm）**，点集 (716.7,−275)→(900.5,−275)，这不是板框。
- 器件占据 x[119,2630] y[−1445,−95] mil（≈70×39mm），但没有真正的板框线；`pcb check` 因此把板框判成 4.6×3.4mm，产生 60 条"丝印出板"警告（其中多数是失真判定）。
- v2 的 4×M3 角落安装孔在重建版中**不存在**（无 H*/M* 器件）。
- **修法**：重画 70×50mm 圆角板框（锁定），补 4×M3 安装孔；随后重跑 `pcb check` 让丝印/边缘判定恢复真实。

### A2. PCB 布线远未完成
- 全板 36 段走线 + 25 过孔（其中 **7 个是无层转换的死过孔**：VLOAD×1、$1N38/$1N40/$1N85 各 2——过孔放了但线没接上）；**0 铺铜、0 填充、0 禁布区**。
- layout-lint：**40/100 分，飞线总长 16896mil（429mm），15 处飞线交叉**。
- 官方 DRC passed=0 违规只代表"已画的铜互不打架"，不代表布通。
- v2 基线：358 轨道 + 27 过孔 + 双面 GND 铺铜 + DRC 0。
- **修法**：按 v2 工艺顺序继续——先建 POWER 网络类（见 B4）→ 功率网加宽 → 布通 → 双面 GND 铺铜 → pour-rebuild → DRC。

### A3. Rs1 = 0.1Ω，与固件电流标定不符 【功能级硬伤】
- 重建：Rs1 = 1206W4F100LT5E = **100mΩ ±1%**（1206）。
- 固件 `bsp_power.h:21`：`ADC_IOUT_GAIN 0.00032234 = 3.3/4095/(0.05×50)` —— 按 **0.05Ω** 标定。
- 后果：固件读数 = 实际电流 ×2。CC 环路会在 **0.25A** 提前进入恒流，OCP/卸载判断（UNLOAD_DROP_COUNTS 阈值 0.129A 实际对应 0.065A）全部偏移一半。
- 04 审计文档确认设计意图 Rs=0.05Ω。
- **修法（二选一）**：① Rs1 换 0.05Ω 1206（基线料 C601088）；② 保留 0.1Ω（ADC 幅度 2.5V@0.5A，信噪比其实更好）并改固件 `ADC_IOUT_GAIN=0.00016117f / ADC_IOUT_DIV=6204.7f`。**改固件则 06 号文档与仿真 ISENSE 链同步更新。**

### A4. F1 = 0Ω 电阻，保险丝保护消失
- 重建：F1 = 1206W4F0000T5E = **0Ω 跳线**；原理图上还标注"实施短路保护作用"——意图与实装矛盾。
- 04 审计 A5 的核心整改（输入唯一屏障）被回退：硬短路时 Rs1 耗散 35²×0.05=61W 先于任何东西失效。
- **修法**：F1 换回保险丝（05 文档曾用 C99555 3A/32V，或基线 BOM C41342 1206 自恢复），保持位号与网络（VIN_RAW→VIN_5V）不变。

---

## 三、高优先级（影响指标可信度）

### B1. 输出电容方案与仿真口径脱节
- 仿真 `plant_boost.py`：Cout=220µF 电解(ESR 0.08Ω)+10µF 陶瓷；重建 VOUT = C6+C18~C21 = **5×22µF 陶瓷**（CL31A226KAHNNNE，1206 X5R 25V）。
- 12V 偏压下 22µF X5R 实效约 11~13µF → 输出实际 ~55~65µF，ESR mΩ 级。
- 影响：S4 负载阶跃跌落 1187mV 的结论作废；LC 谐振 ~1.05kHz→~2.1kHz，陶瓷低 ESR 高 Q，**kp_v=0.06/ki_v=50 是否仍在稳定域需复跑**；稳态纹波大概率变好。
- 输入侧 5×22µF 陶瓷（C5+C14~C17）对实验室 5V 电源足够。
- **修法**：用新参数（cout≈60e-6、esr≈0.005、dcr=0.17、τ=88.3µs）复跑 S1~S8/S10，通过后更新 03§11/05/06 数字；报告口径改为"全陶瓷输出"。

### B2. 6+ 个网络丢失网名（$1N 自动名）
- $1N14=GATE、$1N198=MID、$1N3=图腾柱基极(原 PWM_B)、$1N286=NRST、$1N21=BOOT0、$1N168/$1N193=OSC_IN/OUT、$1N278=分压中点(原 VMID)、$1N289=R13-R1 节点。
- 电气正确（已随同步进入 PCB），但原理图/PCB 可读性、与 01/06 文档的对账口径退化。
- **修法**：给这些网络的旗子补网名（或把直连线改成命名旗），同步 `pcb import-changes`。

### B3. 27 个悬空脚无 NC 标记 + 23 根零长度线
- 悬空：U1.3/4/10-13/16-17/20-22/25-28/32-33/38-43/45-46（未用 GPIO，含 PB2/BOOT1）+ SW1.2/SW1.4。v2 有 28 个 NC。
- `sch check` passed=**False**，唯一 ERROR 类是 23 根零长度导线（遗留杂线）。
- **修法**：未用脚补 NC 旗（重点 PB2）；删除 23 根零长度线后重跑 check 至 passed=True。

### B4. POWER 网络类（功率线宽规则）未重建
- `net-class list`：**count=0**，GND/VIN_5V/VOUT 等全部 "Track: default"（10mil）。
- v2 建了 POWER 类 40/30/20mil 并重布功率网（Gerber 实测 1.016/0.762/0.585mm 主干）。
- **修法**：布线前重建网络类并绑定 VIN_RAW/VIN_5V/SW/VOUT/VLOAD，否则功率网会按 10mil 布出去。

---

## 四、中低优先级 / 记录在案

| # | 事项 | 详情 | 建议 |
|---|---|---|---|
| C1 | 器件库大面积换型 | 23 个 C 号与 BOM_v2 不同（Q2/Q3/D1/F1/Y1/SW1/U2/R 系列/C 系列），新增 C14~C21、R13；C1/C2/C3 消失；LED 位号改为 POWER/CV/CC | BOM_v2.csv 与 placement_v2_final.csv 作废，完成后重新导出；LED 位号建议改回 LED1~3 |
| C2 | U2 换 XC6206P332MR | 3.3V/200mA，Vin max 6V。负载 <60mA OK；5.25V 输入距 6V 上限裕度 0.75V | 可接受；注意 3.3V 只能由 5V 口馈电 |
| C3 | Y1 换 SMD 晶振（CL=20pF） | C12/C13=22pF → 等效 CL≈14pF，晶振跑快几十 ppm | UART 无影响；如后续用 USB/RTC 需改 ~33pF |
| C4 | J3↔J4 中心距 11.94mm < 12.91mm | v2 已知取舍（两杜邦头不能同时插） | 维持，报告里写明 |
| C5 | decap-too-far ×9 | C4/C7/C8/C9 距 U2 4~13.4mm；C18~C21 距 U3.3 7~18.7mm（bulk 性质可放宽） | 3V3 去耦拉近；VOUT bulk 集中布置可接受 |
| C6 | 丝印压焊盘 ×2 | R13 压 C6.1、U2 压 U2.1 | 布线完成后 `pcb silk-align` 一并处理 |
| C7 | MID 与基极网平行 74.8mil/113mil | 图腾柱两条敏感网耦合 | 布线时拉开或包地 |
| C8 | track-over-pad ×3 | VIN_5V 主干从 C14/C15/C16.1 焊盘穿过 | 改为终止于焊盘 |
| C9 | 无 Mark 点 | v2 已知 | 嘉立创拼板自带 |
| C10 | 图签版本 V1.0 | 与文档 v2/v3 谱系脱节 | 建议版本号对齐 |

---

## 五、重建版比 v2 变好的方面

1. **原理图分区清晰**：接口/功率级/采样/MCU/指示分区明确，带中文功能注释，正交走线基本无交叉——v2 的 14 处旗重叠、5 个反挂旗、旗子堆叠问题全部消失。
2. **图签已填**（Schematic1/Board1/course design Team/boost-cccv-psu/V1.0/A4）。
3. **电压采样链与固件精确自洽**：R13(3k)+R1(33k)+R2(10k) 的戴维南电阻 = 1k+(36k‖10k) = **8.83kΩ**，τ=88.3µs 与固件/仿真一致；分压比 10/46 与 `ADC_VOUT_GAIN`（注释 ×3.3/4095/(10/46)）完全吻合。**电压链是对的，只有电流链（Rs1）不匹配。**
4. Q1 恢复 AO3400A，与仿真/固件假设一致。
5. 官方原理图 DRC 0 违规；原理图↔PCB 网表 29/29 一致，同步机制工作正常。
6. C5 从底面电解改为 1206 陶瓷后，v2 的"底面凸出 12.64mm 需 15mm 铜柱"约束消失（结构件 BOM 可简化为普通铜柱/垫）。

---

## 六、下一步（建议顺序）

1. 原理图收尾：F1 换保险丝、Rs1 定值（与固件二选一对齐）、补 NC 旗、清零长度线、补 6+ 网名 → check passed=True → save。
2. 固件/仿真对齐：按 Rs1 与输出电容的最终选择复跑 S1~S8/S10，更新 03/05/06。
3. PCB：画 70×50 板框+4×M3 → 建 POWER 网络类 → 功率网加宽布线 → 全网布通 → 双面 GND 铺铜 → pour-rebuild → DRC + check → silk-align → 导出 Gerber/BOM/坐标（全部替换 v2 文件）。

---

## 附：证据清单（本目录）

| 文件 | 内容 |
|---|---|
| sch_read.json | 原理图全量快照（器件 107 图元/50 器件、29 网、27 悬空、check 23 零长线） |
| sch_list.json | 器件属性（值/厂家/封装/数据手册链接） |
| sch_drc / bridge.txt | 官方 DRC 0 违规；bridge-check 22 孤儿旗、0 短路 |
| sch_P1.png | 原理图整页导出（目视复核用） |
| pcb_dump.json | PCB 全量快照（50 器件、36 线、25 过孔、0 铺铜、板框异常） |
| drc.json / check.json / lint.json | PCB DRC 0 违规；DFM 87 项（86 WARN）；layout-lint 40/100 |
| pcb_render.svg | PCB 离线渲染 |
| dump_meta.json / snap_out.txt | 过程元数据 |
