lcw578/STM32-project/sch_work/rebuild_review_20261105/sch_P1.png

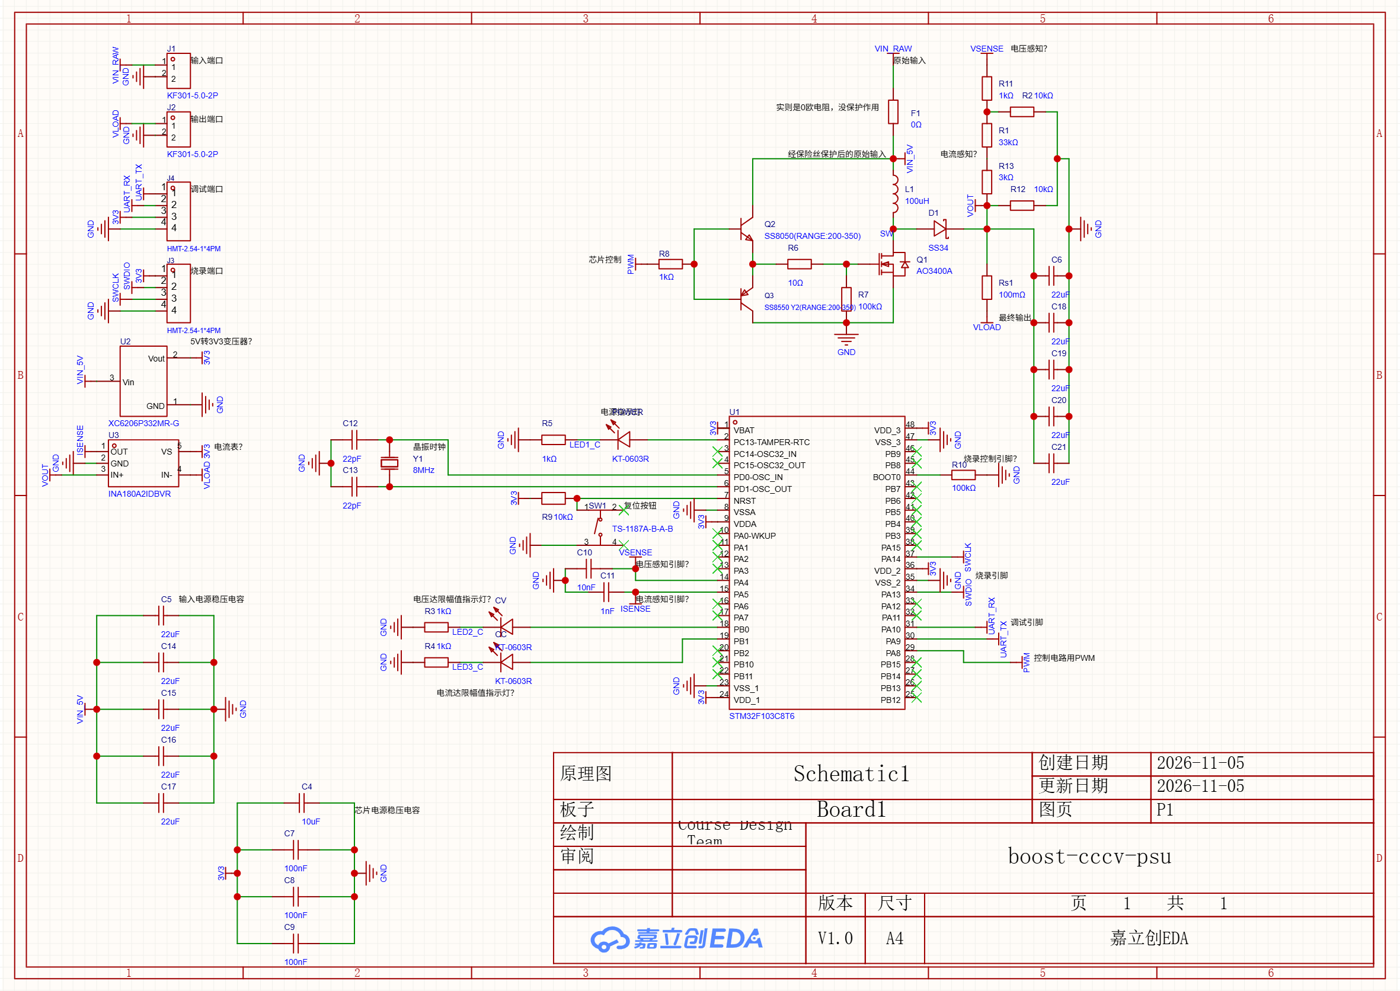
sch_work/rebuild_review_20261105/sch_P1.png
