lcw578/STM32-project/sim/ctrl/results/S4_load_step.png

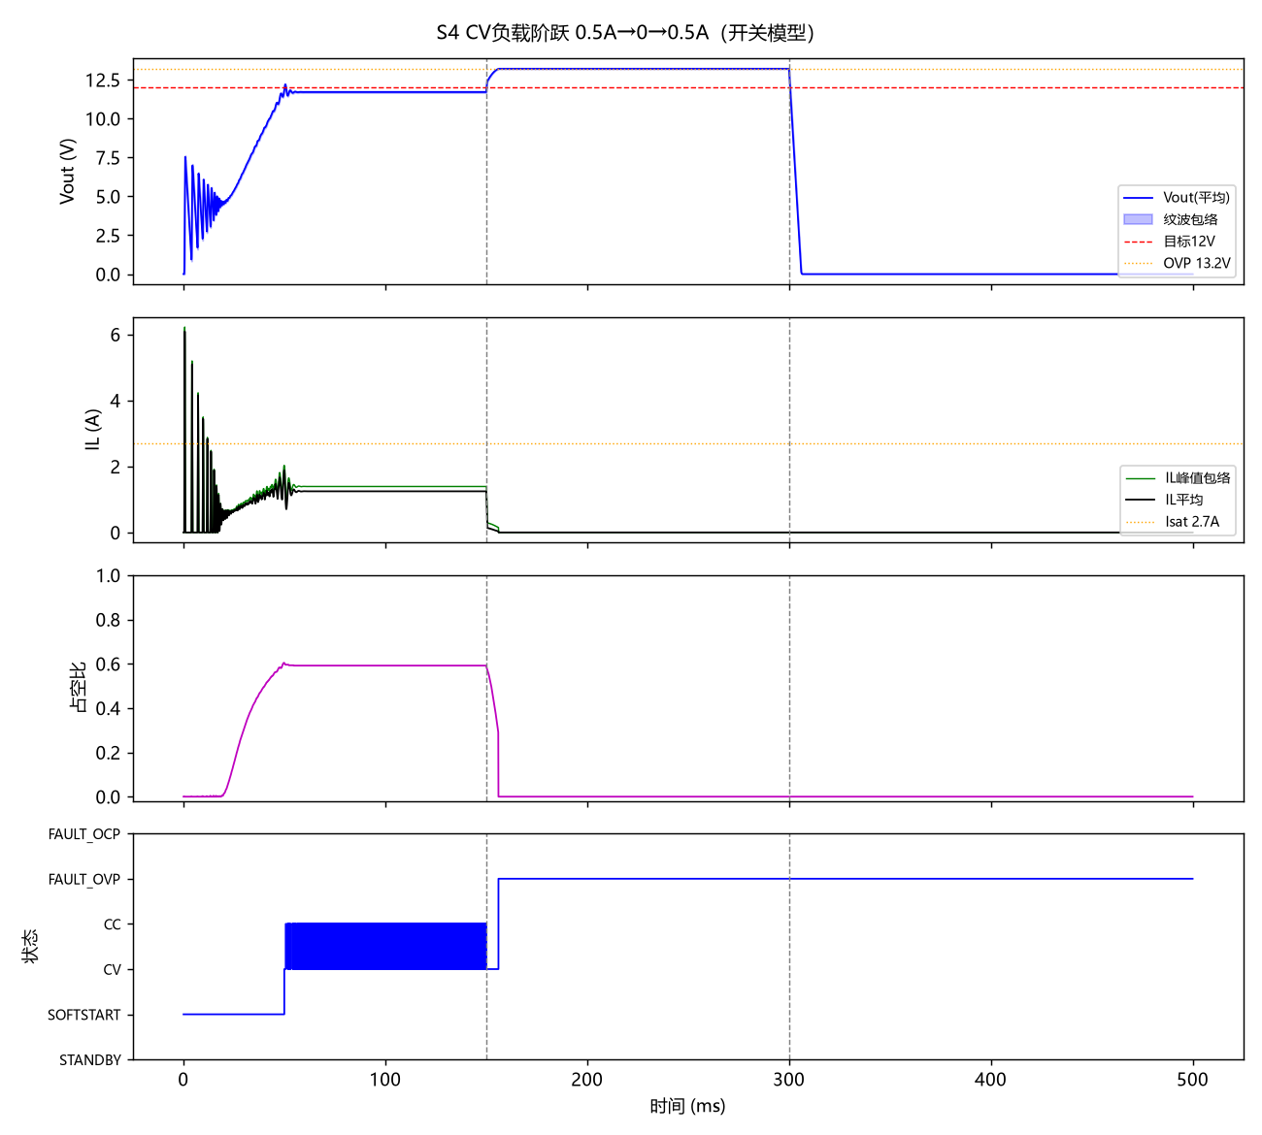
sim/ctrl/results/S4_load_step.png
