lcw578/STM32-project/sim/ctrl/results/S2_firmware_asis.png

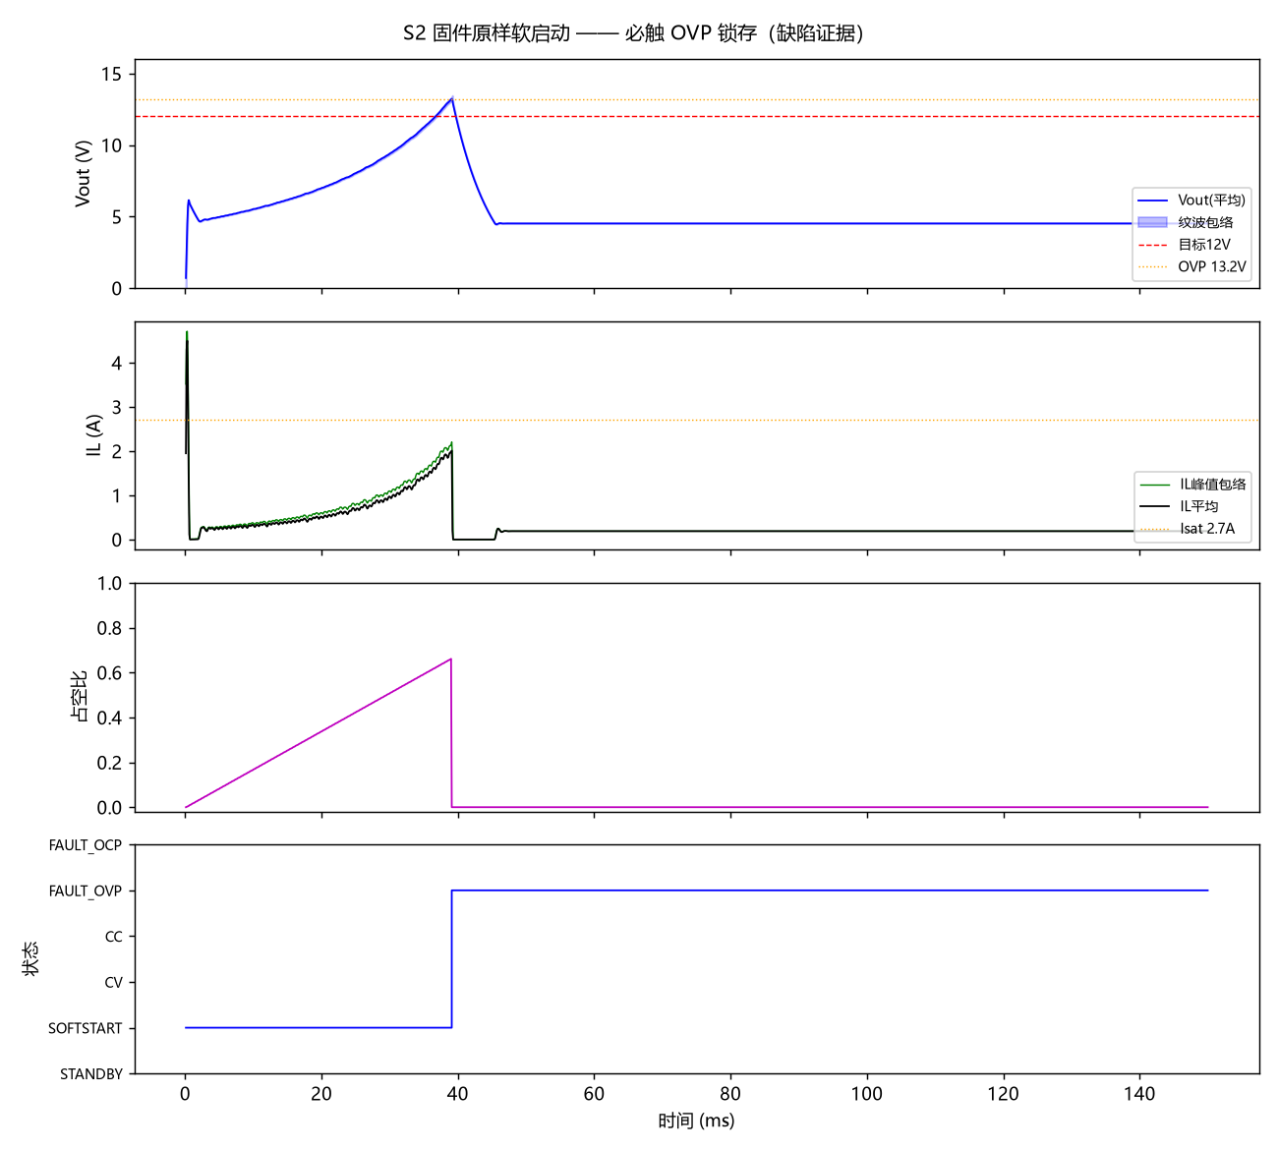
sim/ctrl/results/S2_firmware_asis.png
