lcw578/STM32-project/sim/ctrl/results/S2_S3_fixed.png

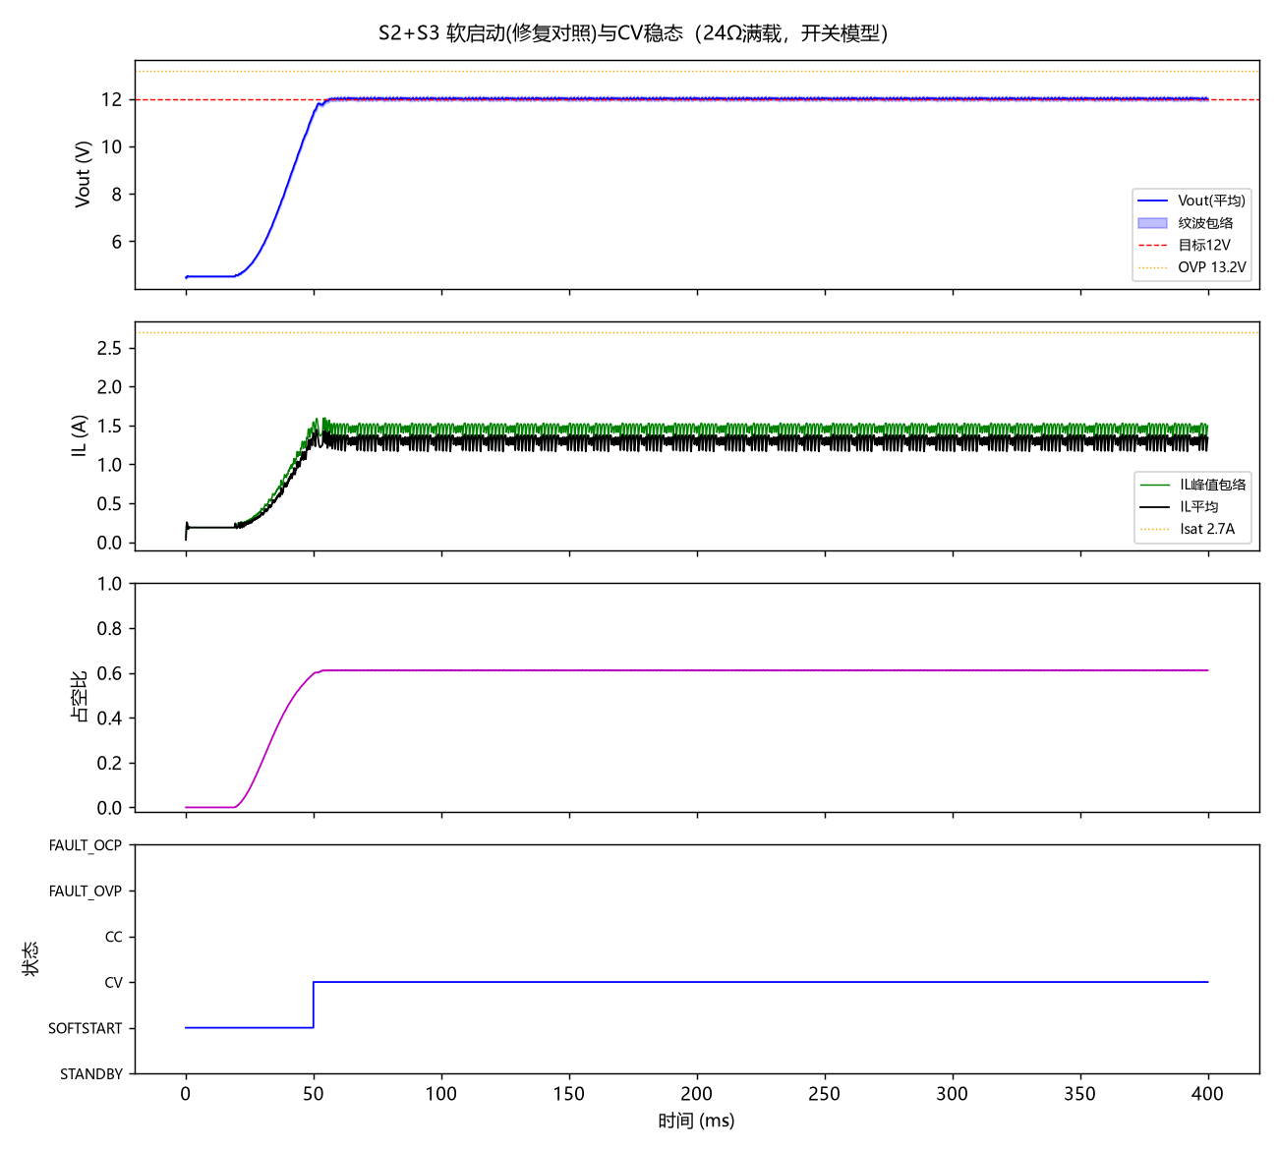
sim/ctrl/results/S2_S3_fixed.png
