lcw578/STM32-project/sim/ctrl/results/S2_S3_softstart_steady.png

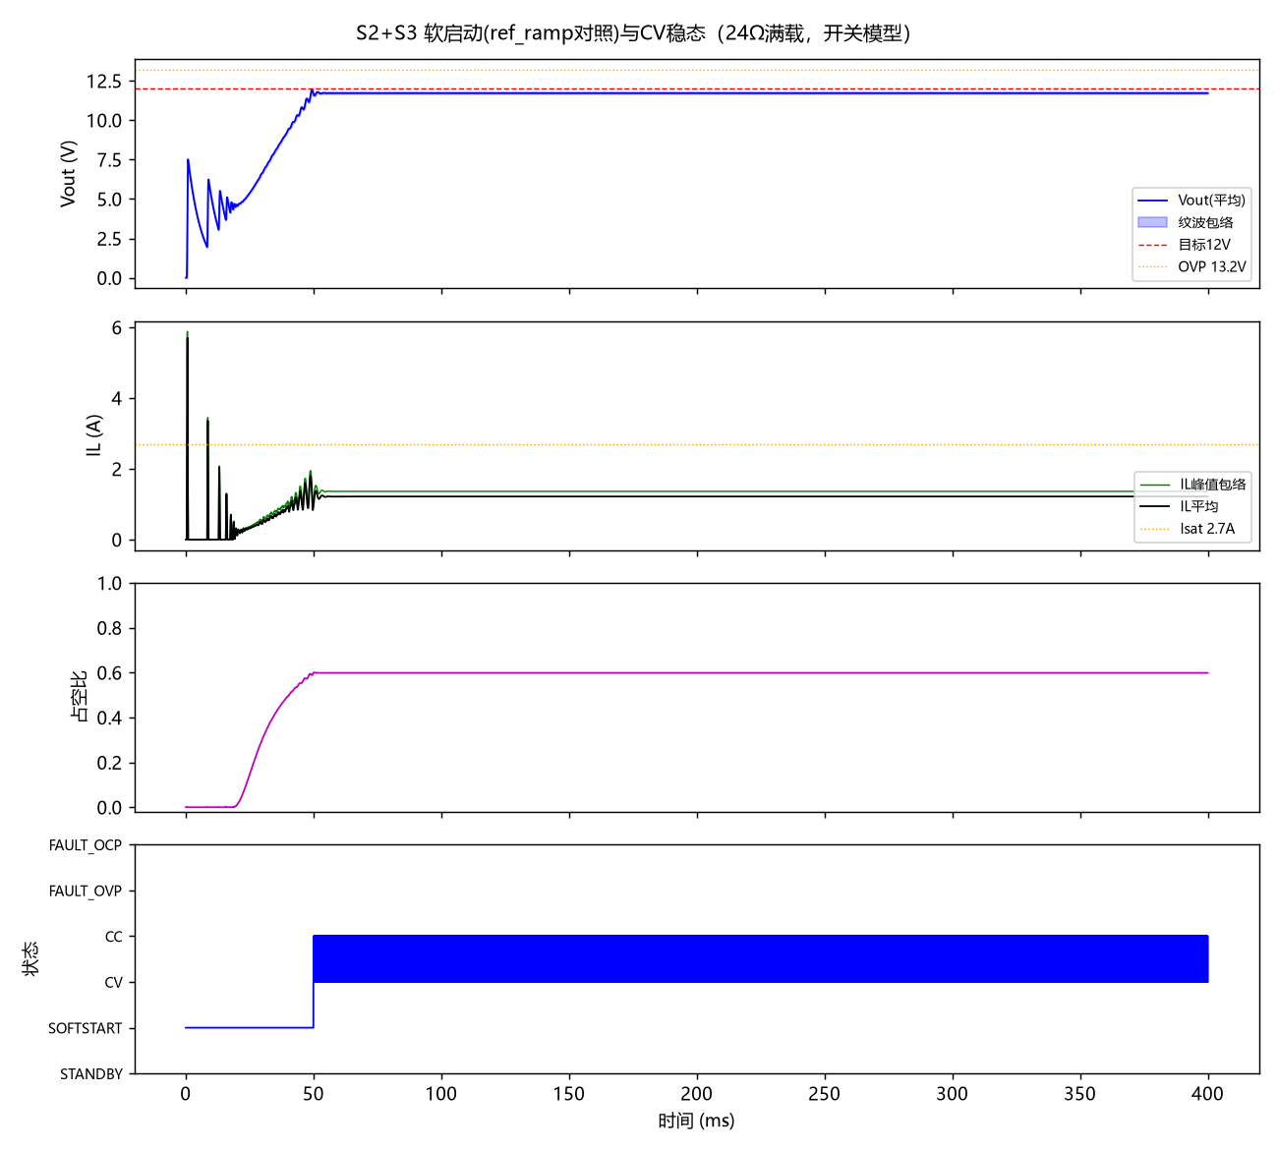
sim/ctrl/results/S2_S3_softstart_steady.png
