lcw578/STM32-project/sim/ctrl/results/S3_track_knee.png

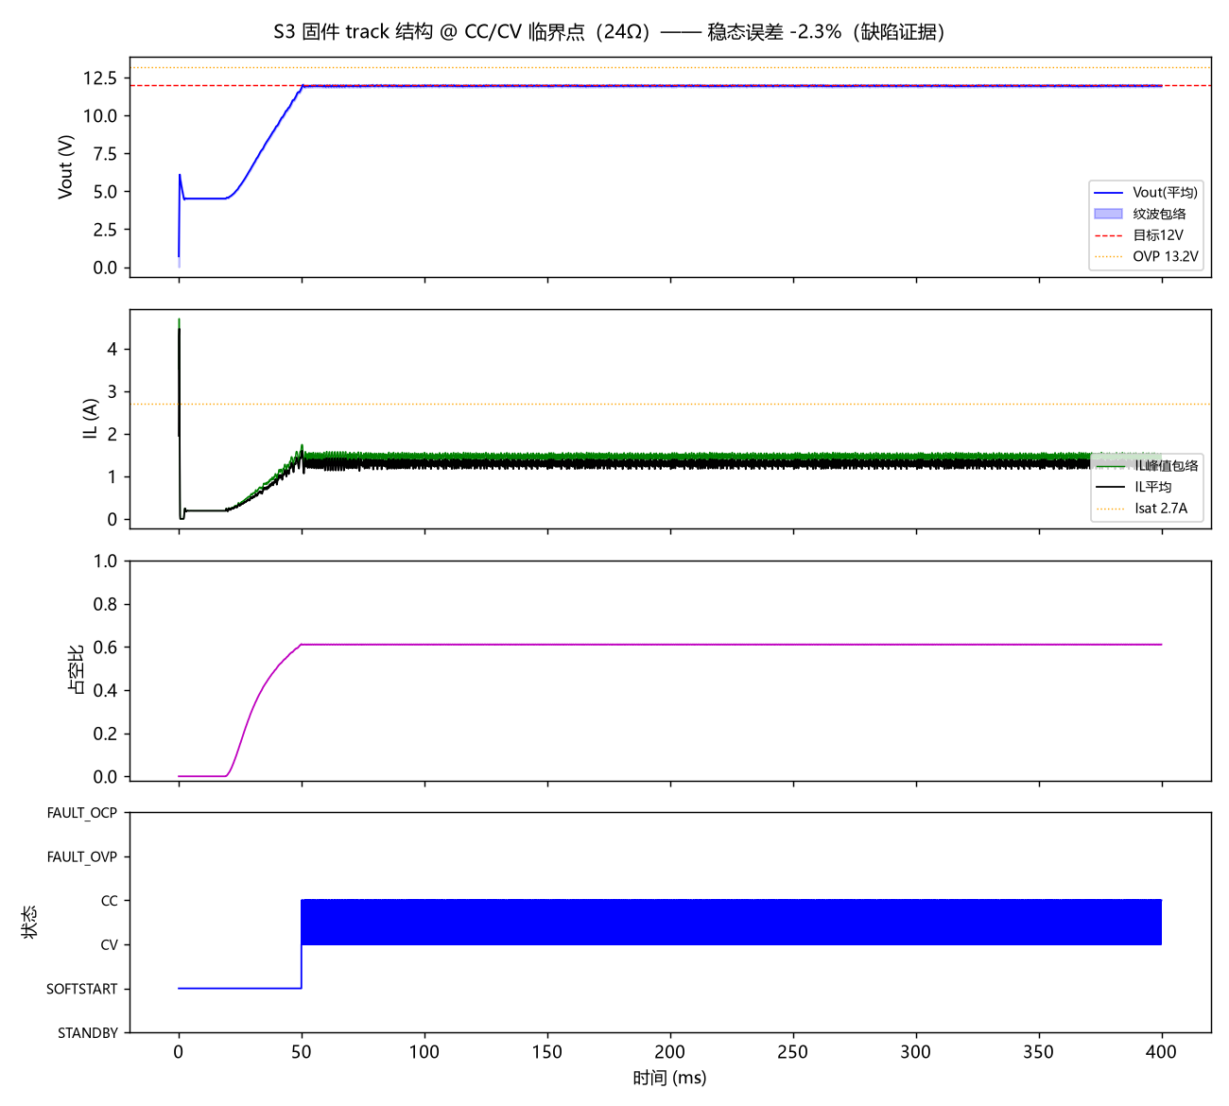
sim/ctrl/results/S3_track_knee.png
