lcw578/STM32-project/sim/ctrl/results/S4_default.png

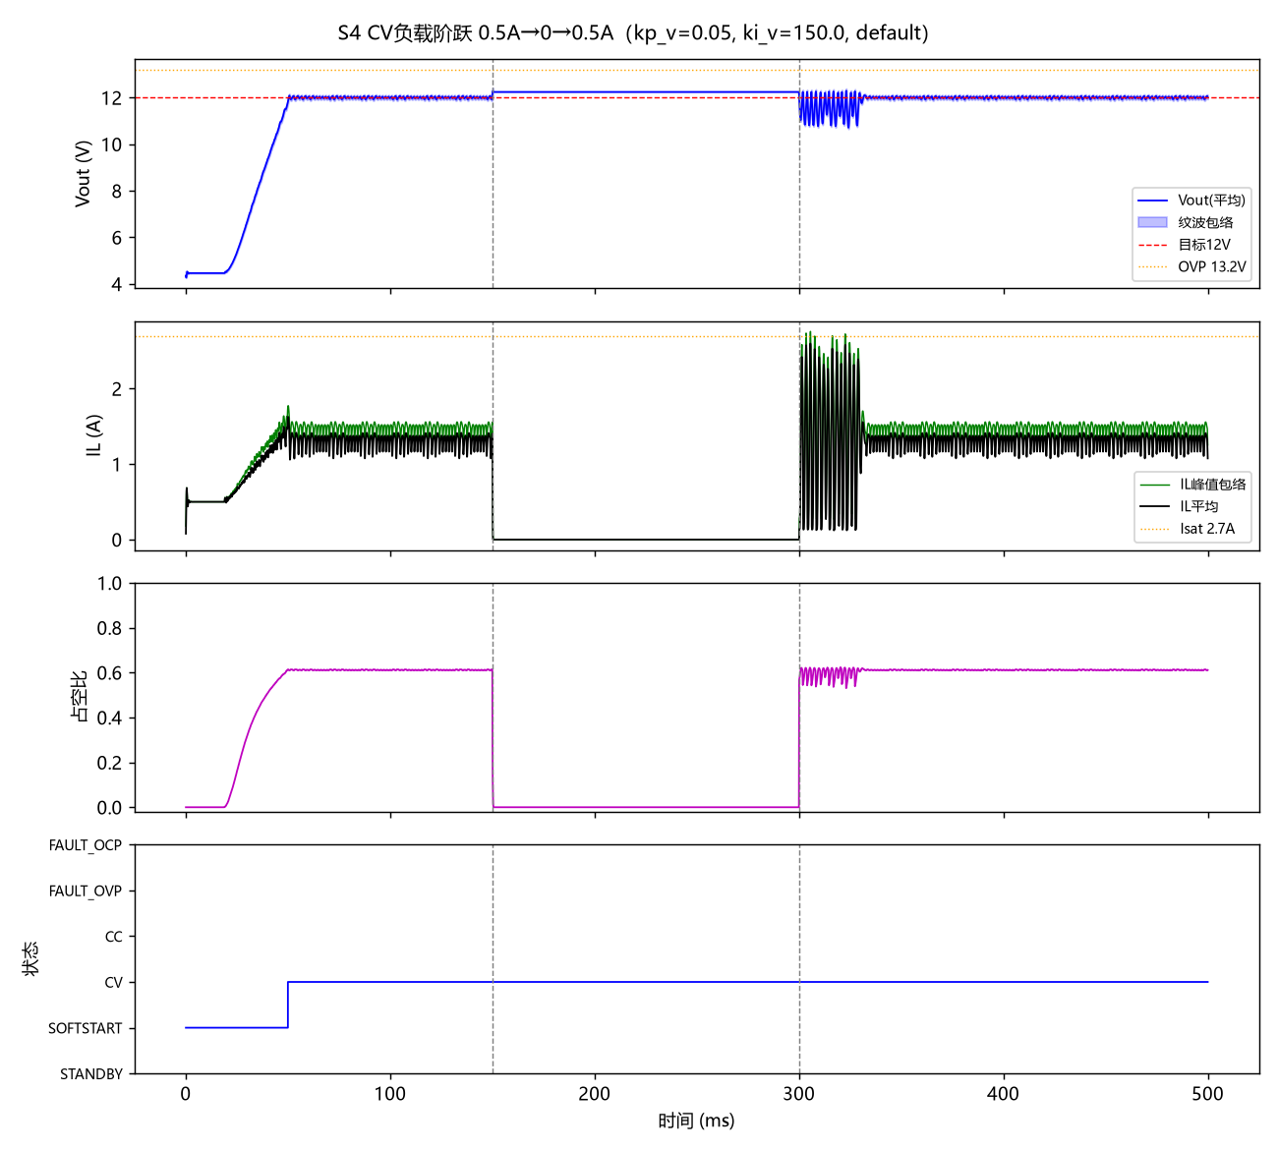
sim/ctrl/results/S4_default.png
