lcw578/STM32-project/sim/ctrl/results/S4_final.png

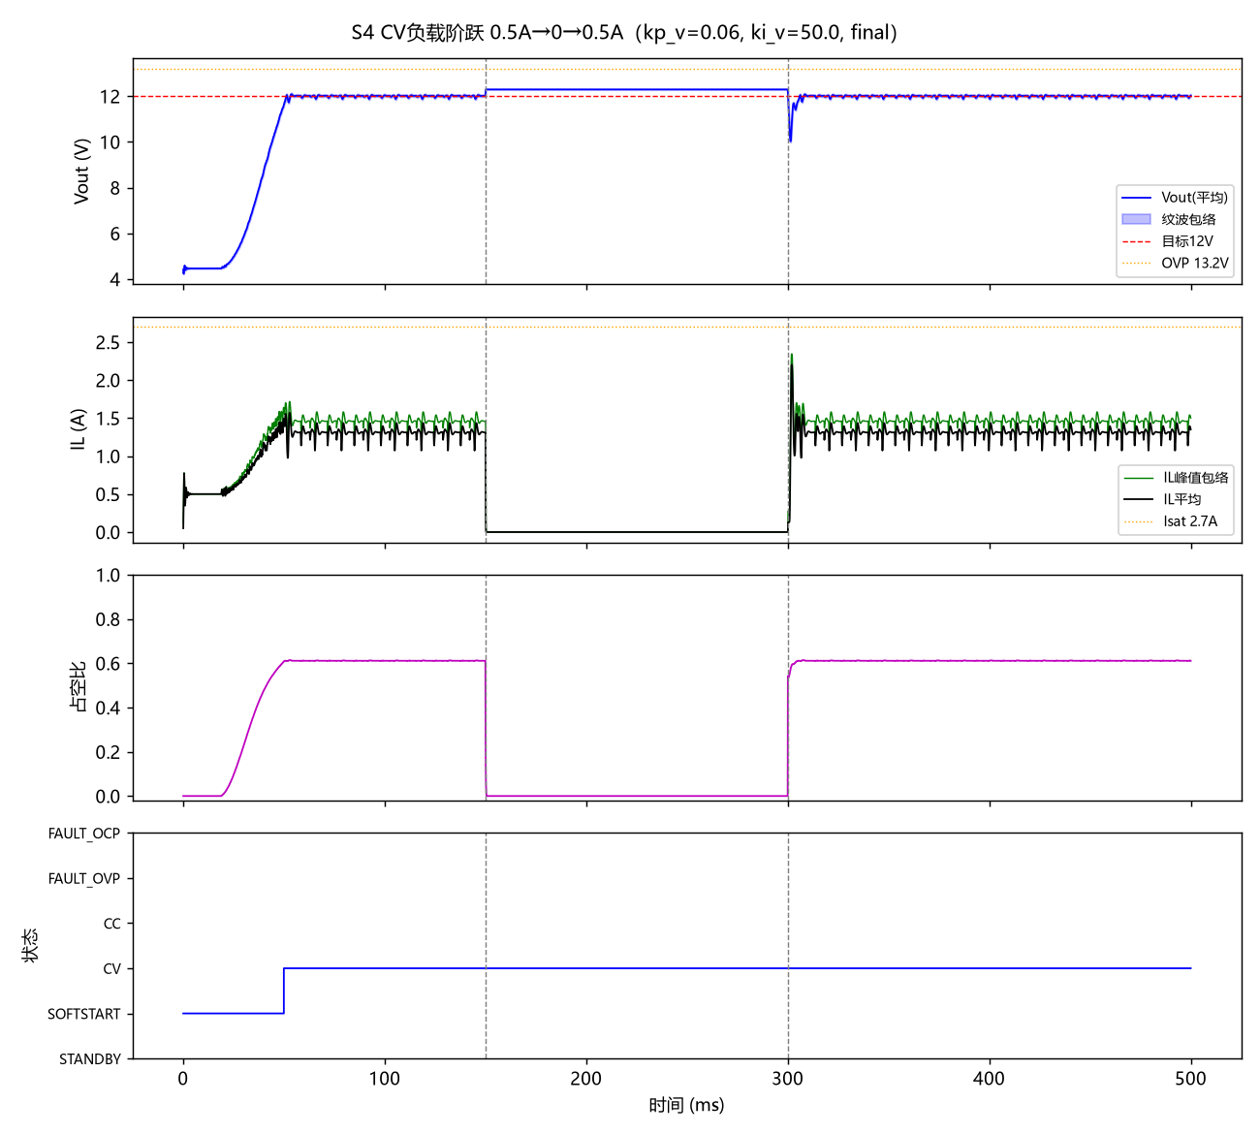
sim/ctrl/results/S4_final.png
