lcw578/STM32-project/sim/ctrl/results/S5_asis_deficit.png

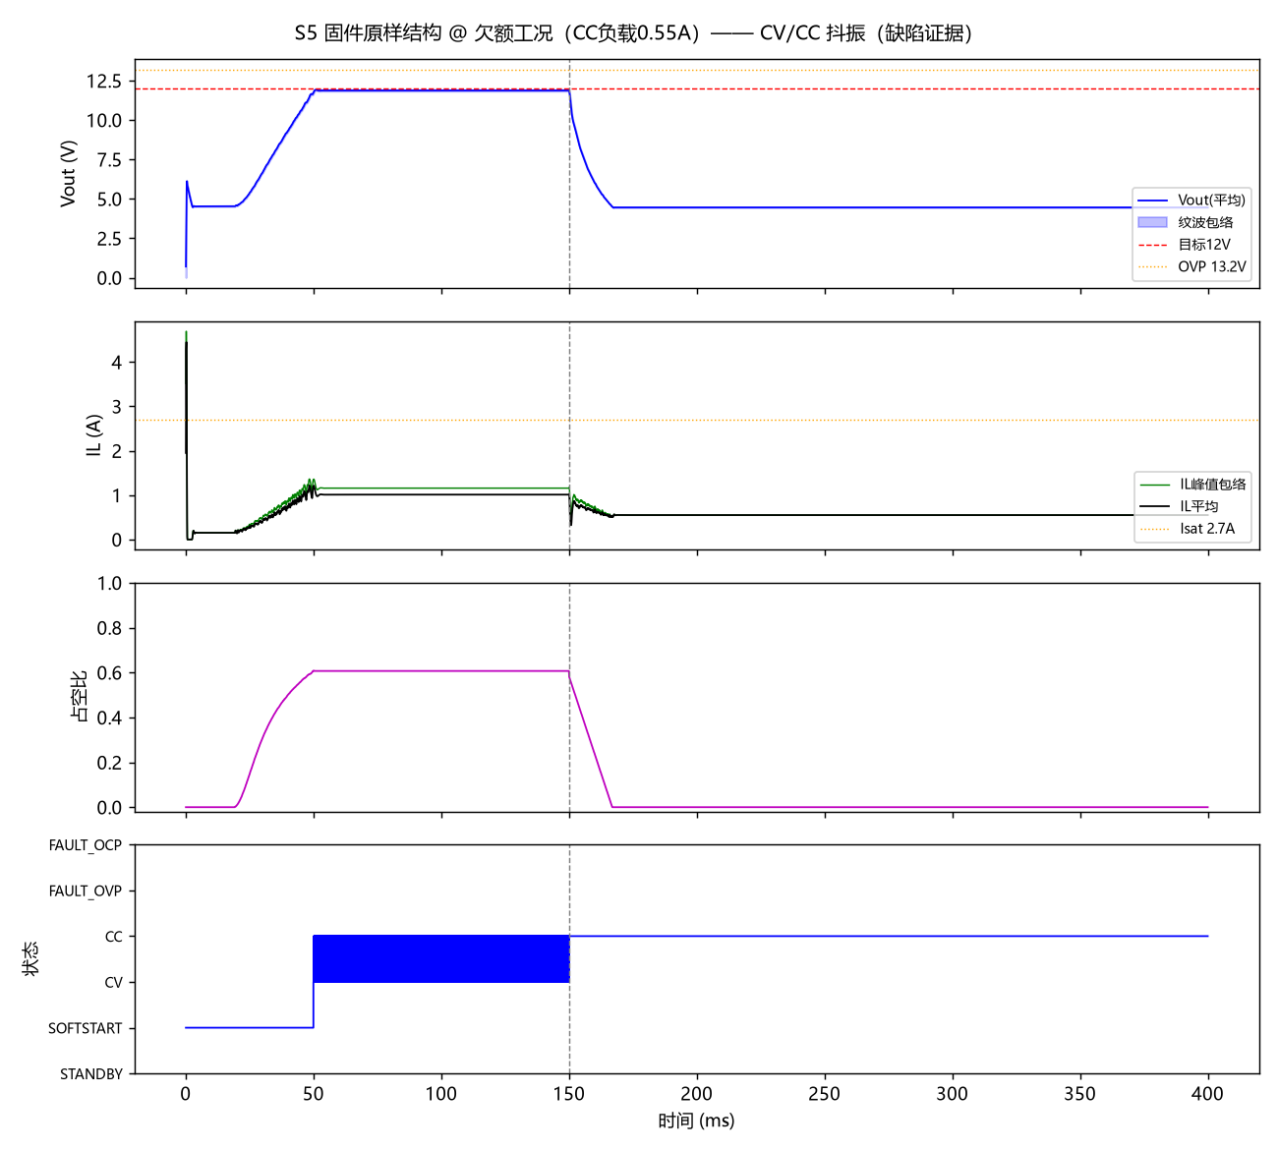
sim/ctrl/results/S5_asis_deficit.png
