lcw578/STM32-project/sim/ctrl/results/S5_cc_cv.png

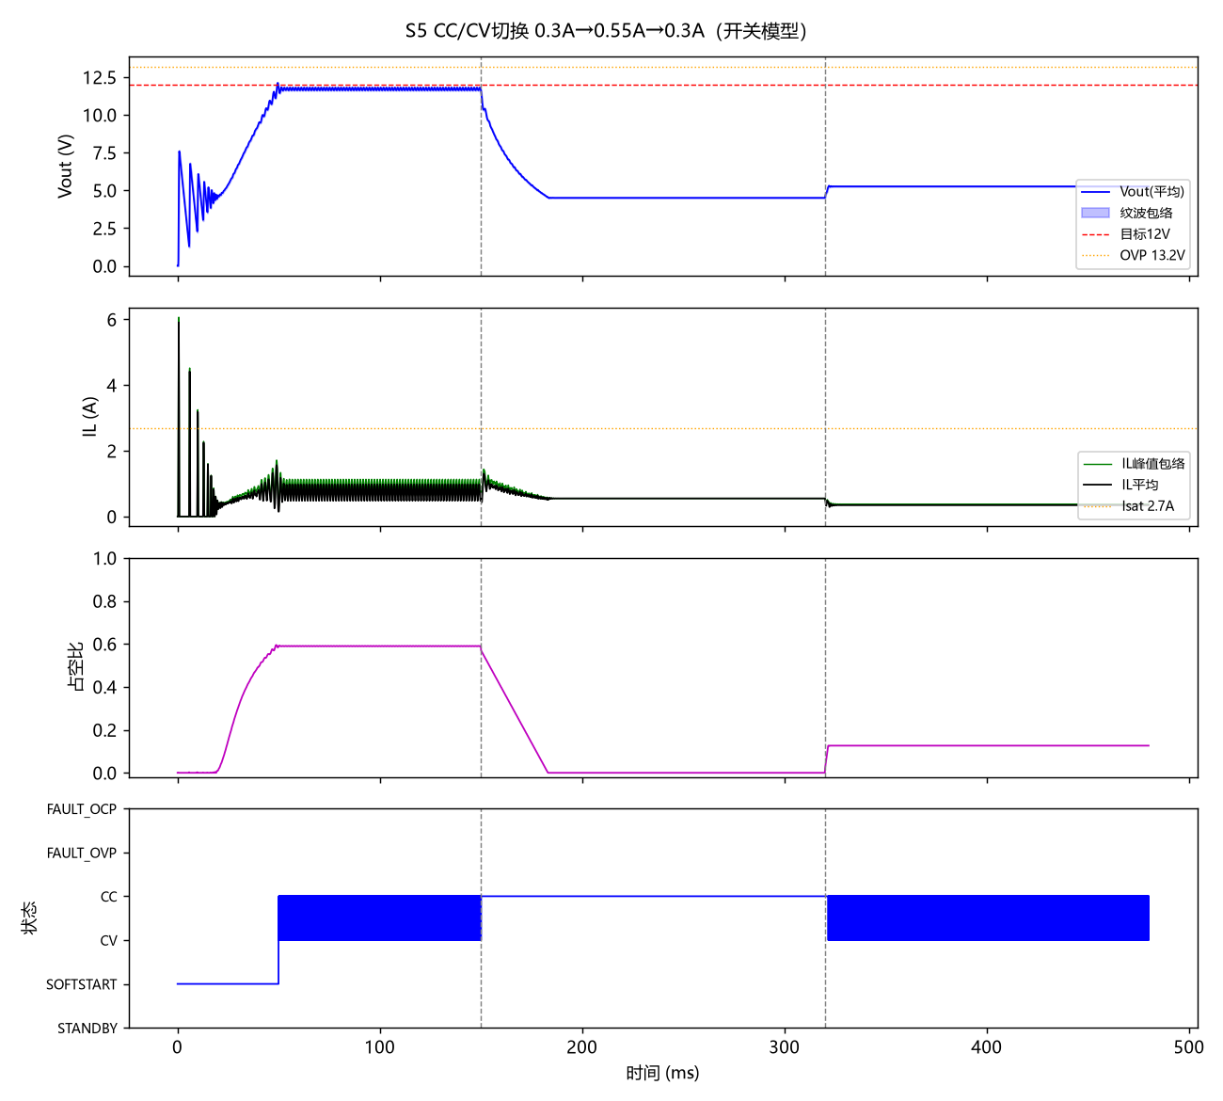
sim/ctrl/results/S5_cc_cv.png
