lcw578/STM32-project/sim/ctrl/results/S5_fixed.png

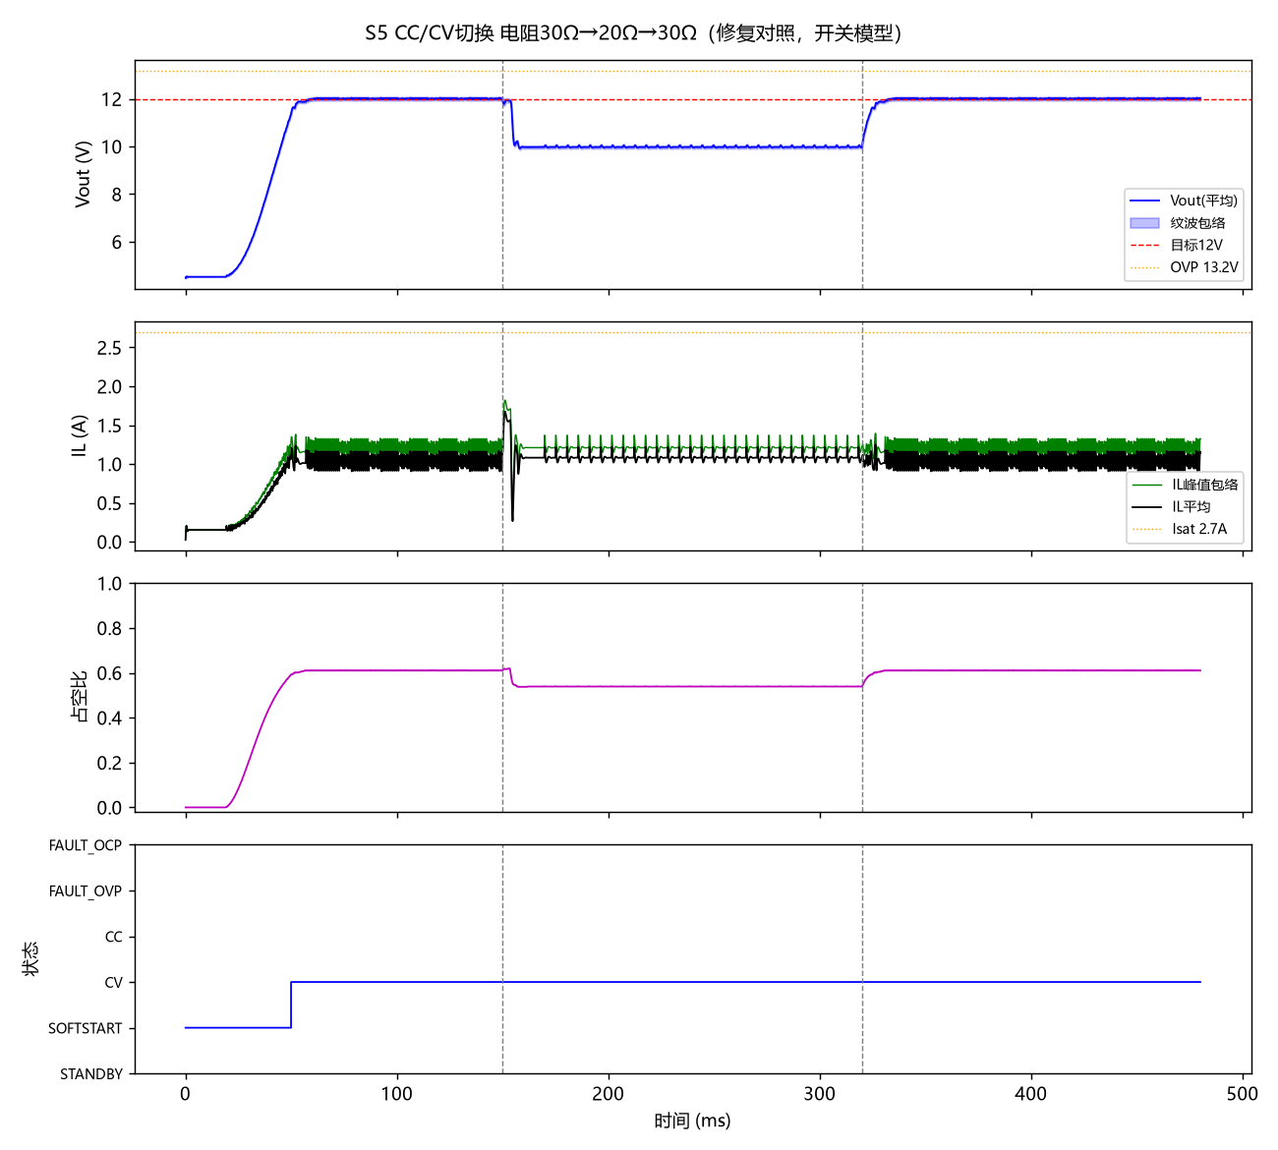
sim/ctrl/results/S5_fixed.png
