lcw578/STM32-project/sim/ctrl/results/S6_short.png

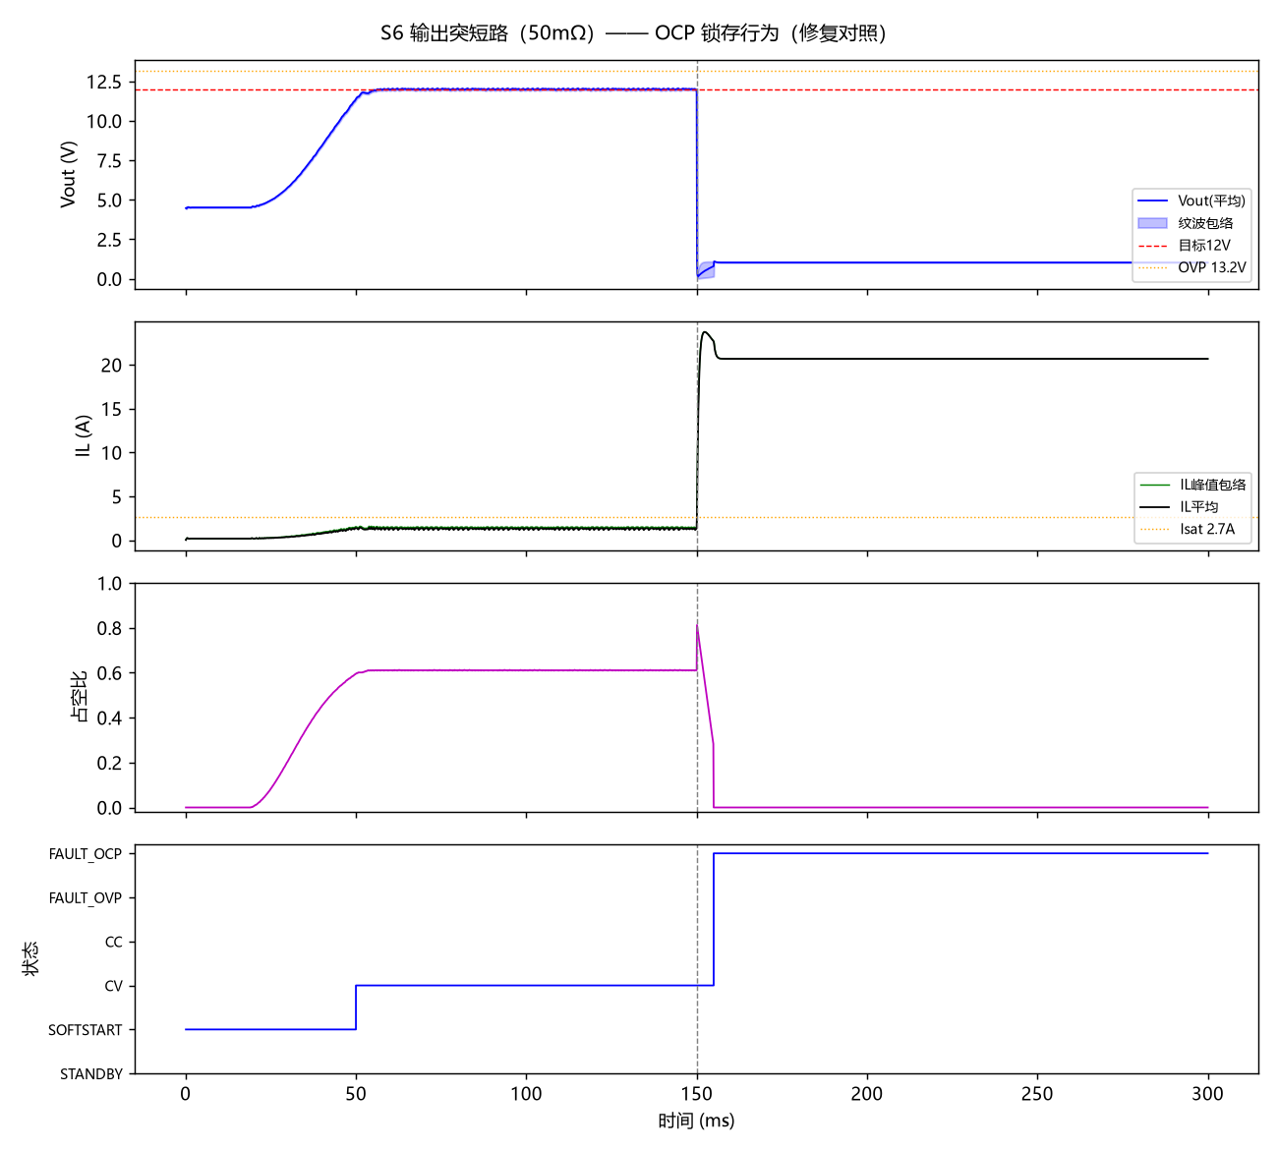
sim/ctrl/results/S6_short.png
