lcw578/STM32-project/sim/ctrl/results/S7_ovp.png

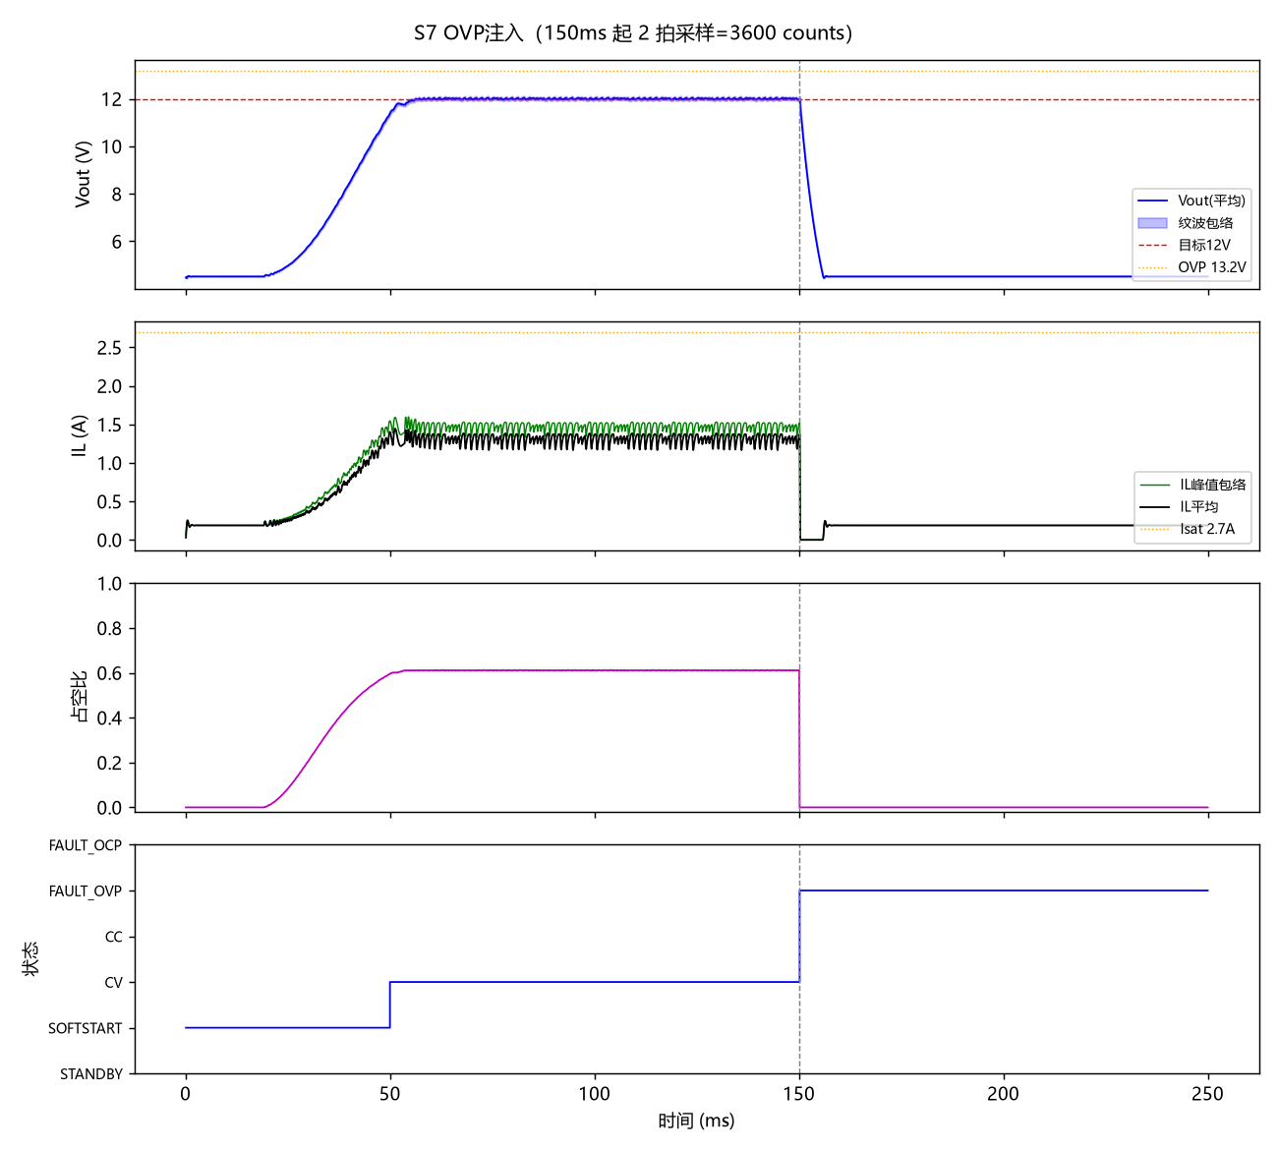
sim/ctrl/results/S7_ovp.png
