lcw578/STM32-project/sim/ctrl/results/S8_sweep.png

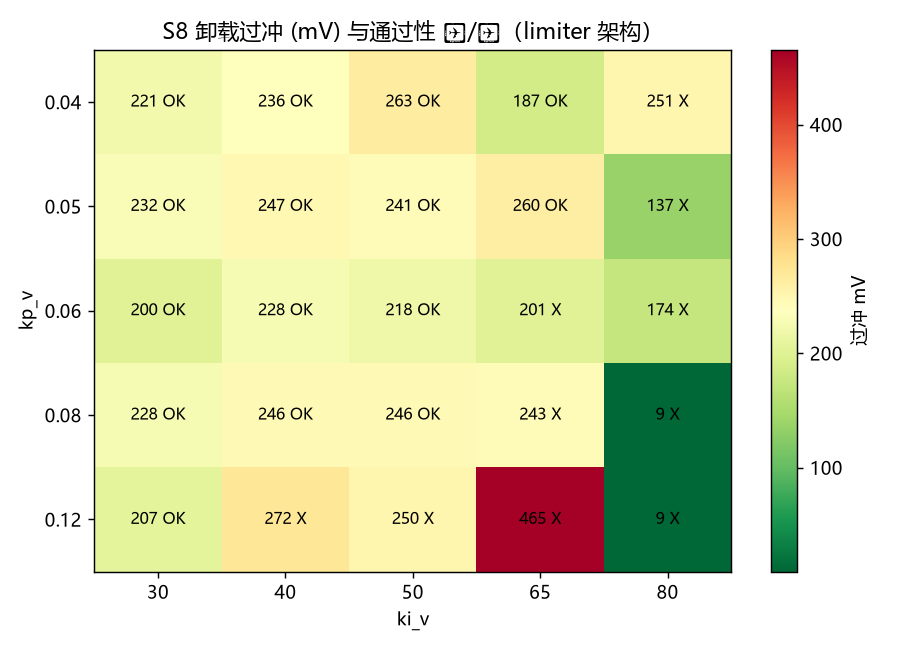
sim/ctrl/results/S8_sweep.png
