lcw578/STM32-project/sim/ctrl/results/S10_vin_sag.png

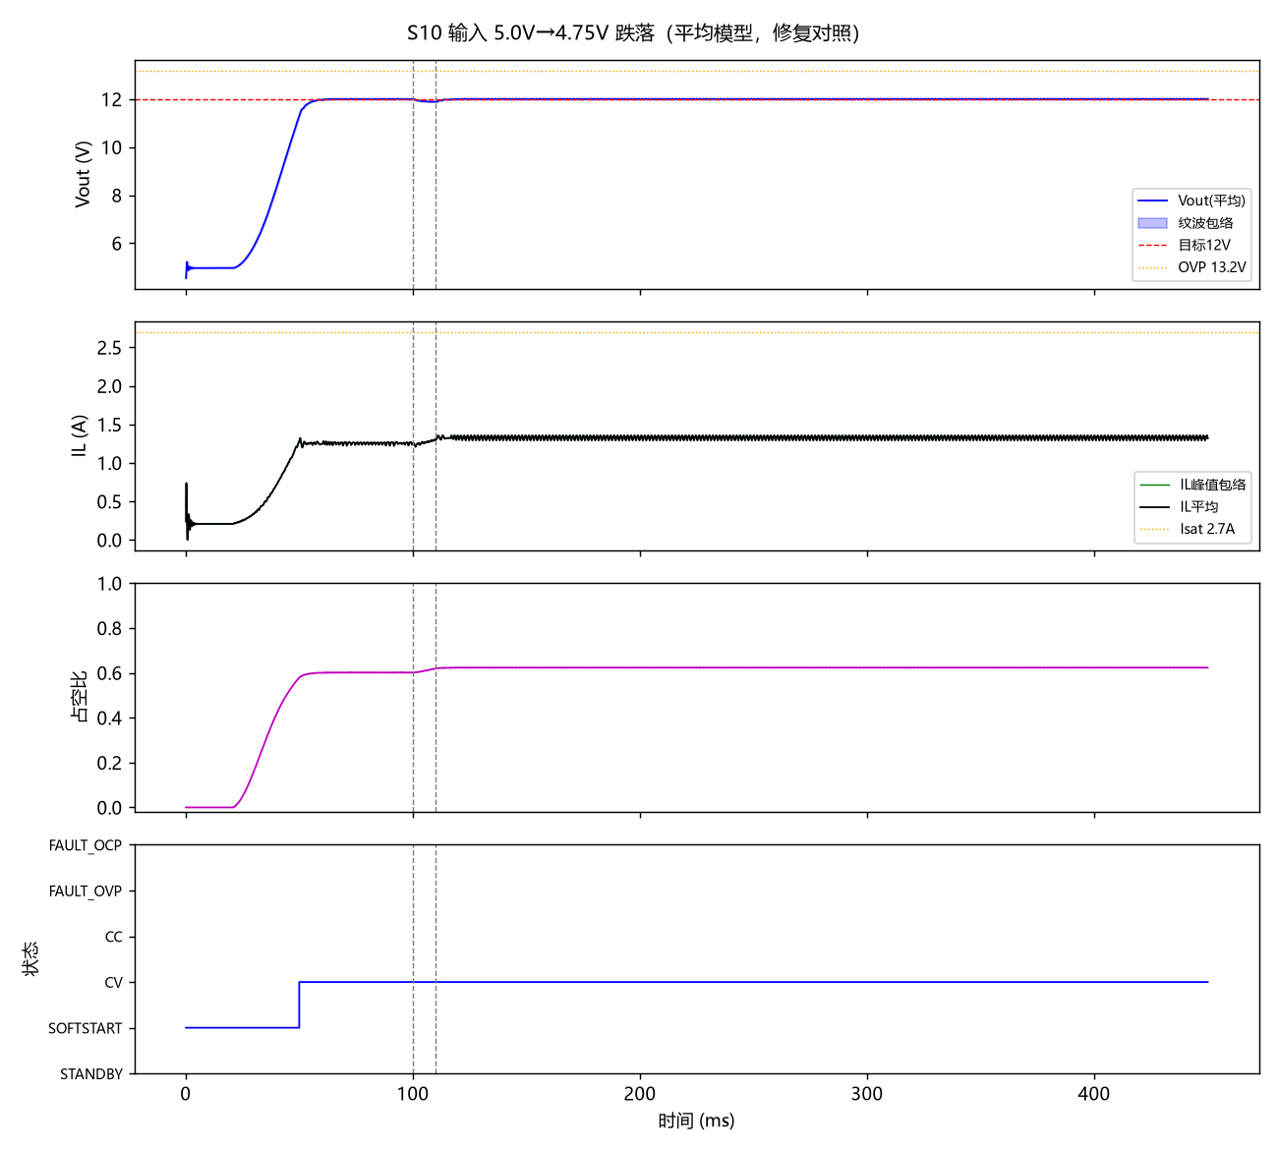
sim/ctrl/results/S10_vin_sag.png
