lcw578/STM32-project/sim/ctrl/results/T_cross_validation.png

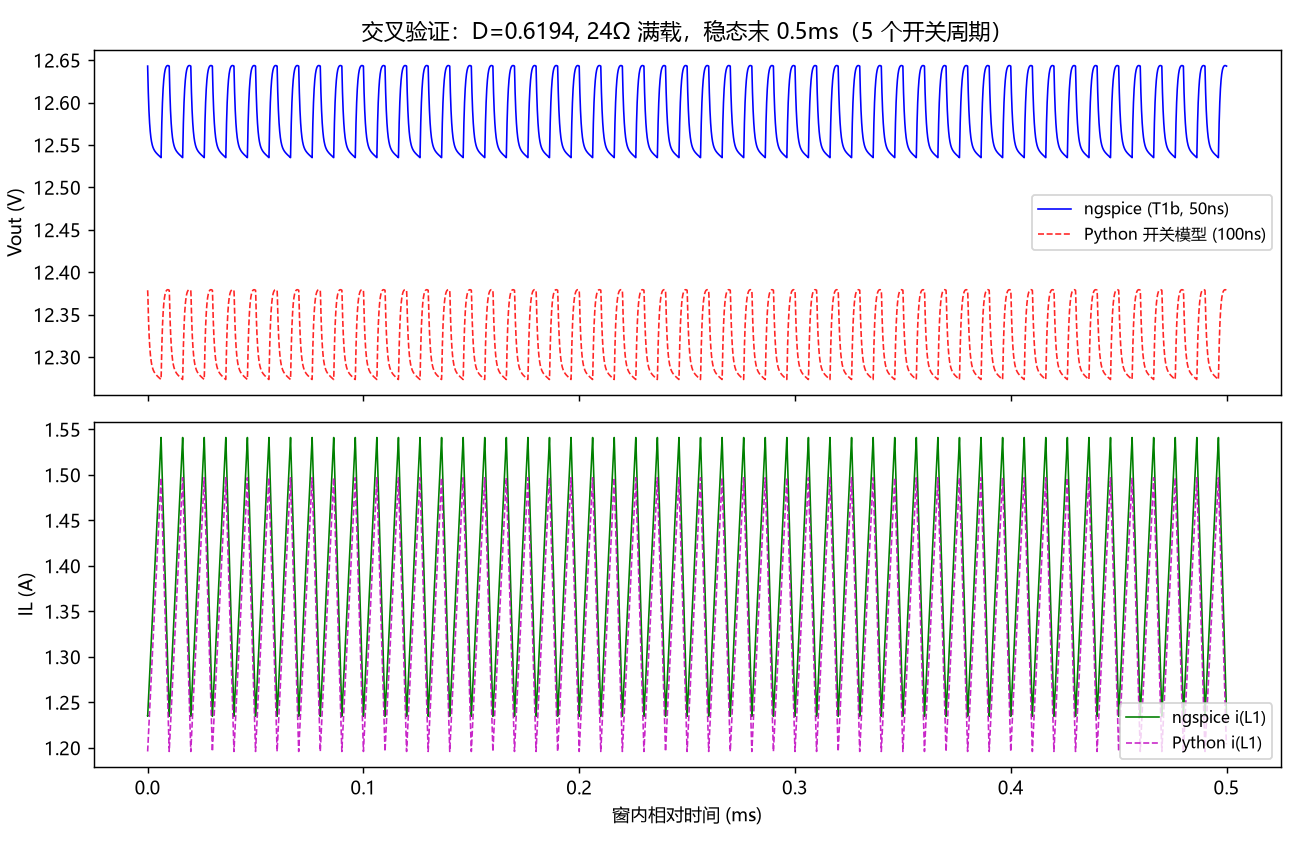
sim/ctrl/results/T_cross_validation.png
