lcw578/STM32-project/(list of files, drawings)

Other design files:
sch_work/archive_v3/pcb_dump_archived.json
sch_work/archive_v3/sch_list_v3.json
sch_work/archive_v3/sch_read_final.json
sch_work/pcb_cfg2.json
sch_work/pcb_cfg.json
sch_work/pcb_check.json
sch_work/pcb_check_v2.json
sch_work/pcb_check_v3.json
sch_work/pcb_dump.json
sch_work/pcb_dump_final.capture.json
sch_work/pcb_dump_v22.capture.json
sch_work/pcb_final_check.json
sch_work/pcb_final_check.json.capture.json
sch_work/pcb_list2.json
sch_work/pcb_list3.json
sch_work/pcb_list.json
sch_work/pcb_list_v2.json
sch_work/pcb_report.json
sch_work/pcb_report_final.json
sch_work/pcb_v2.json
sch_work/pcb_v2.json.capture.json
sch_work/pcb_v3.json
sch_work/pcb_v3.json.capture.json
sch_work/pcb_v4.json
sch_work/pcb_v4.json.capture.json
sch_work/rebuild_review_20261105/pcb_dump.json
sch_work/rebuild_review_20261105/pcb_dump.json.capture.json
sch_work/rebuild_review_20261105/pcb_dump_archived.json
sch_work/rebuild_review_20261105/pcb_dump_archived.json.capture.json
sch_work/rebuild_review_20261105/pcb_dump_as_ordered.json
sch_work/rebuild_review_20261105/pcb_dump_as_ordered.json.capture.json
sch_work/rebuild_review_20261105/pcb_dump_cloud.json
sch_work/rebuild_review_20261105/pcb_dump_cloud.json.capture.json
sch_work/rebuild_review_20261105/pcb_dump_final.json
sch_work/rebuild_review_20261105/pcb_dump_final.json.capture.json
sch_work/rebuild_review_20261105/pcb_dump_now.json
sch_work/rebuild_review_20261105/pcb_dump_now.json.capture.json
sch_work/rebuild_review_20261105/pcb_dump_v2.json
sch_work/rebuild_review_20261105/pcb_dump_v2.json.capture.json
sch_work/rebuild_review_20261105/pcb_dump_v3.json
sch_work/rebuild_review_20261105/pcb_dump_v3.json.capture.json
sch_work/rebuild_review_20261105/pcb_dump_v4.json
sch_work/rebuild_review_20261105/pcb_dump_v4.json.capture.json
sch_work/rebuild_review_20261105/sch_list.json
sch_work/rebuild_review_20261105/sch_list_new.json
sch_work/rebuild_review_20261105/sch_list_v3.json
sch_work/rebuild_review_20261105/sch_read.json
sch_work/rebuild_review_20261105/sch_read_c22.json
sch_work/rebuild_review_20261105/sch_read_final.json
sch_work/rebuild_review_20261105/sch_read_recheck.json
sch_work/rebuild_review_20261105/sch_read_v2_check.json
sch_work/sch_after_clean.json
sch_work/sch_check_now.json
sch_work/sch_conn2.json
sch_work/sch_conn3.json
sch_work/sch_conn4.json
sch_work/sch_conn5.json
sch_work/sch_conn6.json
sch_work/sch_conn7.json
sch_work/sch_conn8.json
sch_work/sch_conn.json
sch_work/sch_drc.json
sch_work/sch_final_check.json
sch_work/sch_read_after_sw.json
sch_work/sch_read_before.json
sch_work/sch_read_c11.json
sch_work/sch_read_c11b.json
sch_work/sch_read_f1.json
sch_work/sch_read_f1b.json
sch_work/sch_read_f1c.json
sch_work/sch_read_f1d.json
sch_work/sch_read_f1e.json
sch_work/sch_read_f1f.json
sch_work/sch_read_f1h.json
sch_work/sch_read_final2.json
sch_work/sch_read_final3.json
sch_work/sch_read_final.json
sch_work/sch_read_l1.json
sch_work/sch_read_mid1.json
sch_work/sch_read_mid2.json
sch_work/sch_read_now2.json
sch_work/sch_read_q3fix.json
sch_work/sch_read_sw_now.json
sch_work/sch_read_teammate.json
sch_work/sch_read_v2.json
