lcw578/STM32-project/firmware/Core/Src/main.c

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
/* Includes ------------------------------------------------------------------*/
#include "main.h"
#include "adc.h"
#include "usart.h"
#include <stdio.h>

/* USER CODE BEGIN Includes */
#include "bsp_power.h"
#include "control.h"
#include "cli.h"
/* USER CODE END Includes */

ADC_HandleTypeDef hadc1;
UART_HandleTypeDef huart1;

void SystemClock_Config(void);
static void MX_GPIO_Init(void);
static void MX_ADC1_Init(void);
static void MX_USART1_UART_Init(void);

int main(void)
{
  /* MCU Configuration--------------------------------------------------------*/

  /* Reset of all peripherals, Initializes the Flash interface and the Systick. */
  HAL_Init();

  /* Configure the system clock */
  SystemClock_Config();

  /* Initialize all configured peripherals */
  MX_GPIO_Init();
  MX_ADC1_Init();
  MX_USART1_UART_Init();

  /* USER CODE BEGIN 2 */
  /* 强制时钟 72MHz（不依赖生成配置），并重配 ADC/TIM 为本设计参数 */
  bsp_force_clock_72mhz();
  bsp_gpio_init();
  bsp_tim1_pwm_init();      /* 100kHz PWM，占空比 0（安全态） */
  bsp_tim2_ctrl_tick_init();/* 10kHz 控制节拍 */
  bsp_adc_start();          /* Vout/Isense 双通道 DMA 连续采样 */
  control_init();

  cli_println("\r\n=== Boost CCCV PSU fw v1.0 ===");
  cli_println("type h for help, on to start");
  cli_printf_status();
  /* USER CODE END 2 */

  /* Infinite loop */
  /* USER CODE BEGIN WHILE */
  while (1)
  {
    /* 控制环已搬到 TIM2 更新中断（10kHz）；主循环只跑非阻塞的命令行，
     * 串口打印再慢也不会再丢控制拍。 */
    cli_poll();
    /* USER CODE END WHILE */

    /* USER CODE BEGIN 3 */
  }
  /* USER CODE END 3 */
}

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
void Error_Handler(void)
{
  __disable_irq();
  while (1) { }
}
