lcw578/STM32-project/(commit log)

2026-11-03 v2 定稿：Boost 恒压恒流电源全量入库
    - 文档 01-07：指标对齐表（03 §11）、审计闭环（04）、v2 改版与固件说明（05/06）、3D 检查（07）
    - 仿真：sim/ctrl 全场景复跑存档（τ=88.3µs 实装值 + 保守对照），控制律与固件逐行对齐
    - 固件：firmware/Core v2（斜坡基准 + limiter + 前馈 + 三重保护 + TIM2 中断）
    - 证据：sch_work 网表/DRC/BOM/3D 导出、布局图；Gerber 终版 zip
    - 协作：README 含组员 AI 接手指南与协作铁律
    [BOM_v2.csv, BOM_结构件.csv, T1b_wave.csv, pcb_cfg.json, pcb_cfg2.json, pcb_check.json, pcb_check_v2.json, pcb_check_v3.json]
2026-11-03 README：第六节改为待办清单；补充 EDA 工程分享方式（A 协作/B 快照）
2026-11-03 README：加入 EDA 工程链接（oshwhub 主页 + 编辑器直开）
2026-11-03 Gerber v2.1：全板补泪滴版发板包（DRC 0 违规）
    - PCB 补泪滴后重建 GND 铺铜（铺铜让位泪滴，间距恢复 ≥10mil），DRC 80→0
    - 顶层铜 122K→174K、底层 43.6K→65K，泪滴已进 Gerber 铜层（14 文件集一致）
    - 替换发板包：v2_final（无泪滴）→ v2.1_teardrop；DRC 证据存 sch_work/drc_after_rebuild.json
    - README 同步新包名与泪滴说明
    [sch_read_teammate.json]
2026-11-03 README：补充 J3(SWD)/J4(UART) 调试口线序表与使用规则
2026-11-03 F1 保险丝换购国内现货同规格：C99555(国际站)→C41342(Littelfuse 0468003.NRHF, 3A/32V/1206, 现货2.4万)
    - BOM_v2.csv F1 行料号更新；01 BOM 行同步并注明原因
    - 避雷说明：SMD1206-050-33 是 PPTC 自恢复(Ihold 0.5A)，不可替代快断保险丝
    [BOM_v2.csv, sch_read_after_sw.json, sch_read_now2.json]
2026-11-03 v2.2：SW1 复位键接线修正（1=NRST/3=GND，实物万用表确认）+ R1 焊盘对齐 + F1 恢复归位
    - SW1：同伴实物万用表实测 1-2 同极 → 原接法(1=NRST/2=GND)致命，改为 1=NRST/3=GND（已实测确认）
    - R1：组员镜像导致焊盘对调 → PCB 旋转 180° 对齐走线
    - F1：替换为 C41342 (Littelfuse 0468003.NRHF 3A/32V) 并恢复原位 (580,1500)，VIN_RAW/VIN_5V 通路重连
    - 变更导入 PCB + 补 6 段走线 + 铺铜重建 → DRC 0 违规；终态对账 28/28 ✓
    - Gerber v2.2 替换 v2.1；原理图 SW1.2/4 补 NC 旗
    [pcb_dump_final.capture.json, pcb_dump_v22.capture.json, sch_read_f1.json, sch_read_f1b.json, sch_read_f1c.json, sch_read_f1d.json, sch_read_f1e.json, sch_read_f1f.json]
2026-11-06 v3 重建版定稿发板：原理图平替+位号重排（29 网逐网 diff 无损）、固件 v2.1 常数（Rs1 0.1Ω 口径/OCP 0.6A/LOAD_FF 0.13）、仿真 S1-S10 复跑全过、F1 恢复保险丝 C41342、混合输出电容（220µF/50V 电解+2×22µF 陶瓷）、BOM_v3 + 发板归档证据 + 08 发板说明
    [BOM_v3.csv, pcb_dump.json, pcb_dump.json.capture.json, pcb_dump_archived.json, pcb_dump_archived.json.capture.json, pcb_dump_as_ordered.json, pcb_dump_as_ordered.json.capture.json, pcb_dump_cloud.json]
